diegocoll/top_level_pcb/Modulo de alimentador/Imágenes/Diagrama_Circuital.PNG

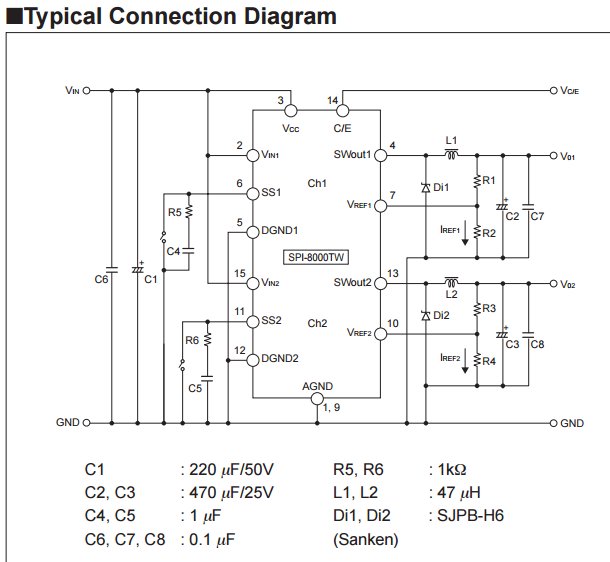
Modulo de alimentador/Imágenes/Diagrama_Circuital.PNG
