diegocoll/top_level_pcb/Modulo de alimentador/Imágenes/Regulador.PNG

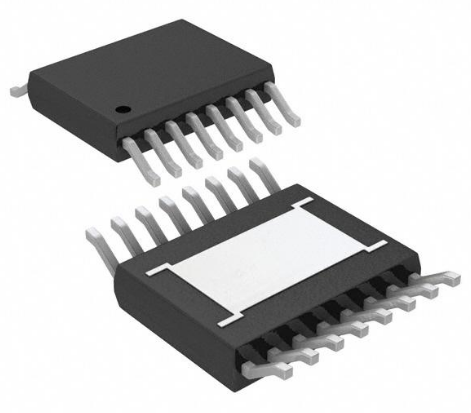
Modulo de alimentador/Imágenes/Regulador.PNG
