diegocoll/top_level_pcb/Modulo de alimentador/Imágenes/render01.png

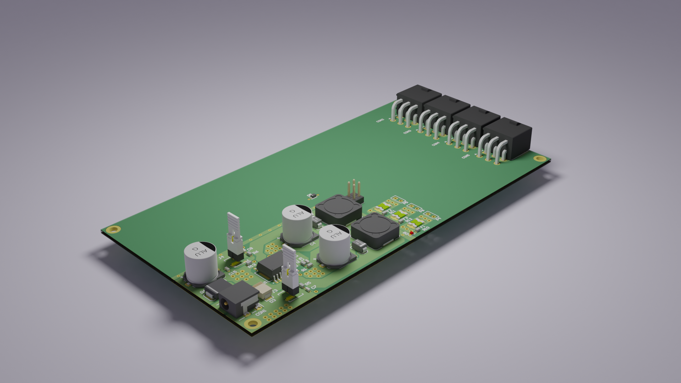
Modulo de alimentador/Imágenes/render01.png
