diegocoll/top_level_pcb/Modulo de alimentador/Imágenes/render02.png

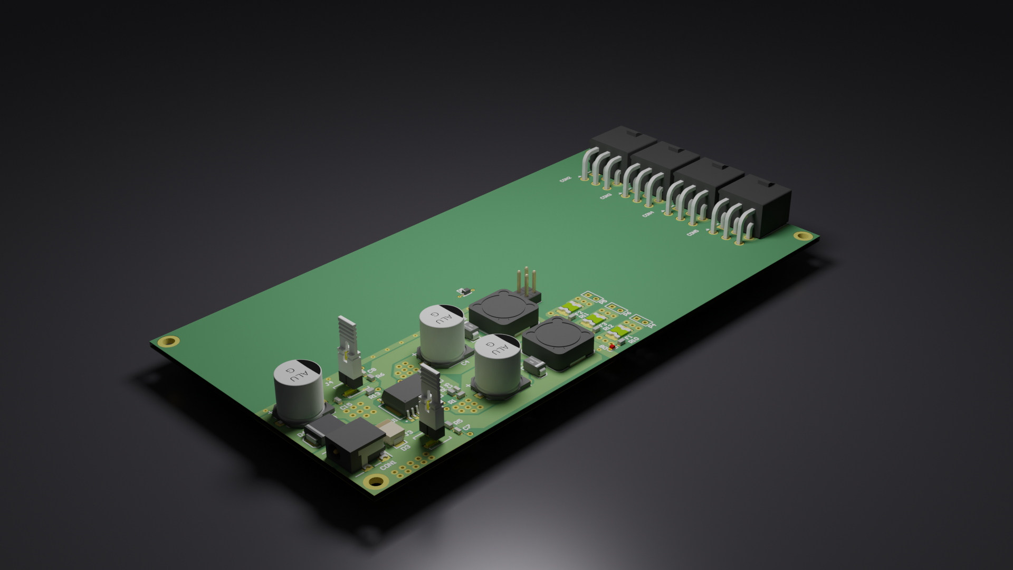
Modulo de alimentador/Imágenes/render02.png
