diegocoll/top_level_pcb/Modulo de comunicación/Imágenes/PDN_modulo_comunicacion.png

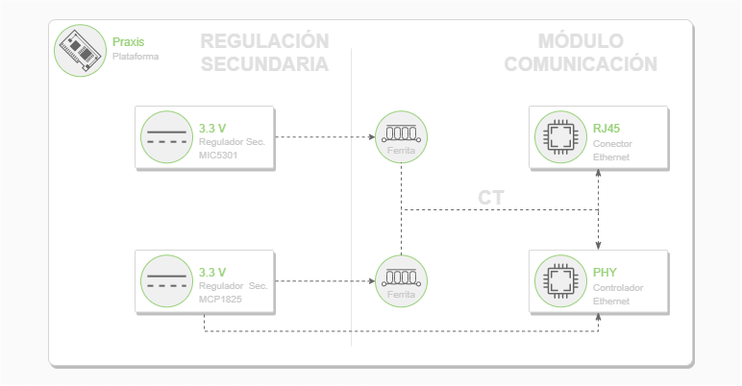
Modulo de comunicación/Imágenes/PDN_modulo_comunicacion.png
