diegocoll/top_level_pcb/Modulo de comunicación/Imágenes/PDN_modulo_comunicacion_01.png

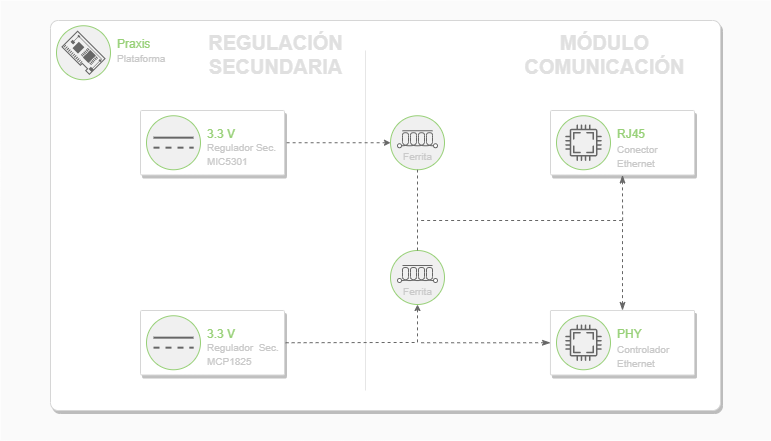
Modulo de comunicación/Imágenes/PDN_modulo_comunicacion_01.png
