diegocoll/top_level_pcb/Modulo de comunicación/Imágenes/perspectiva .png

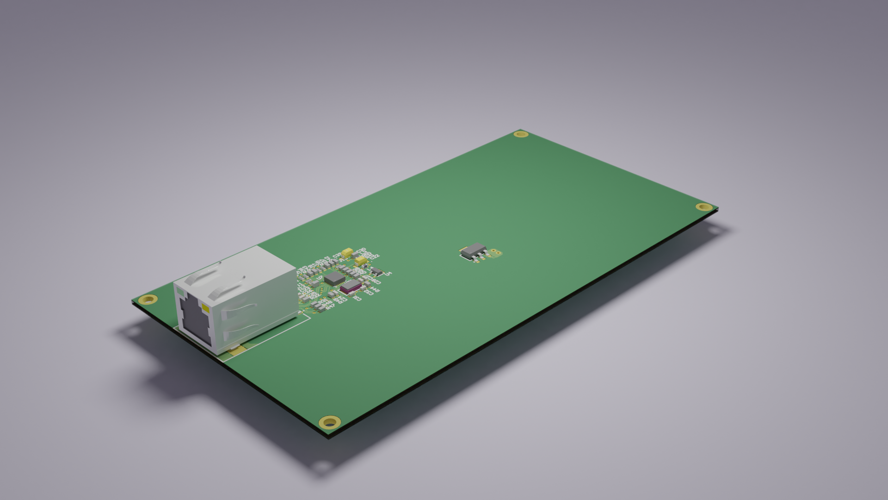
Modulo de comunicación/Imágenes/perspectiva .png
