diegocoll/top_level_pcb/Modulo de programador/Imágenes/Render.png

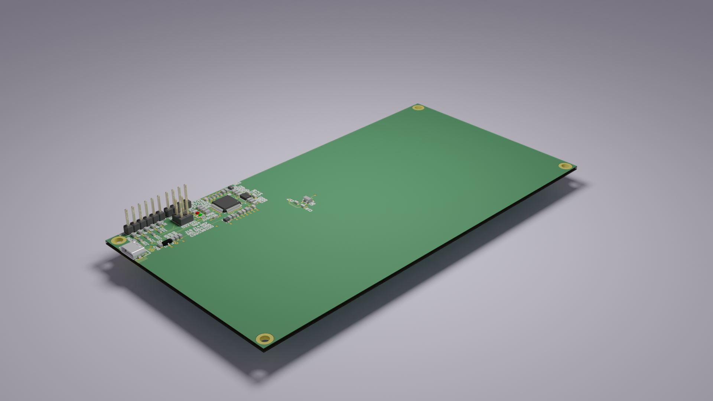
Modulo de programador/Imágenes/Render.png
