diegocoll/top_level_pcb/Modulo de alimentador/Altium/Componentes/CAP_PCE4009CT/EEEFC1E471P.STEP

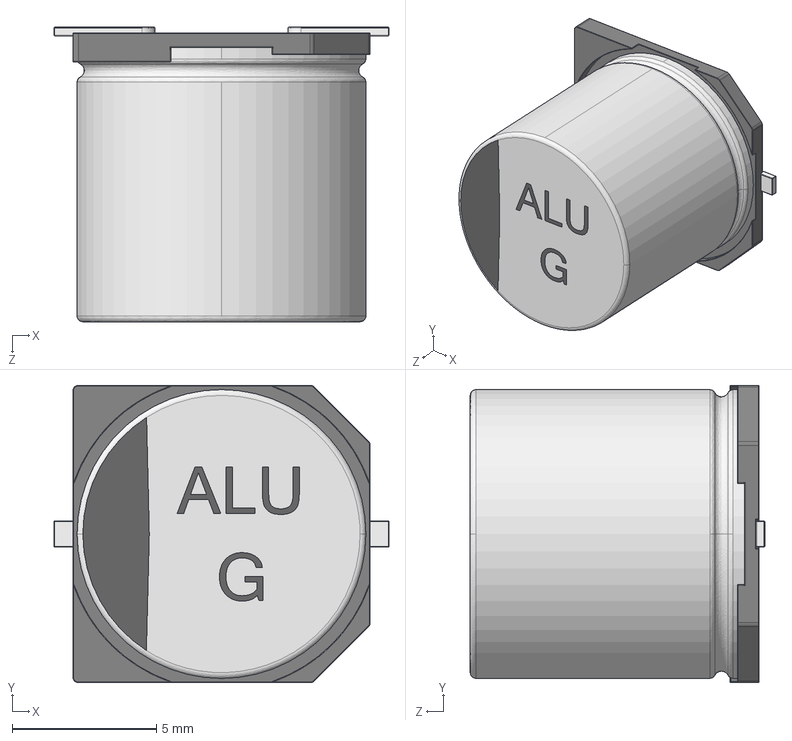
[picture p11: CAD file, 2021-07-18]
Modulo de alimentador/Altium/Componentes/CAP_PCE4009CT/EEEFC1E471P.STEP
11.6 x 10.3 x 10.2 mm
Pins_1
Fuss_1
K_X_F6rper_1
Beschriftung_1
