diegocoll/top_level_pcb/Modulo de alimentador/Altium/Componentes/INDUCTOR_SMD_1240/SRR1240.STEP

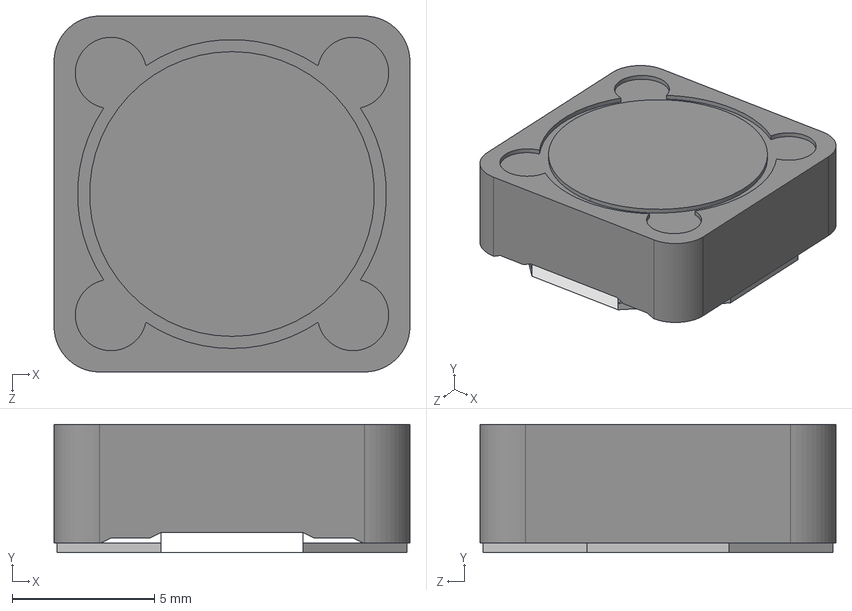
[picture p12: CAD file, 2021-07-18]
Modulo de alimentador/Altium/Componentes/INDUCTOR_SMD_1240/SRR1240.STEP
12.5 x 4.50 x 12.5 mm
