diegocoll/top_level_pcb/Modulo de alimentador/Altium/Componentes/JUMPER/TSM-102-01-L-SV-TR.stp

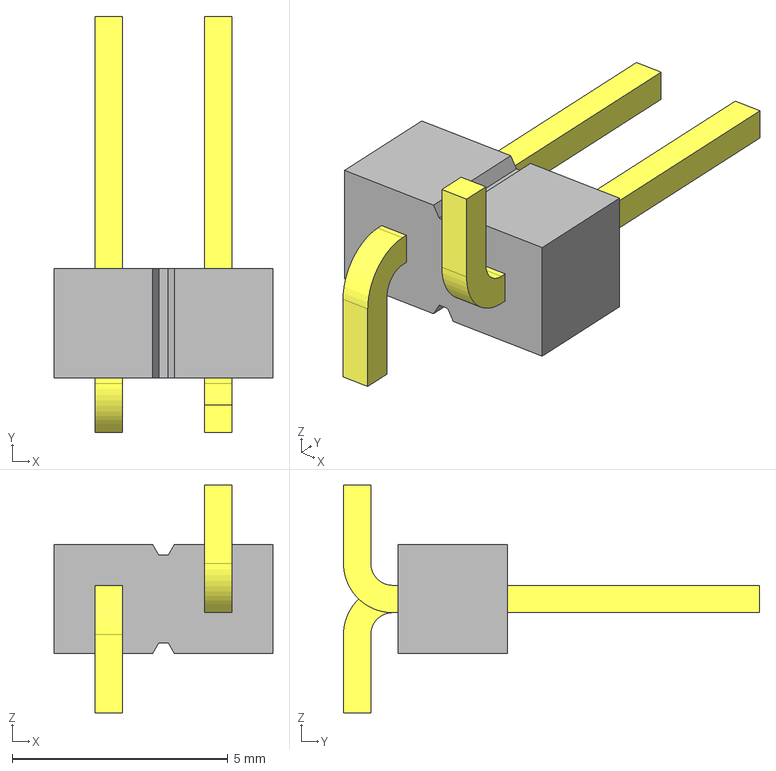
[picture p13: CAD file, 2021-07-18]
Modulo de alimentador/Altium/Componentes/JUMPER/TSM-102-01-L-SV-TR.stp
5.08 x 9.65 x 5.28 mm
_TSM-102-01-SV_body
_T-1S6-16(-01-2-SV)
