diegocoll/top_level_pcb/Modulo de alimentador/Altium/Componentes/LD3985M33R/2020-03-27_06-20-10/STEP/SOT23-5L-L.step

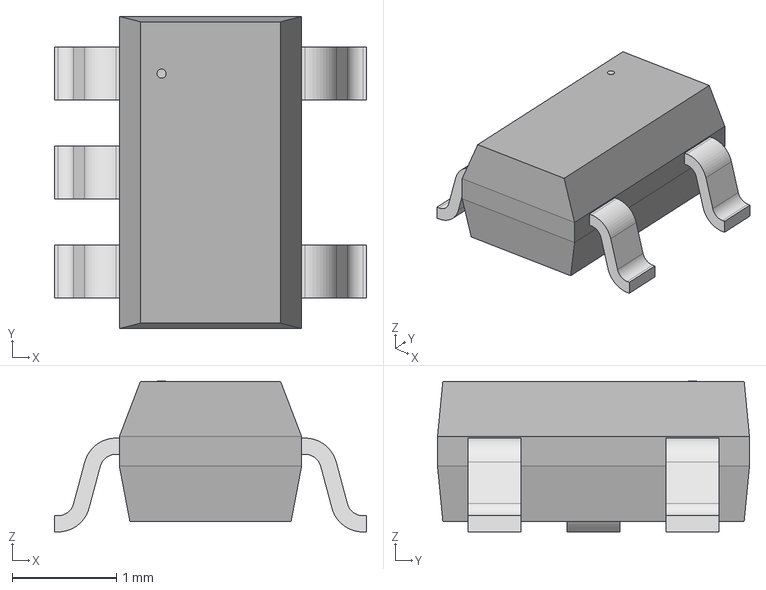
[picture p14: CAD file, 2021-07-18]
Modulo de alimentador/Altium/Componentes/LD3985M33R/2020-03-27_06-20-10/STEP/SOT23-5L-L.step
3.00 x 3.00 x 1.45 mm
