diegocoll/top_level_pcb/Modulo de alimentador/Altium/Componentes/MCP1825S-3302E/2020-03-27_02-06-16/STEP/SOT-223_3MC-M.step

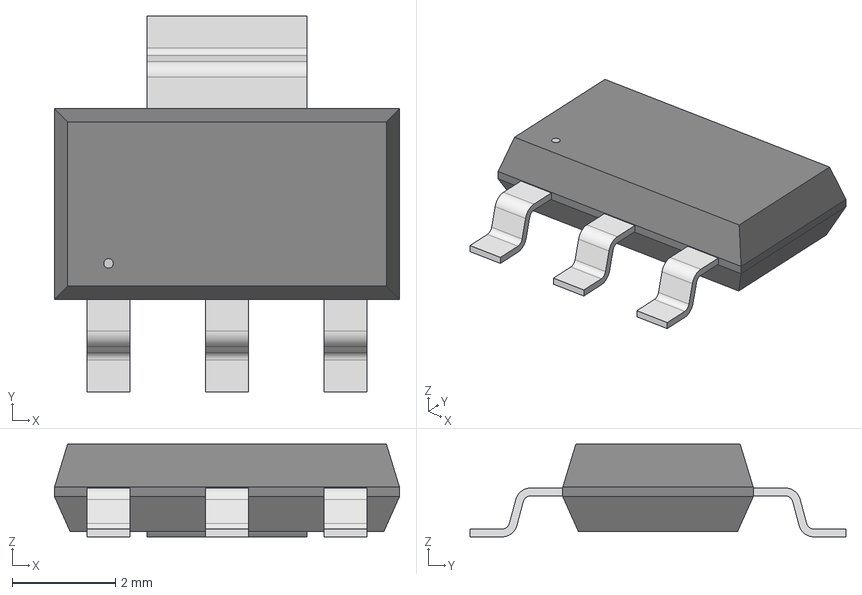
[picture p15: CAD file, 2021-07-18]
Modulo de alimentador/Altium/Componentes/MCP1825S-3302E/2020-03-27_02-06-16/STEP/SOT-223_3MC-M.step
6.70 x 7.30 x 1.80 mm
