diegocoll/top_level_pcb/Modulo de alimentador/Altium/Componentes/MIC5301-3.3YD5-TR/2020-03-27_05-35-59/STEP/TSOT-23-5_D5-L.step

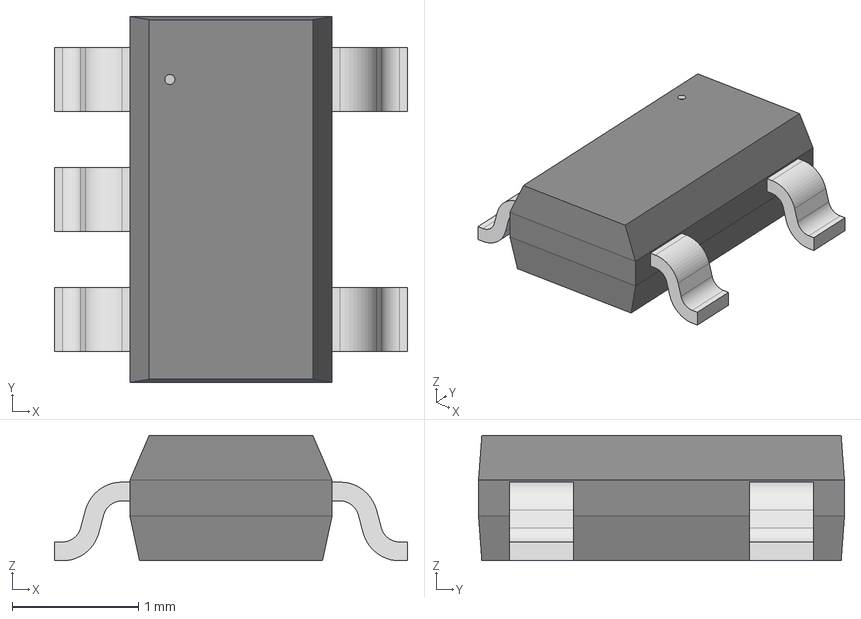
[picture p16: CAD file, 2021-07-18]
Modulo de alimentador/Altium/Componentes/MIC5301-3.3YD5-TR/2020-03-27_05-35-59/STEP/TSOT-23-5_D5-L.step
2.79 x 2.90 x 0.993 mm
