diegocoll/top_level_pcb/Modulo de alimentador/Altium/Componentes/SPI-8001TW/SPI-8001TW.STEP

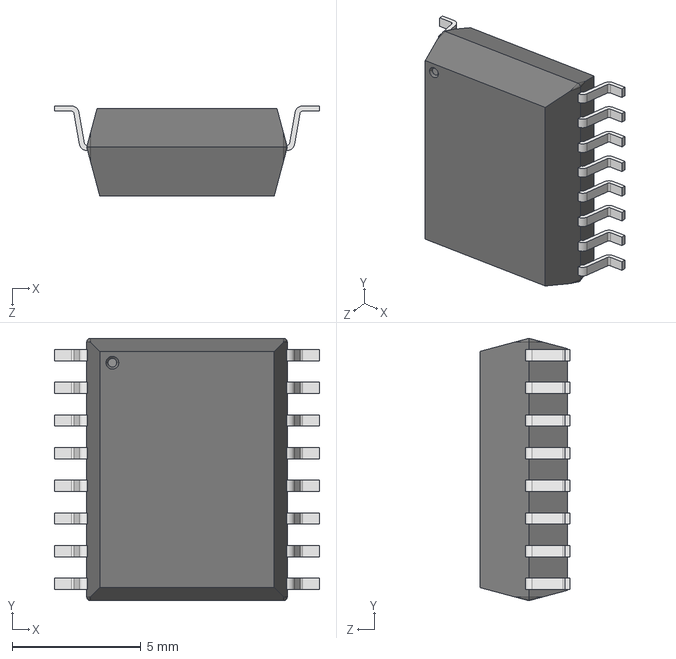
[picture p17: CAD file, 2021-07-18]
Modulo de alimentador/Altium/Componentes/SPI-8001TW/SPI-8001TW.STEP
10.3 x 10.2 x 3.50 mm
