diegocoll/top_level_pcb/Modulo de alimentador/Altium/Componentes/SS26SHE3_AH/ss26s.STEP

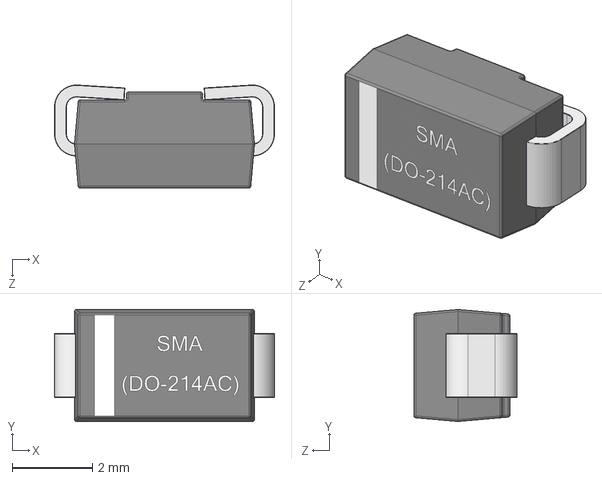
[picture p18: CAD file, 2021-07-18]
Modulo de alimentador/Altium/Componentes/SS26SHE3_AH/ss26s.STEP
5.50 x 2.80 x 2.57 mm
