diegocoll/top_level_pcb/Modulo de comunicación/Altium/Componentes/ARJE-0034/ARJE-0034.STEP

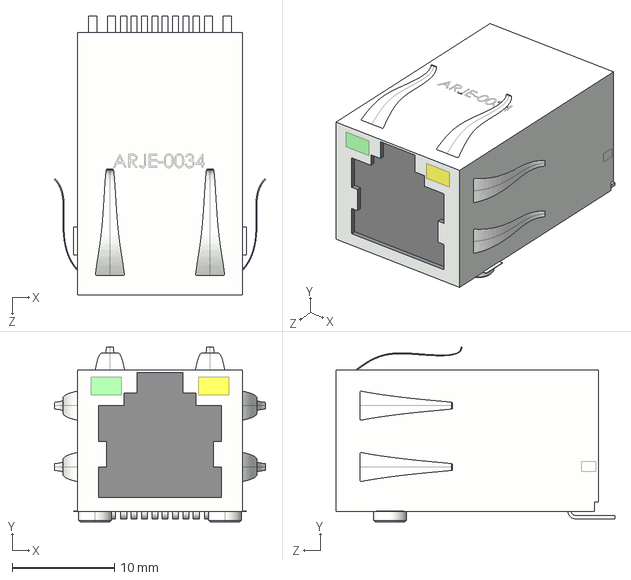
[picture p19: CAD file, 2021-07-18]
Modulo de comunicación/Altium/Componentes/ARJE-0034/ARJE-0034.STEP
20.7 x 17.1 x 27.3 mm
