diegocoll/top_level_pcb/Modulo de comunicación/Altium/Componentes/GLRF1608T101M-LR/FB_1608.STEP

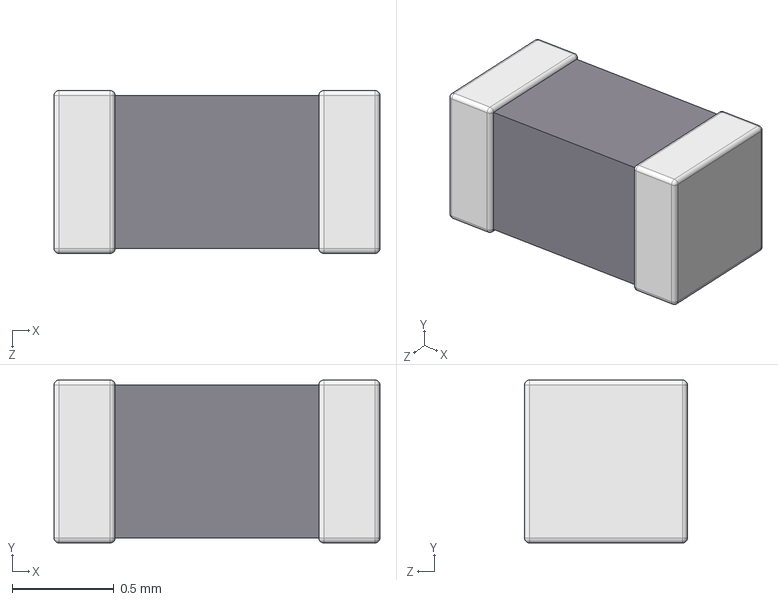
[picture p20: CAD file, 2021-07-18]
Modulo de comunicación/Altium/Componentes/GLRF1608T101M-LR/FB_1608.STEP
1.60 x 0.8 x 0.8 mm
