diegocoll/top_level_pcb/Modulo de comunicación/Altium/Componentes/LAN8742A-CZ/2020-03-28_05-44-17/STEP/SQFN24_4X4MC.step

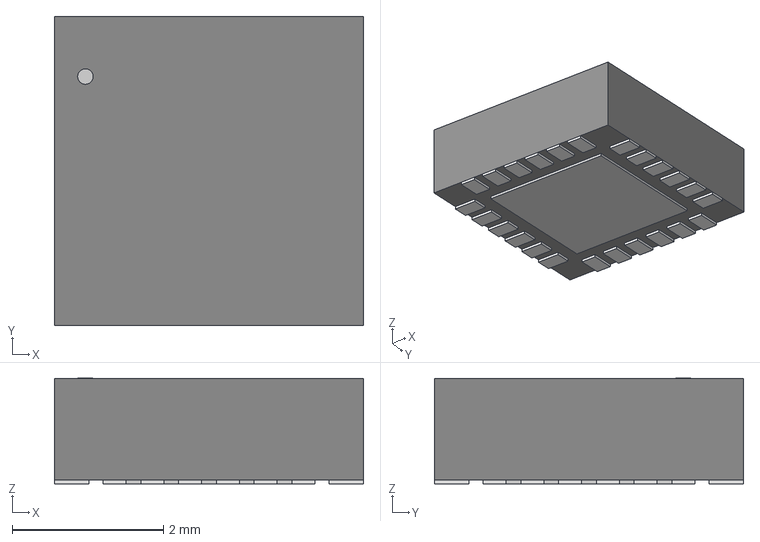
[picture p21: CAD file, 2021-07-18]
Modulo de comunicación/Altium/Componentes/LAN8742A-CZ/2020-03-28_05-44-17/STEP/SQFN24_4X4MC.step
4.09 x 4.09 x 1.40 mm
