diegocoll/top_level_pcb/Modulo de extensiones/Altium/Componentes/MICROSMD110F2/User Library-Polyswitch_micro.STEP

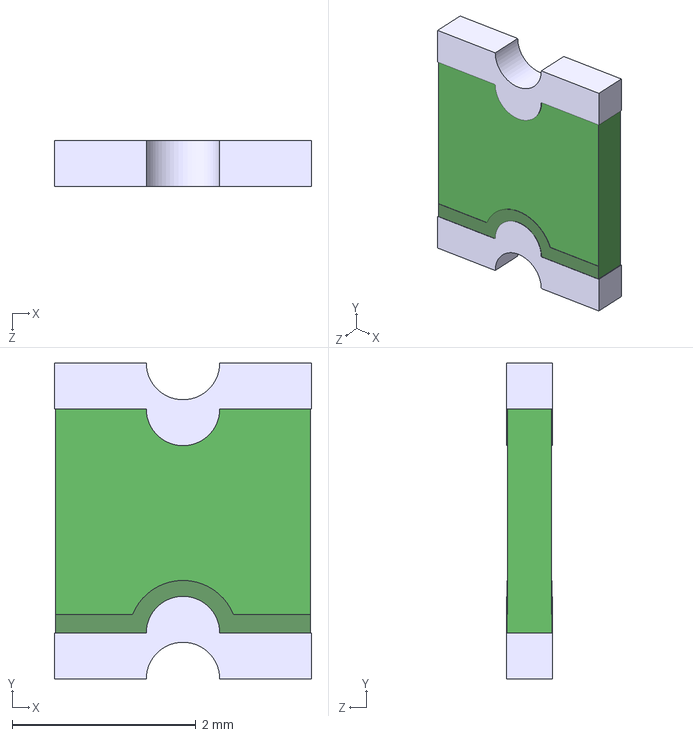
[picture p22: CAD file, 2021-07-18]
Modulo de extensiones/Altium/Componentes/MICROSMD110F2/User Library-Polyswitch_micro.STEP
2.80 x 3.44 x 0.5 mm
