diegocoll/top_level_pcb/Modulo de extensiones/Altium/Componentes/MINISMDC110F16-2/MINISMDC110F2.STEP

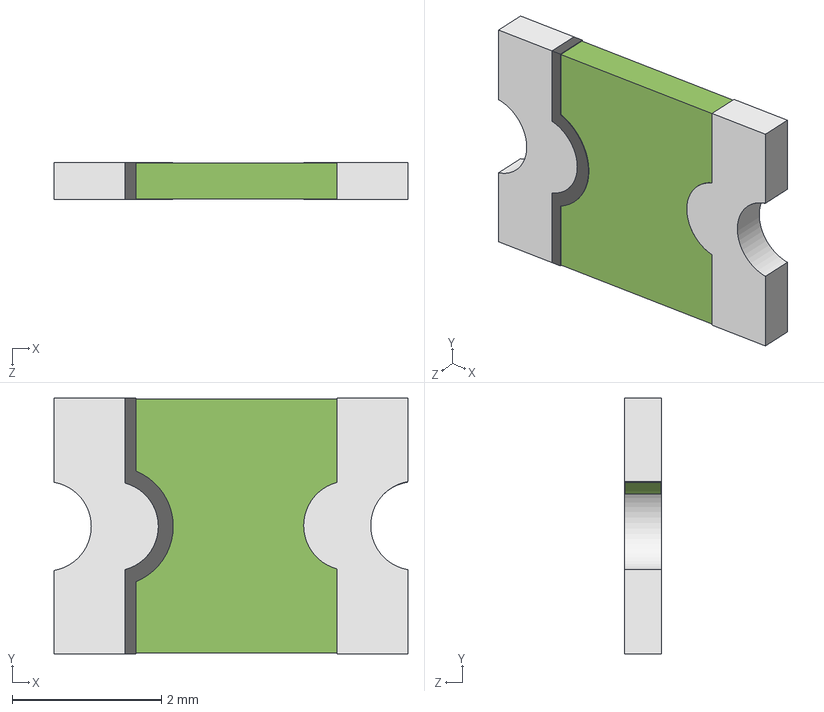
[picture p23: CAD file, 2021-07-18]
Modulo de extensiones/Altium/Componentes/MINISMDC110F16-2/MINISMDC110F2.STEP
4.75 x 3.43 x 0.5 mm
corp
MARQUAGE
