diegocoll/top_level_pcb/Modulo de programador/Altium/Componentes/BSR14/BSR14CT-ND-SOT-23_214.STEP

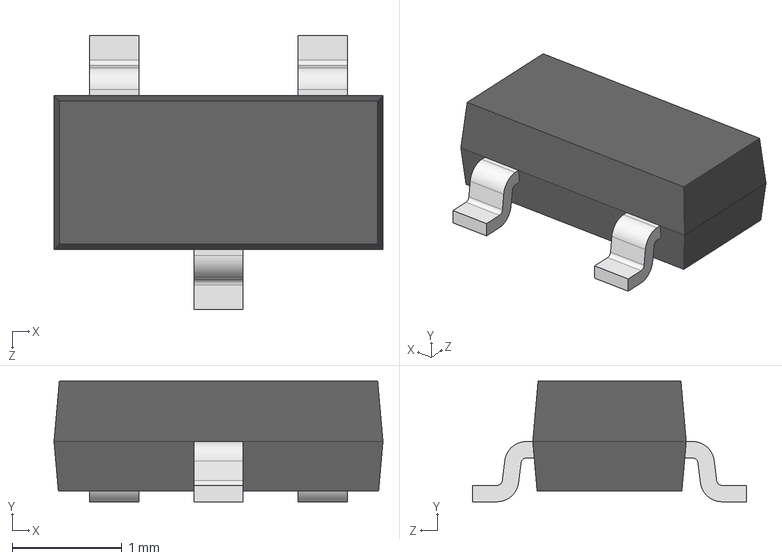
[picture p24: CAD file, 2021-07-18]
Modulo de programador/Altium/Componentes/BSR14/BSR14CT-ND-SOT-23_214.STEP
3.00 x 1.10 x 2.50 mm
