diegocoll/top_level_pcb/Modulo de programador/Altium/Componentes/HEADER_1X6/1x6 TH Pitch 2_54mm.STEP

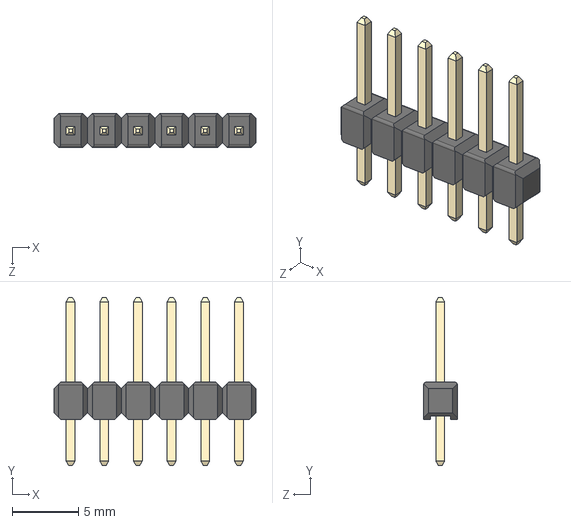
[picture p25: CAD file, 2021-07-18]
Modulo de programador/Altium/Componentes/HEADER_1X6/1x6 TH Pitch 2_54mm.STEP
15.2 x 12.7 x 2.54 mm
holder
pin x 6
