diegocoll/top_level_pcb/Modulo de programador/Altium/Componentes/JUMPER_SMD_0603/yageo_resistor_0603.STEP

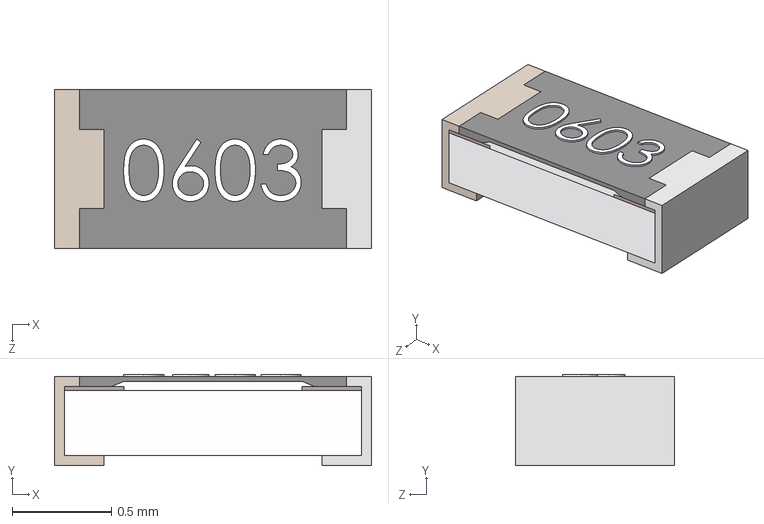
[picture p26: CAD file, 2021-07-18]
Modulo de programador/Altium/Componentes/JUMPER_SMD_0603/yageo_resistor_0603.STEP
1.60 x 0.46 x 0.8 mm
