diegocoll/top_level_pcb/Modulo de programador/Altium/Componentes/LTST-C191KRKT/LTST-C191KRKT.STEP

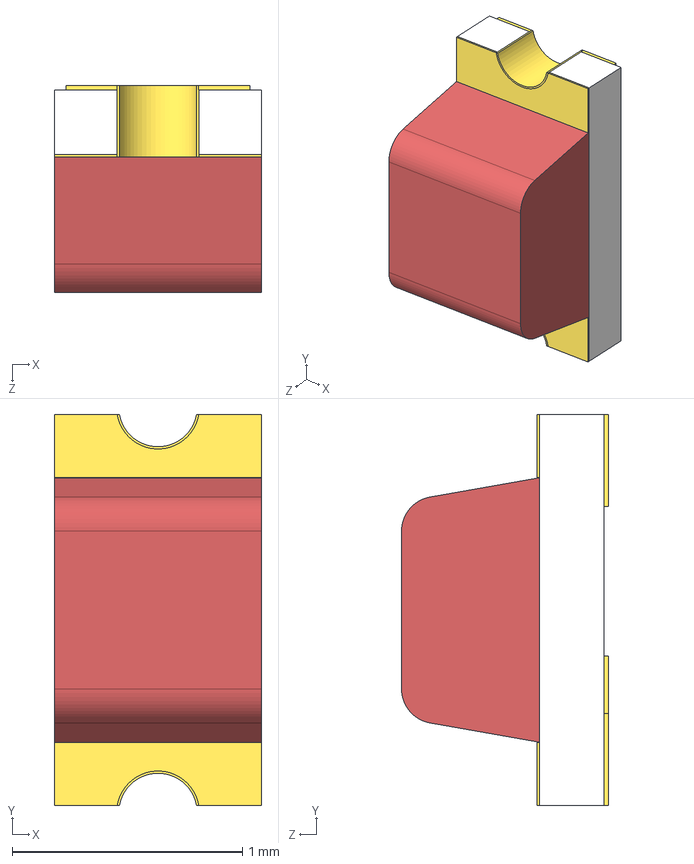
[picture p27: CAD file, 2021-07-18]
Modulo de programador/Altium/Componentes/LTST-C191KRKT/LTST-C191KRKT.STEP
0.9 x 1.70 x 0.9 mm
Lens
