diegocoll/top_level_pcb/Modulo de programador/Altium/Componentes/LTST-C191TGKT/2020-03-28_23-27-57/STEP/LED_LTW-C193TS5-L.step

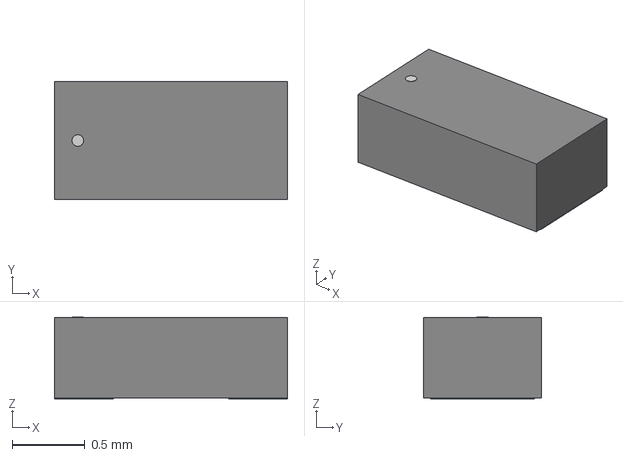
[picture p28: CAD file, 2021-07-18]
Modulo de programador/Altium/Componentes/LTST-C191TGKT/2020-03-28_23-27-57/STEP/LED_LTW-C193TS5-L.step
1.60 x 0.812 x 0.561 mm
