diegocoll/top_level_pcb/Modulo de programador/Altium/Componentes/NX3225GD-8MHZ/2020-03-29_20-06-20/STEP/XTAL_NX3225GD-8MHZ-STD-CRA-3-M.step

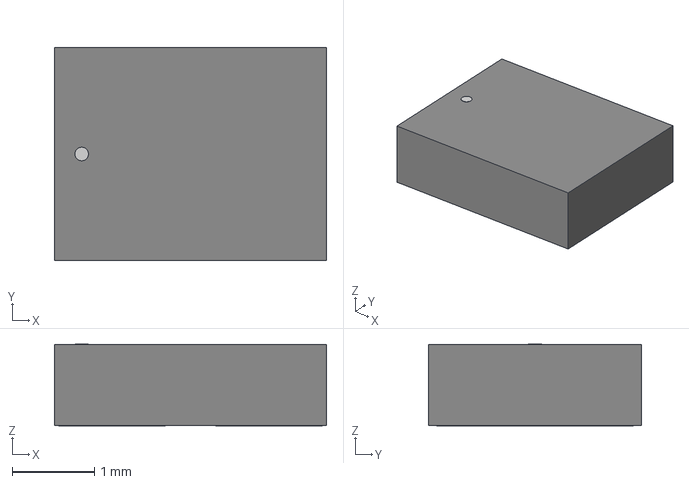
[picture p29: CAD file, 2021-07-18]
Modulo de programador/Altium/Componentes/NX3225GD-8MHZ/2020-03-29_20-06-20/STEP/XTAL_NX3225GD-8MHZ-STD-CRA-3-M.step
3.30 x 2.59 x 0.993 mm
