diegocoll/top_level_pcb/Modulo de programador/Altium/Componentes/PMEG1030EJ/2020-03-29_19-02-12/STEP/SOD323F-M.step

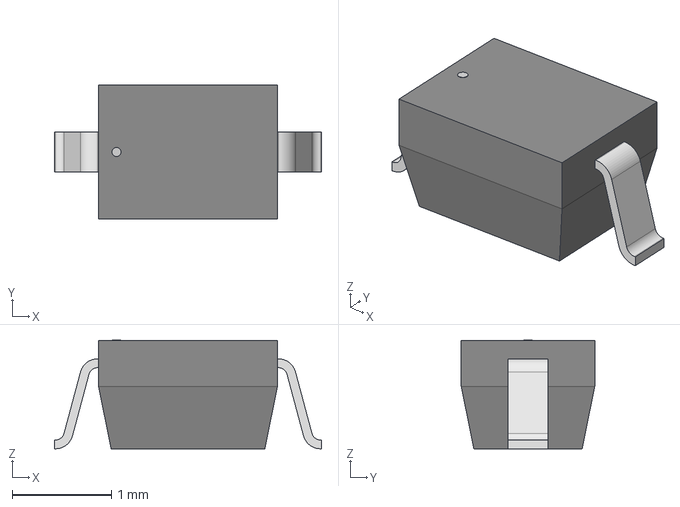
[picture p30: CAD file, 2021-07-18]
Modulo de programador/Altium/Componentes/PMEG1030EJ/2020-03-29_19-02-12/STEP/SOD323F-M.step
2.69 x 1.35 x 1.09 mm
