diegocoll/top_level_pcb/Modulo de programador/Altium/Componentes/PMEG1030EJ/PMEG1030EJ.STEP

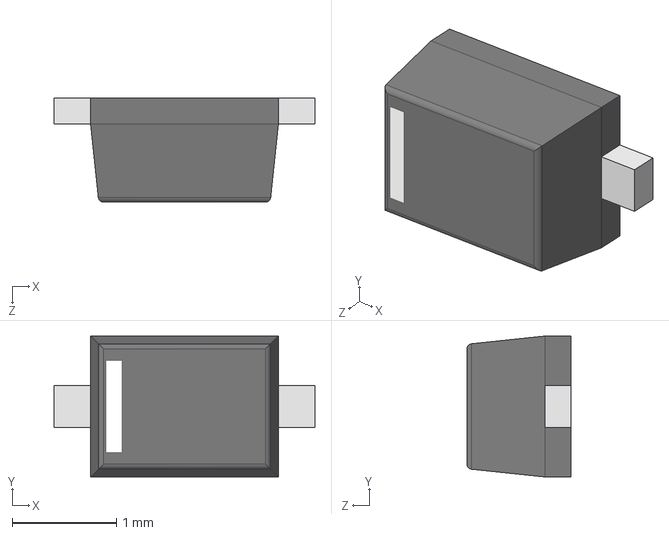
[picture p31: CAD file, 2021-07-18]
Modulo de programador/Altium/Componentes/PMEG1030EJ/PMEG1030EJ.STEP
2.50 x 1.35 x 1.00 mm
