diegocoll/top_level_pcb/Modulo de programador/Altium/Componentes/STM32F103CBT6/2020-03-28_20-59-40/STEP/LQFP-48-M.step

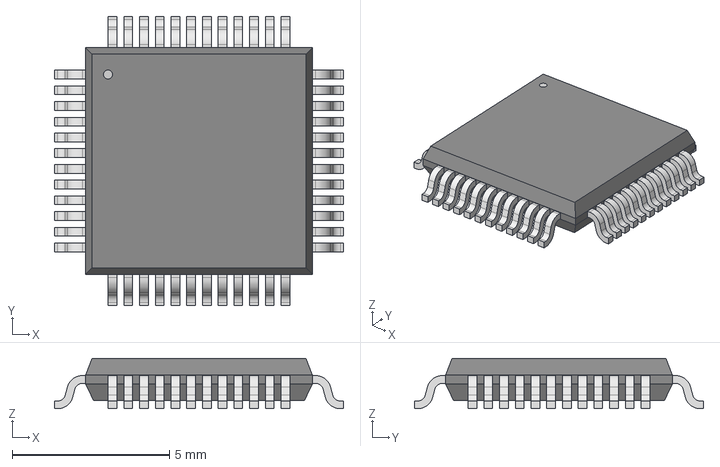
[picture p32: CAD file, 2021-07-18]
Modulo de programador/Altium/Componentes/STM32F103CBT6/2020-03-28_20-59-40/STEP/LQFP-48-M.step
9.19 x 9.19 x 1.60 mm
