diegocoll/top_level_pcb/Modulo de programador/Altium/Componentes/USB_1051640001/USB_1051640001.STEP

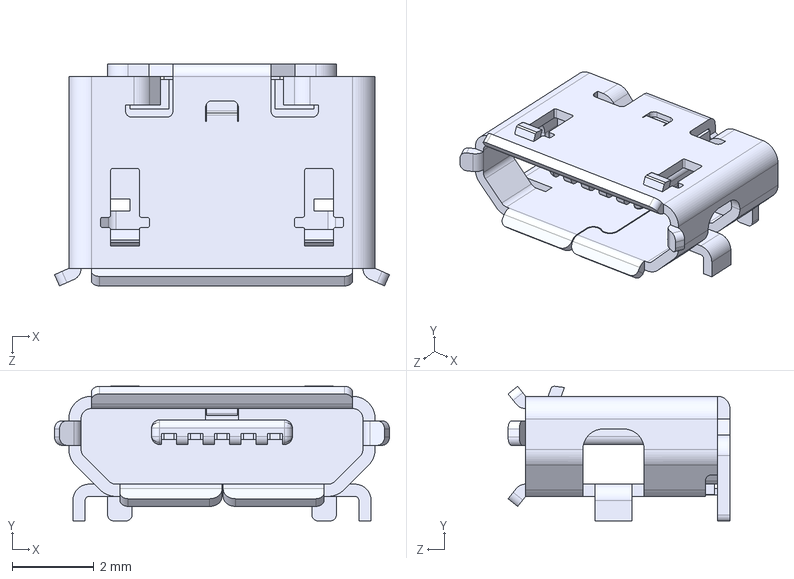
[picture p33: CAD file, 2021-07-18]
Modulo de programador/Altium/Componentes/USB_1051640001/USB_1051640001.STEP
8.20 x 3.30 x 5.43 mm
