diegocoll/top_level_pcb/Modulo de alimentador/Altium/Componentes/INDUCTOR_SMD_1240/SRR1240-470M.stp

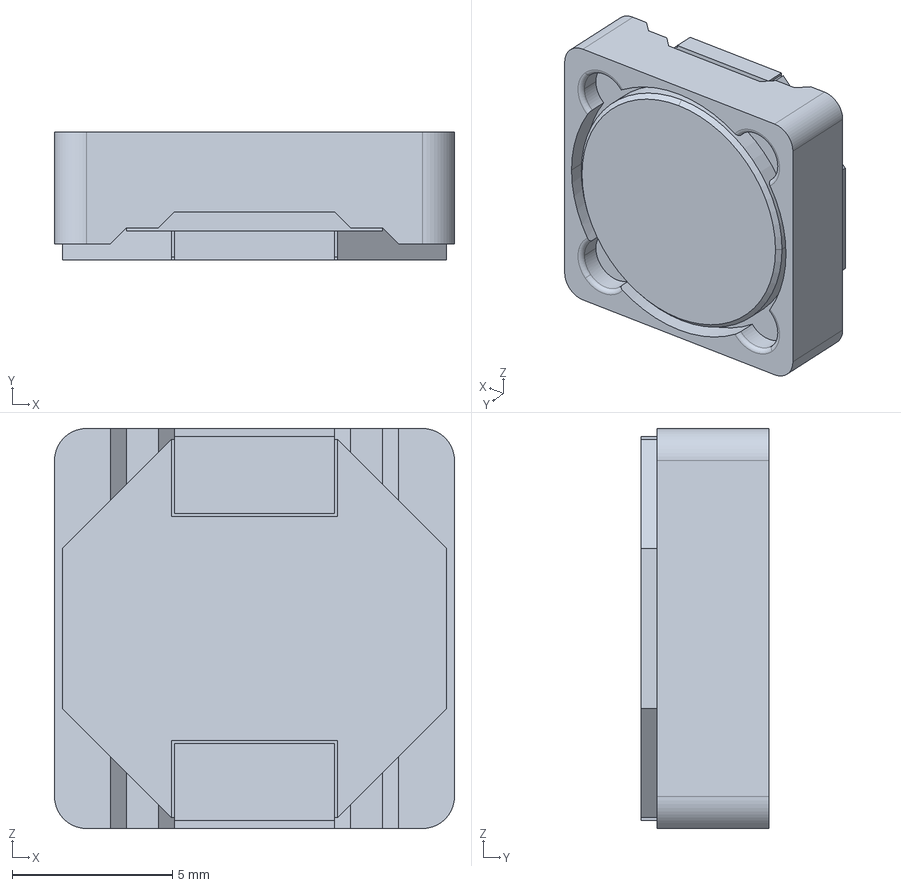
[picture p34: CAD file, 2021-07-18]
Modulo de alimentador/Altium/Componentes/INDUCTOR_SMD_1240/SRR1240-470M.stp
12.5 x 4.00 x 12.5 mm
