diegocoll/top_level_pcb/Modulo de alimentador/Altium/Componentes/JUMPER/jumper_black.stp

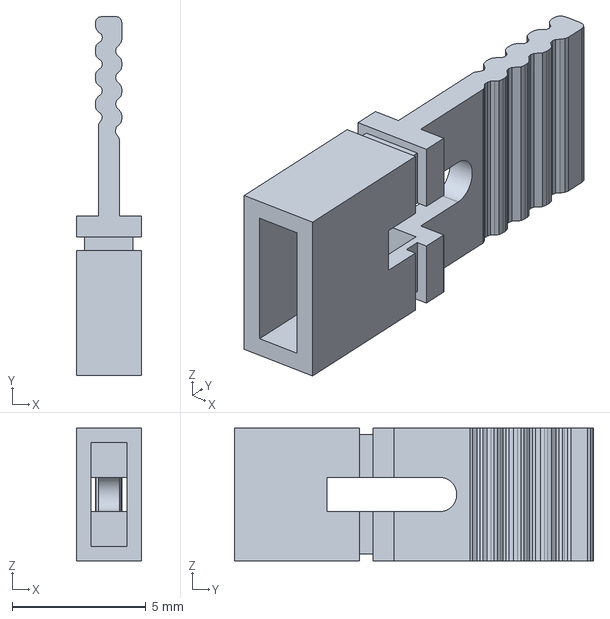
[picture p35: CAD file, 2021-07-18]
Modulo de alimentador/Altium/Componentes/JUMPER/jumper_black.stp
2.42 x 13.4 x 4.97 mm
