diegocoll/top_level_pcb/Modulo de extensiones/Altium/Componentes/CONN_HEADER_RA_6POS/6PIN_PWR.STEP

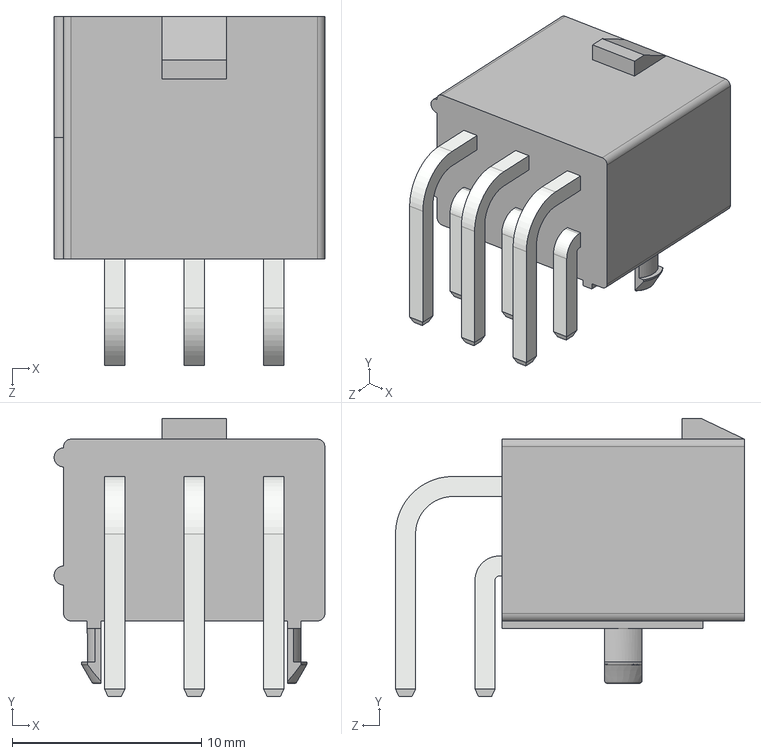
[picture p36: CAD file, 2021-07-18]
Modulo de extensiones/Altium/Componentes/CONN_HEADER_RA_6POS/6PIN_PWR.STEP
14.3 x 14.7 x 18.4 mm
