diegocoll/top_level_pcb/Modulo de extensiones/Altium/Componentes/MINISMDC110F2/Fuse_Littelfuse_MINISMDC110F-2_eec.STEP

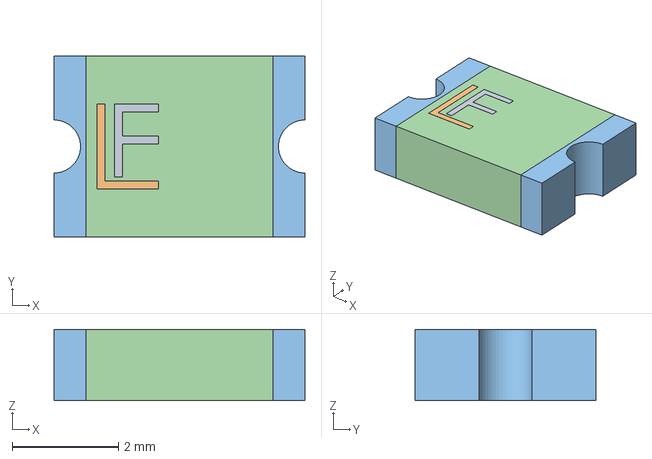
[picture p37: CAD file, 2021-07-18]
Modulo de extensiones/Altium/Componentes/MINISMDC110F2/Fuse_Littelfuse_MINISMDC110F-2_eec.STEP
4.73 x 3.41 x 1.34 mm
