diegocoll/top_level_pcb/Modulo de programador/Altium/Componentes/JUMPER_SMD_0603/GENERIC_0603.stp

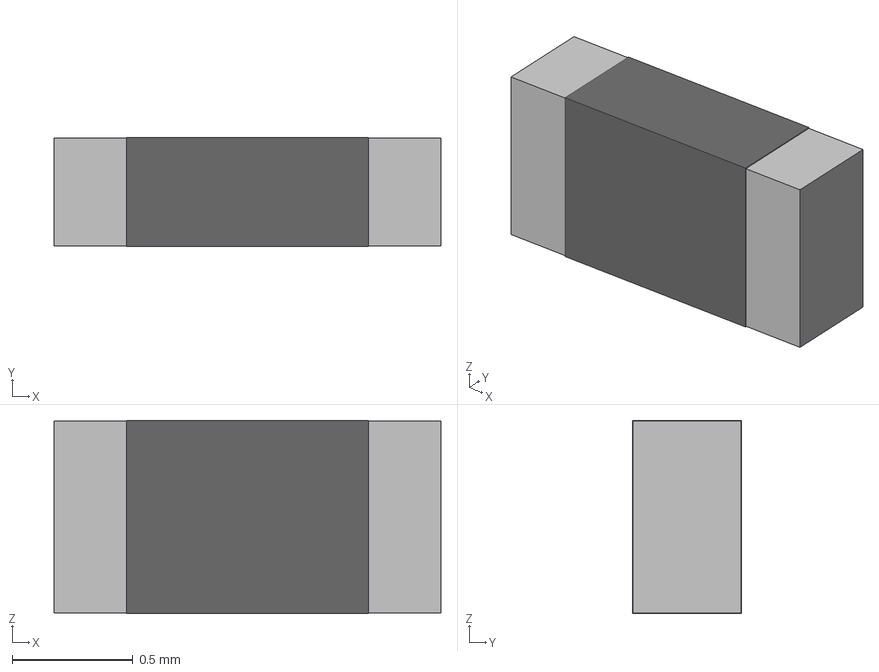
[picture p38: CAD file, 2021-07-18]
Modulo de programador/Altium/Componentes/JUMPER_SMD_0603/GENERIC_0603.stp
1.60 x 0.45 x 0.8 mm
