diegocoll/top_level_pcb/Modulo de alimentador/Altium/Componentes/JUMPER/2pin_Header_SMD.STEP

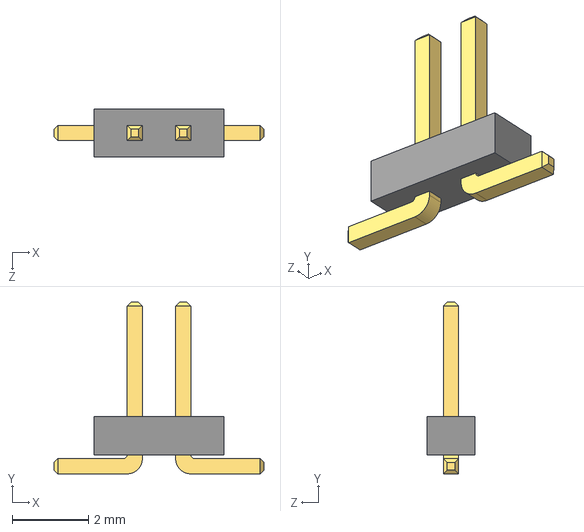
[picture p39: CAD file, 2021-07-18]
Modulo de alimentador/Altium/Componentes/JUMPER/2pin_Header_SMD.STEP
5.50 x 4.50 x 1.27 mm
