diegocoll/top_level_pcb/Modulo de alimentador/Altium/Componentes/JUMPER/Header1x2_thughole.STEP

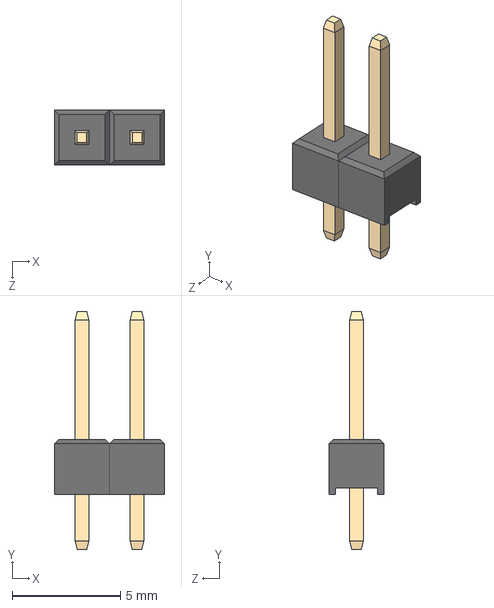
[picture p40: CAD file, 2021-07-18]
Modulo de alimentador/Altium/Componentes/JUMPER/Header1x2_thughole.STEP
5.08 x 11.0 x 2.54 mm
Header1_1 x 2
