diegocoll/top_level_pcb/(list of files, cad)

Other CAD files:
Modulo de programador/Altium/Componentes/LTST-C191KSKT/User Library-LTST-C190TBKT.STL
Modulo de programador/Altium/Componentes/LTST-C191TGKT/LTST-C191TGKT.STEP
Modulo de alimentador/Altium/Componentes/LD3985M33R/2020-03-27_06-20-10/STEP/SOT23-5L.step
Modulo de alimentador/Altium/Componentes/MCP1825S-3302E/2020-03-27_02-06-16/STEP/SOT-223_3MC.step
Modulo de alimentador/Altium/Componentes/MIC5301-3.3YD5-TR/2020-03-27_05-35-59/STEP/TSOT-23-5_D5.step
Modulo de comunicación/Altium/Componentes/LAN8742A-CZ/2020-03-28_05-44-17/STEP/SQFN24_4X4MC-L.step
Modulo de programador/Altium/Componentes/LTST-C191KSKT/LTST-C191KSKT.STEP
Modulo de programador/Altium/Componentes/LTST-C191TGKT/2020-03-28_23-27-57/STEP/LED_LTW-C193TS5-M.step
Modulo de programador/Altium/Componentes/NX3225GD-8MHZ/2020-03-29_20-06-20/STEP/XTAL_NX3225GD-8MHZ-STD-CRA-3.step
Modulo de programador/Altium/Componentes/PMEG1030EJ/2020-03-29_19-02-12/STEP/SOD323F-L.step
Modulo de programador/Altium/Componentes/STM32F103CBT6/2020-03-28_20-59-40/STEP/LQFP-48.step
Modulo de alimentador/Altium/Componentes/LD3985M33R/2020-03-27_06-20-10/STEP/SOT23-5L-M.step
Modulo de alimentador/Altium/Componentes/MCP1825S-3302E/2020-03-27_02-06-16/STEP/SOT-223_3MC-L.step
Modulo de alimentador/Altium/Componentes/MIC5301-3.3YD5-TR/2020-03-27_05-35-59/STEP/TSOT-23-5_D5-M.step
Modulo de comunicación/Altium/Componentes/LAN8742A-CZ/2020-03-28_05-44-17/STEP/SQFN24_4X4MC-M.step
Modulo de programador/Altium/Componentes/LTST-C191TGKT/2020-03-28_23-27-57/STEP/LED_LTW-C193TS5.step
Modulo de programador/Altium/Componentes/NX3225GD-8MHZ/2020-03-29_20-06-20/STEP/XTAL_NX3225GD-8MHZ-STD-CRA-3-L.step
Modulo de programador/Altium/Componentes/PMEG1030EJ/2020-03-29_19-02-12/STEP/SOD323F.step
Modulo de programador/Altium/Componentes/STM32F103CBT6/2020-03-28_20-59-40/STEP/LQFP-48-L.step
Modulo de alimentador/Altium/Componentes/694103107102/694102107102.stp
Modulo de extensiones/Altium/Componentes/CONN_HEADER_RA_6POS/45558-0003.stp
