diegocoll/top_level_pcb/manufacturing_file.pdf

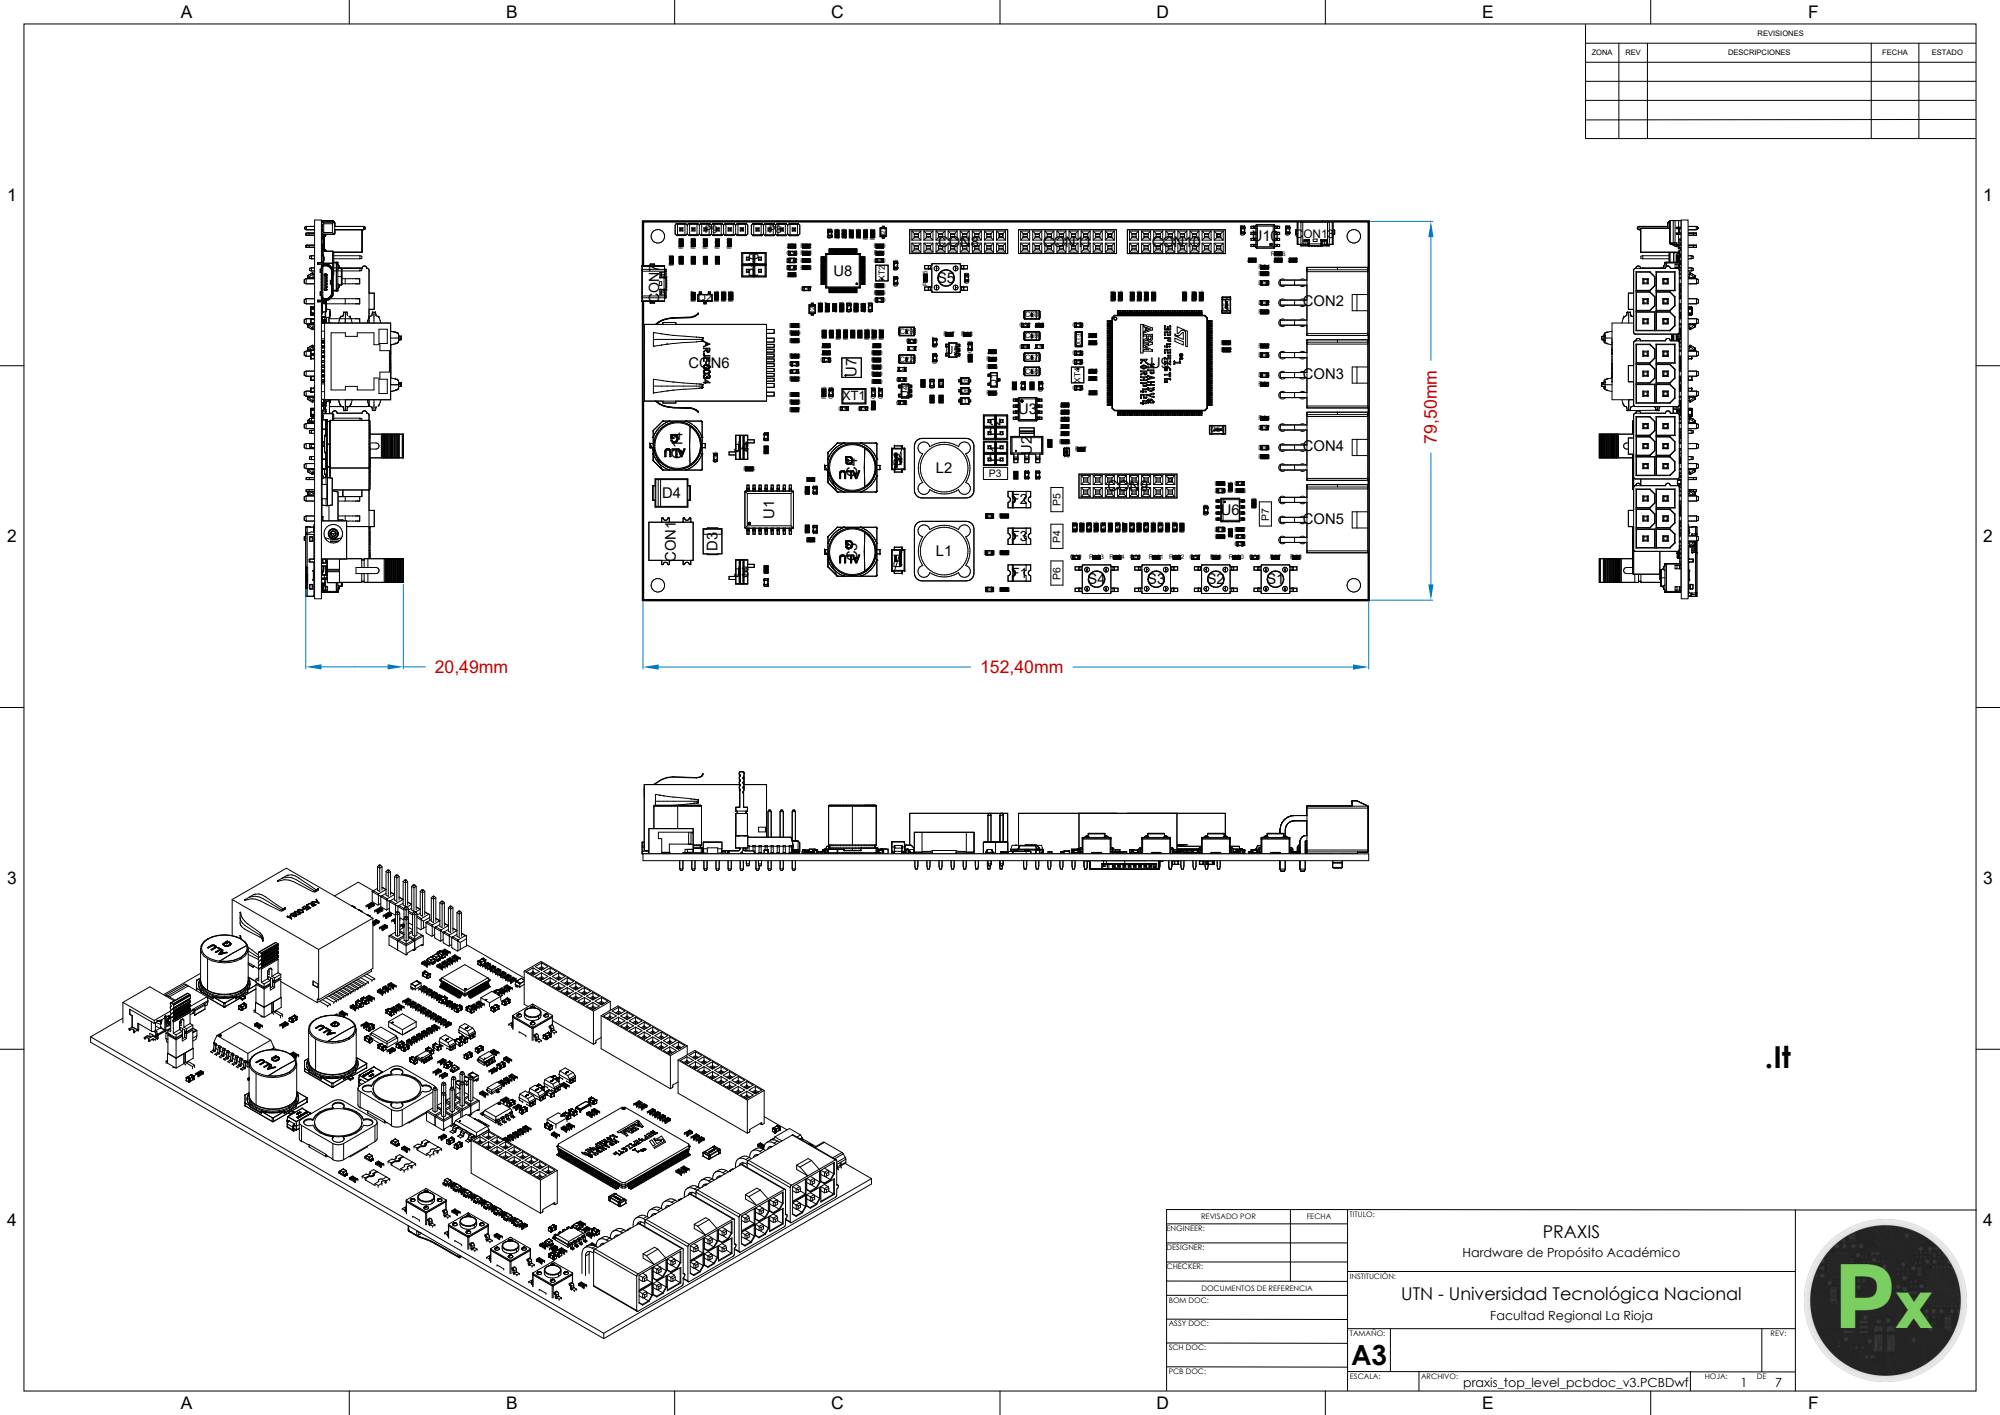
[picture p41: page 1]

Hardware de Propósito Académico
UTN - Universidad Tecnológica Nacional

Facultad Regional La Rioja

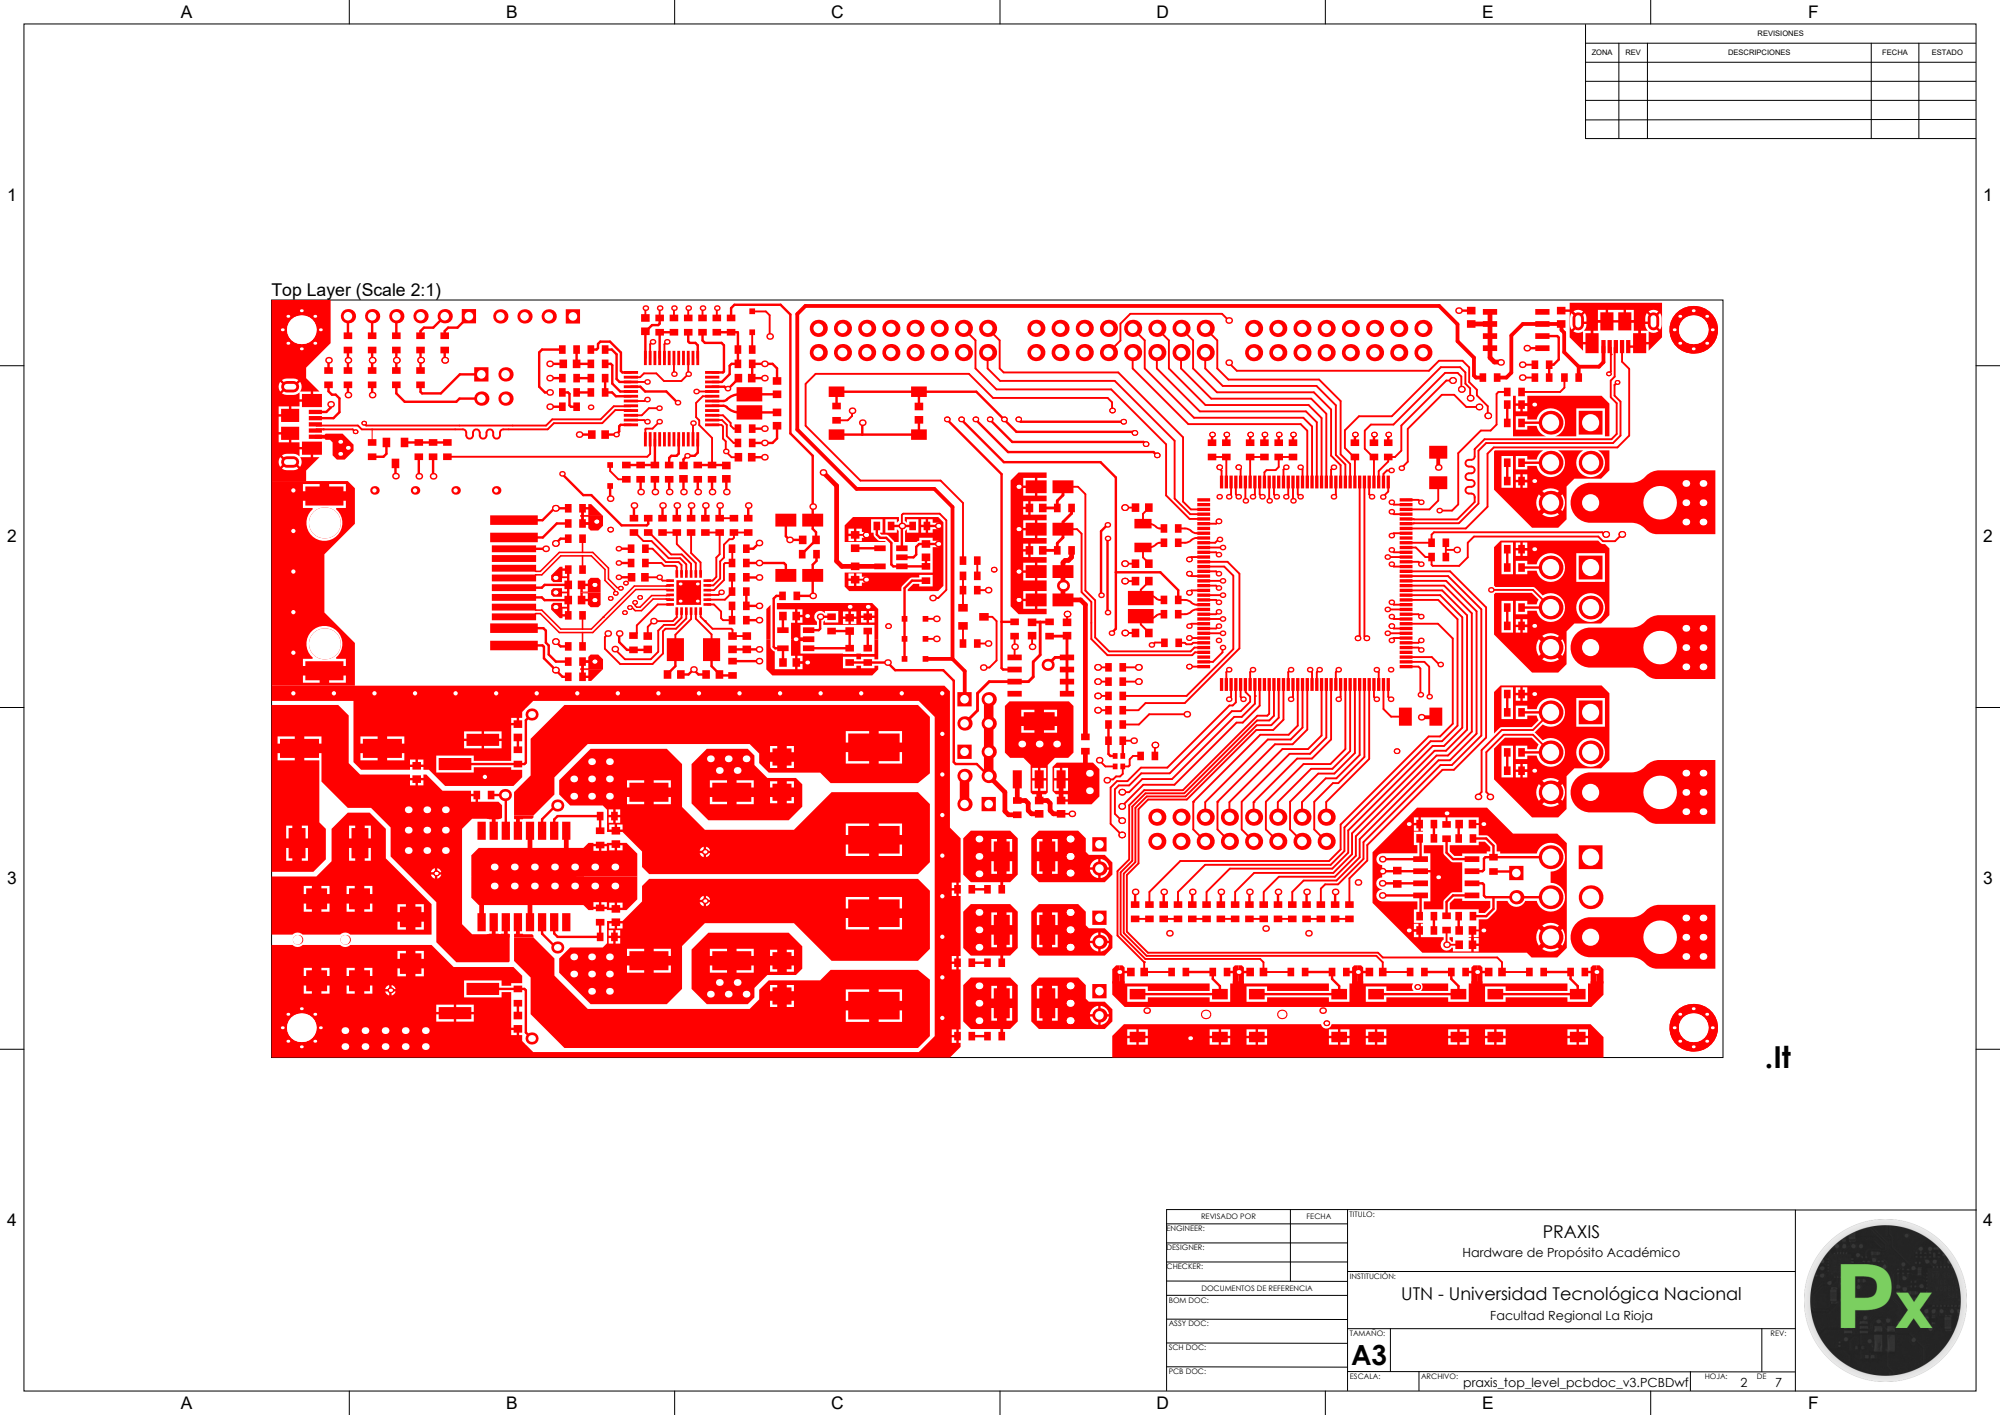
[picture p42: page 2]
TITULO:; PRAXIS; REVISADO POR; FECHA; INSTITUCIÓN:

Top Layer (Scale 2:1)

ENGINEER:

DESIGNER:

Hardware de Propósito Académico
UTN - Universidad Tecnológica Nacional

CHECKER:

DOCUMENTOS DE REFERENCIA

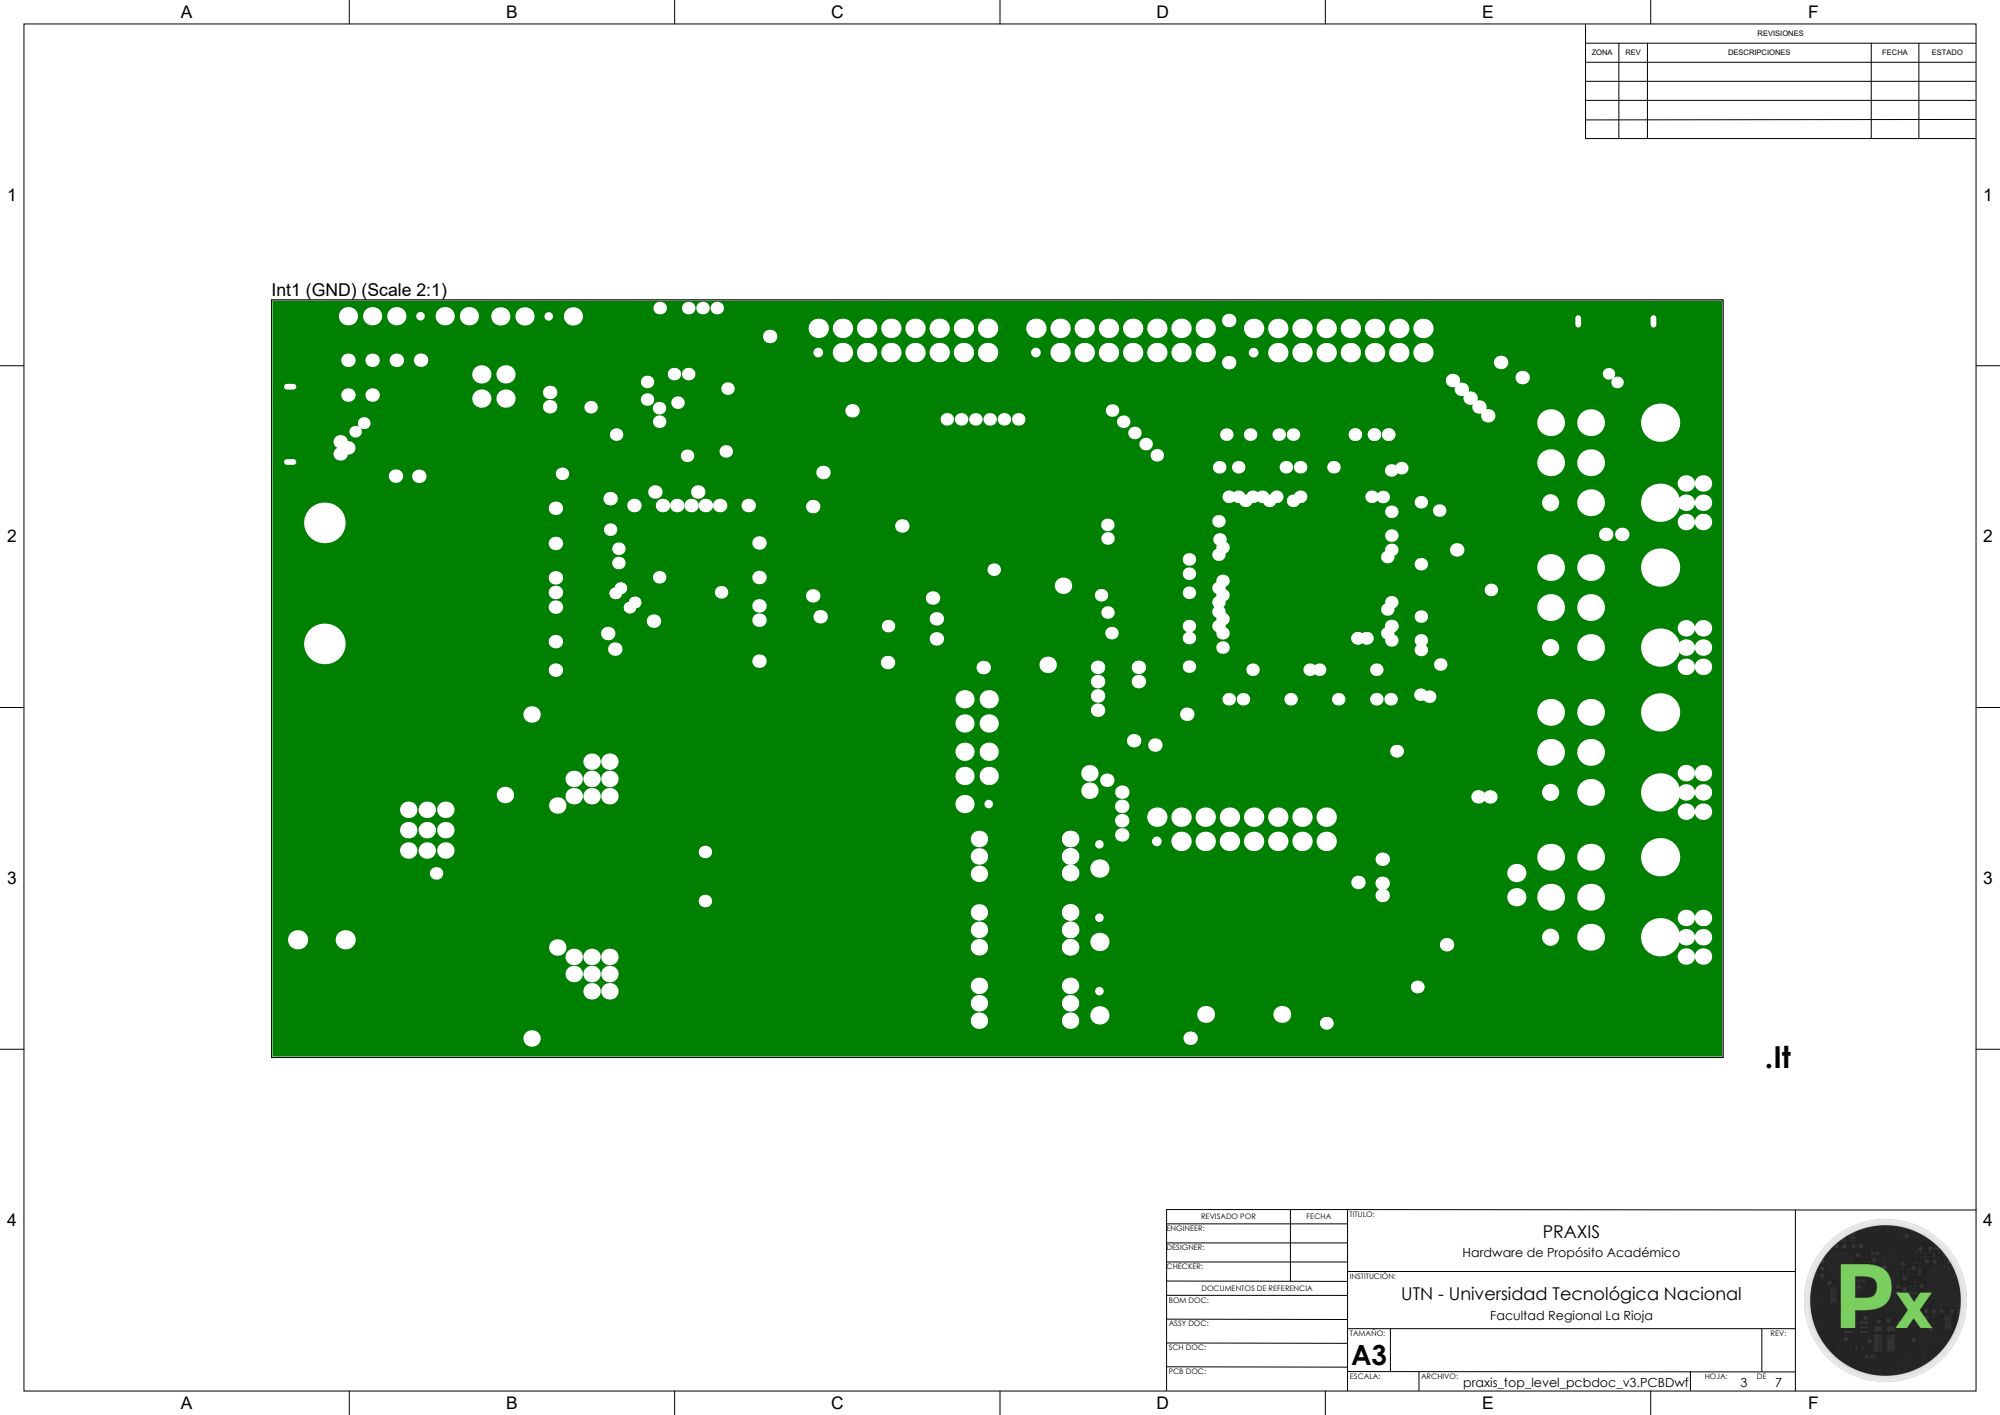
[picture p43: page 3]
TITULO:; PRAXIS; REVISADO POR; FECHA; INSTITUCIÓN:; Int1 (GND) (Scale 2:1)

ENGINEER:

DESIGNER:

Hardware de Propósito Académico
UTN - Universidad Tecnológica Nacional

CHECKER:

DOCUMENTOS DE REFERENCIA

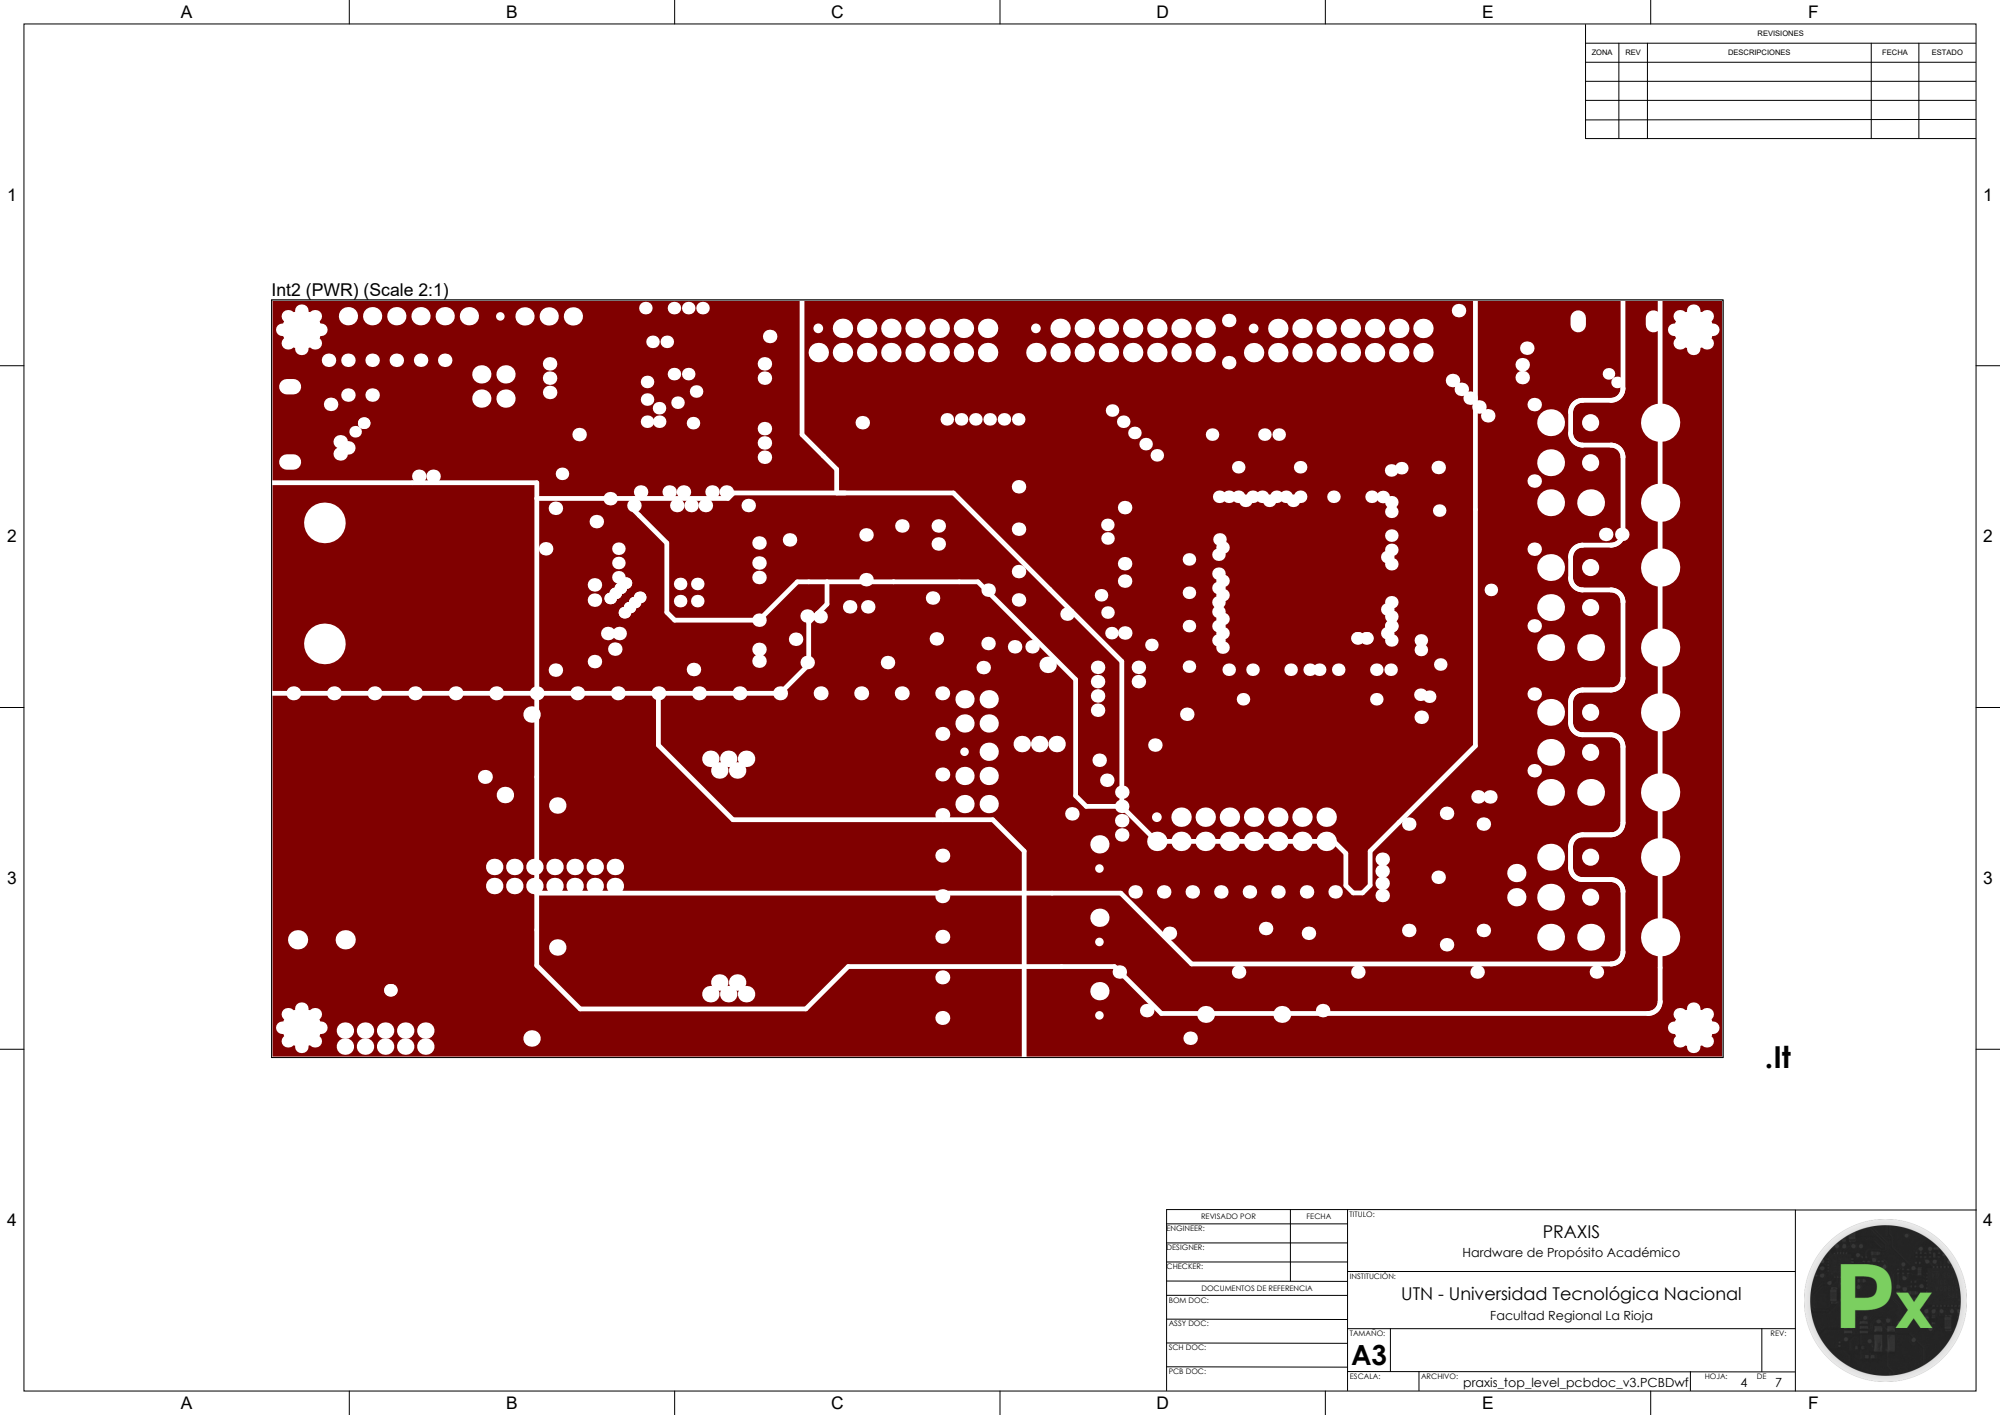
[picture p44: page 4]
TITULO:; PRAXIS; REVISADO POR; FECHA; INSTITUCIÓN:; Int2 (PWR) (Scale 2:1)

ENGINEER:

DESIGNER:

Hardware de Propósito Académico
UTN - Universidad Tecnológica Nacional

CHECKER:

DOCUMENTOS DE REFERENCIA

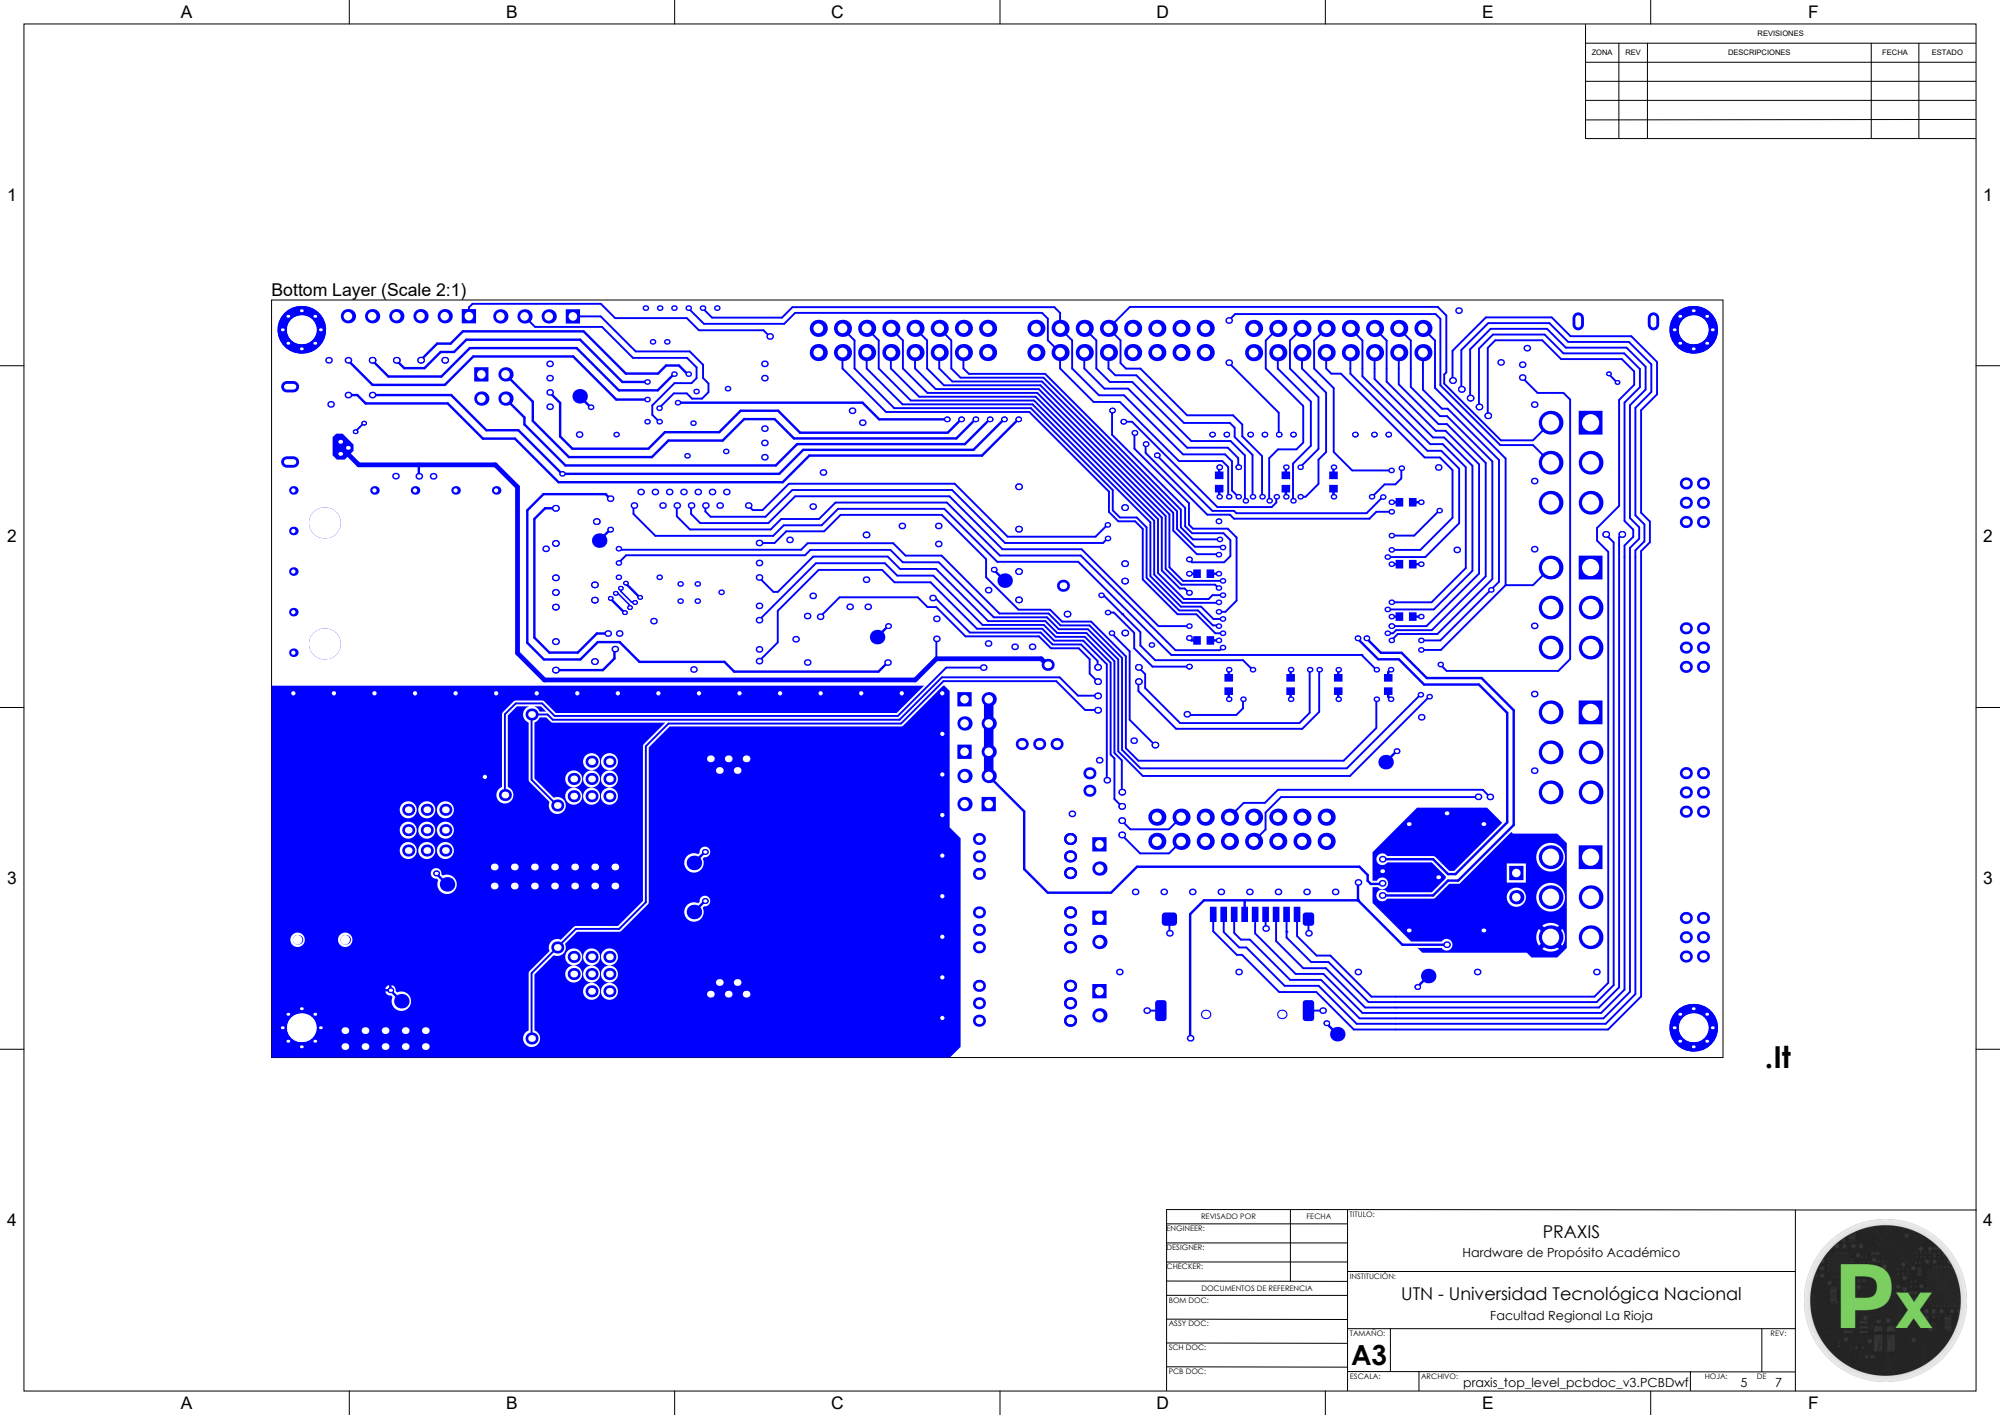
[picture p45: page 5]
TITULO:; PRAXIS; REVISADO POR; FECHA; INSTITUCIÓN:

Bottom Layer (Scale 2:1)

ENGINEER:

DESIGNER:

Hardware de Propósito Académico
UTN - Universidad Tecnológica Nacional

CHECKER:

DOCUMENTOS DE REFERENCIA

1 | 1
2 | 2
3 | 3
4 | 4
Material | Layer | Thickness | Dielectric Material Type | Gerber
| Top Overlay | | Legend | GTO
Surface Material Top Solder | 0,03mm(1mil) SM-001 | Solder Mask | GTS
PbSn | Top Surface Finish | 0,02mm(1mil) | Surface Finish
CF-004 | Top Layer | 0,04mm(1mil) | Signal | GTL
Prepreg | 0,11mm(4mil) PP-014 | Dielectric
CF-003 | Int1 (GND) | 0,02mm(1mil) | Internal Plane | GP1
Core | 1,06mm(42mil) Core-042 | Dielectric
CF-003 | Int2 (PWR) | 0,02mm(1mil) | Internal Plane | GP2
Prepreg | | 0,11mm(4mil) PP-014 | Dielectric
CF-004 | Bottom Layer | 0,04mm(1mil) | Signal | GBL
PbSn | Bottom Surface Finish 0,02mm(1mil) | Surface Finish
Surface Material Bottom Solder | 0,03mm(1mil) SM-001 | Solder Mask | GBS
| Bottom Overlay | | Legend | GBO
Total thickness: 1,48mm(58mil)

Layer Stack Legend

.It

TITULO:
PRAXIS

DOCUMENTOS DE REFERENCIA

REVISADO POR | FECHA
ENGINEER:

DESIGNER:

CHECKER:

Hardware de Propósito Académico

INSTITUCIÓN:
UTN - Universidad Tecnológica Nacional

Impedance Id
1
2
3
4
5
6

Transmission Line
Coated Microstrip
Edge-Coupled Coated Microstrip Edge-Coupled Coated Microstrip Coated Microstrip
Edge-Coupled Coated Microstrip Edge-Coupled Coated Microstrip

Target Impedance
50
100
90
50
100
90

Calculated Impedance
49.69
99.72
90.43
49.69
99.72
90.43

Trace layer
Top Layer
Top Layer
Top Layer
Bottom Layer
Bottom Layer
Bottom Layer

Wide Trace Width
0.20mm
0.17mm
0.20mm
0.20mm
0.17mm
0.20mm

Narrow Trace Width
0.20mm
0.17mm
0.20mm
0.20mm
0.17mm
0.20mm

Gap

0.20mm
0.20mm

0.20mm
0.20mm

Reference layers
Int1 (GND)
Int1 (GND)
Int1 (GND)
Int2 (PWR)
Int2 (PWR)
Int2 (PWR)

Substack
Board Layer Stack
Board Layer Stack
Board Layer Stack
Board Layer Stack
Board Layer Stack
Board Layer Stack

Transmission Line Structure Table

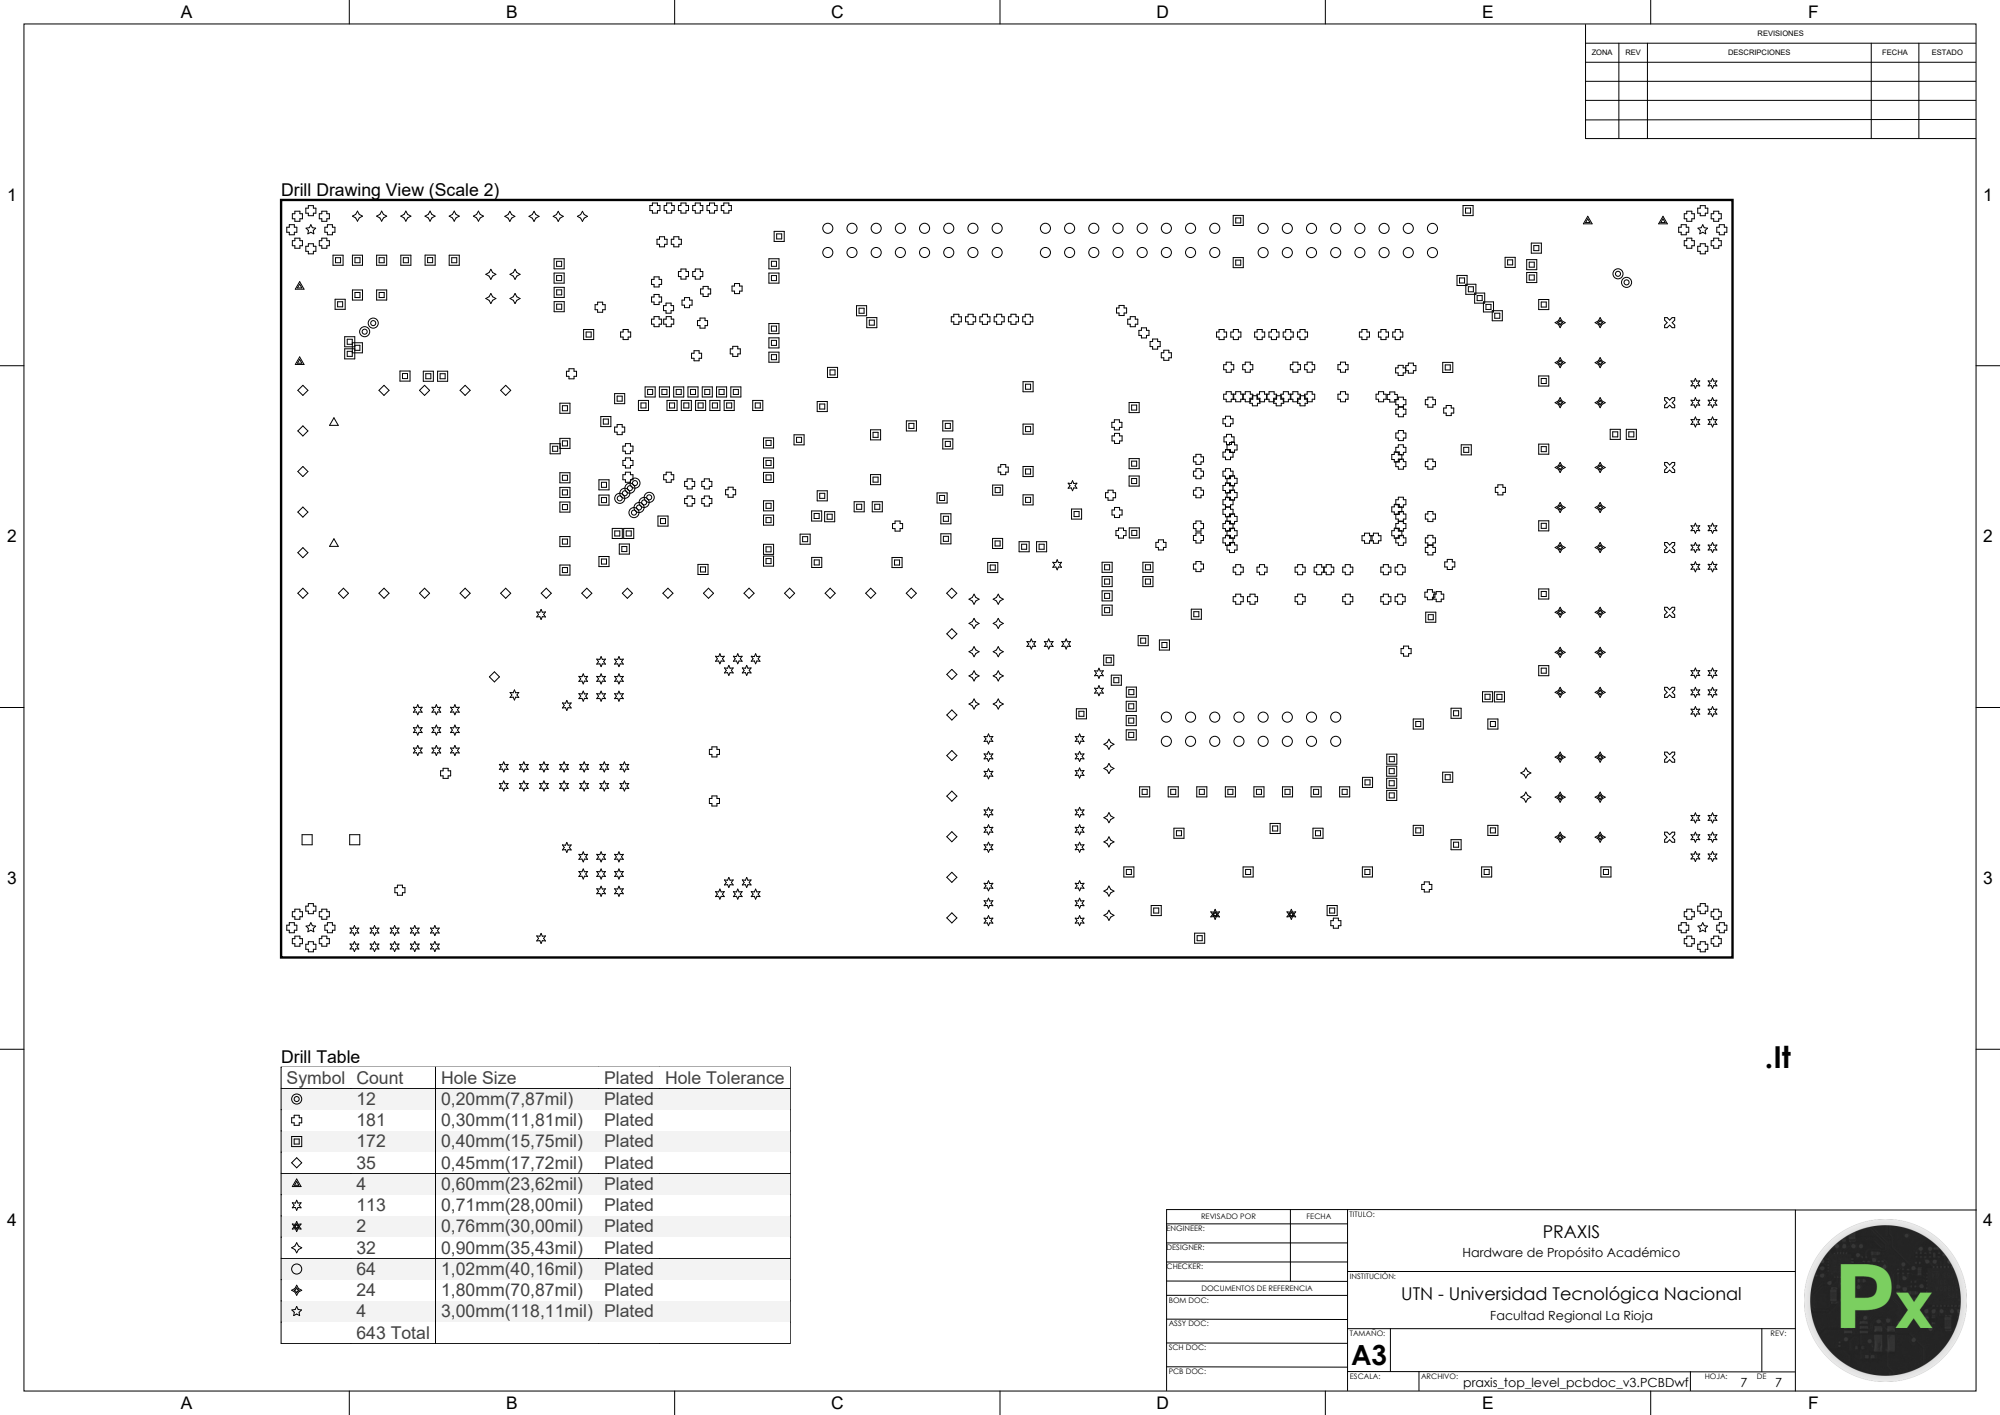
[picture p46: page 7]
Symbol Count 12 181 172 35 4 113 2 32 64 24 4 643 Total; Hole Size 0,20mm(7,87mil) 0,30mm(11,81mil) 0,40mm(15,75mil) 0,45mm(17,72mil) 0,60mm(23,62mil) 0,71mm(28,00mil) 0,76mm(30,00mil) 0,90mm(35,43mil) 1,02mm(40,16mil) 1,80mm(70,87mil) 3,00mm(118,11mil); Plated Plated Plated Plated Plated Plated Plated Plated Plated Plated Plated Plated; Hole Tolerance; Drill Table; TITULO:; PRAXIS; REVISADO POR; FECHA; ENGINEER:; DESIGNER:; CHECKER:; INSTITUCIÓN:

Drill Drawing View (Scale 2)

Hardware de Propósito Académico
UTN - Universidad Tecnológica Nacional

DOCUMENTOS DE REFERENCIA
