diegocoll/top_level_pcb/Modulo de alimentador/Test/version_0/IMG_20161230_184904.jpg

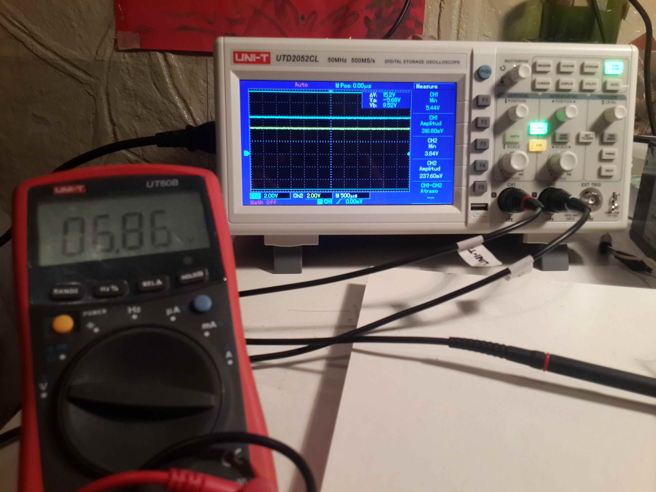
Modulo de alimentador/Test/version_0/IMG_20161230_184904.jpg
