diegocoll/top_level_pcb/Modulo de extensiones/Altium/Componentes/CONN_HEADER_RA_6POS/CONN_HEADER_RA_6POS_3D_MODEL.pdf

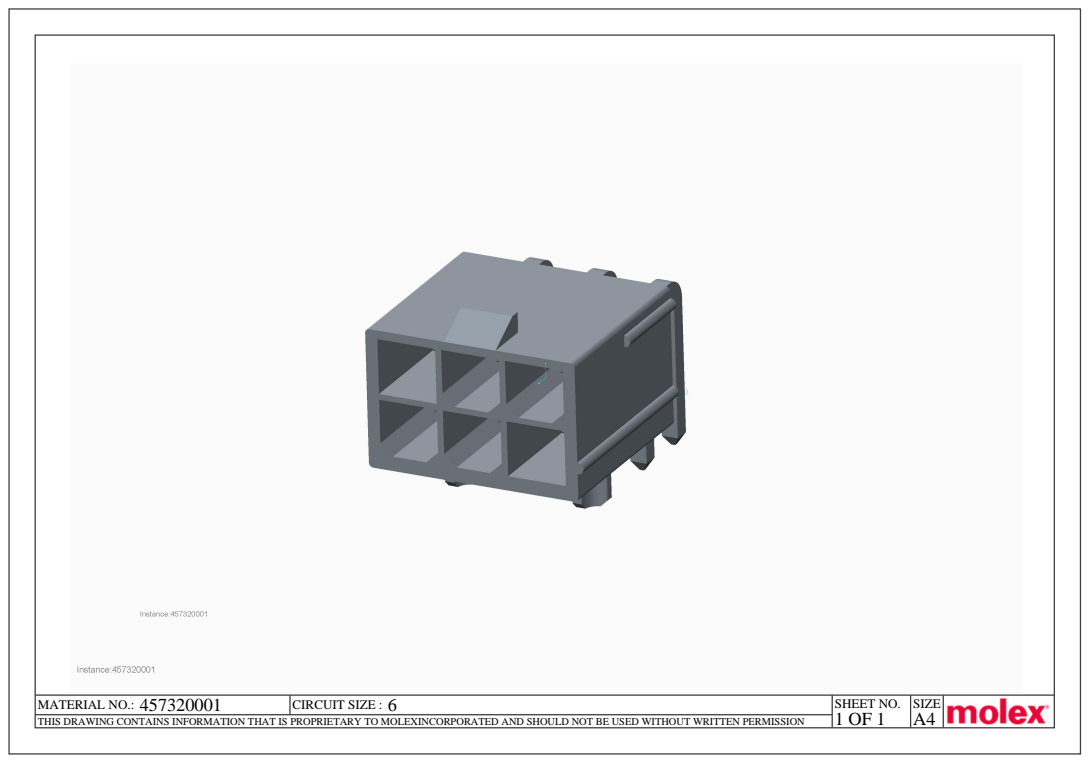
[picture p57: page 1]
MATERIAL NO.: 457320001; CIRCUIT SIZE : 6; SHEET NO.; SIZE

THIS DRAWING CONTAINS INFORMATION THAT IS PROPRIETARY TO MOLEXINCORPORATED AND SHOULD NOT BE USED WITHOUT WRITTEN PERMISSION
