diegocoll/top_level_pcb/Draftman.pdf

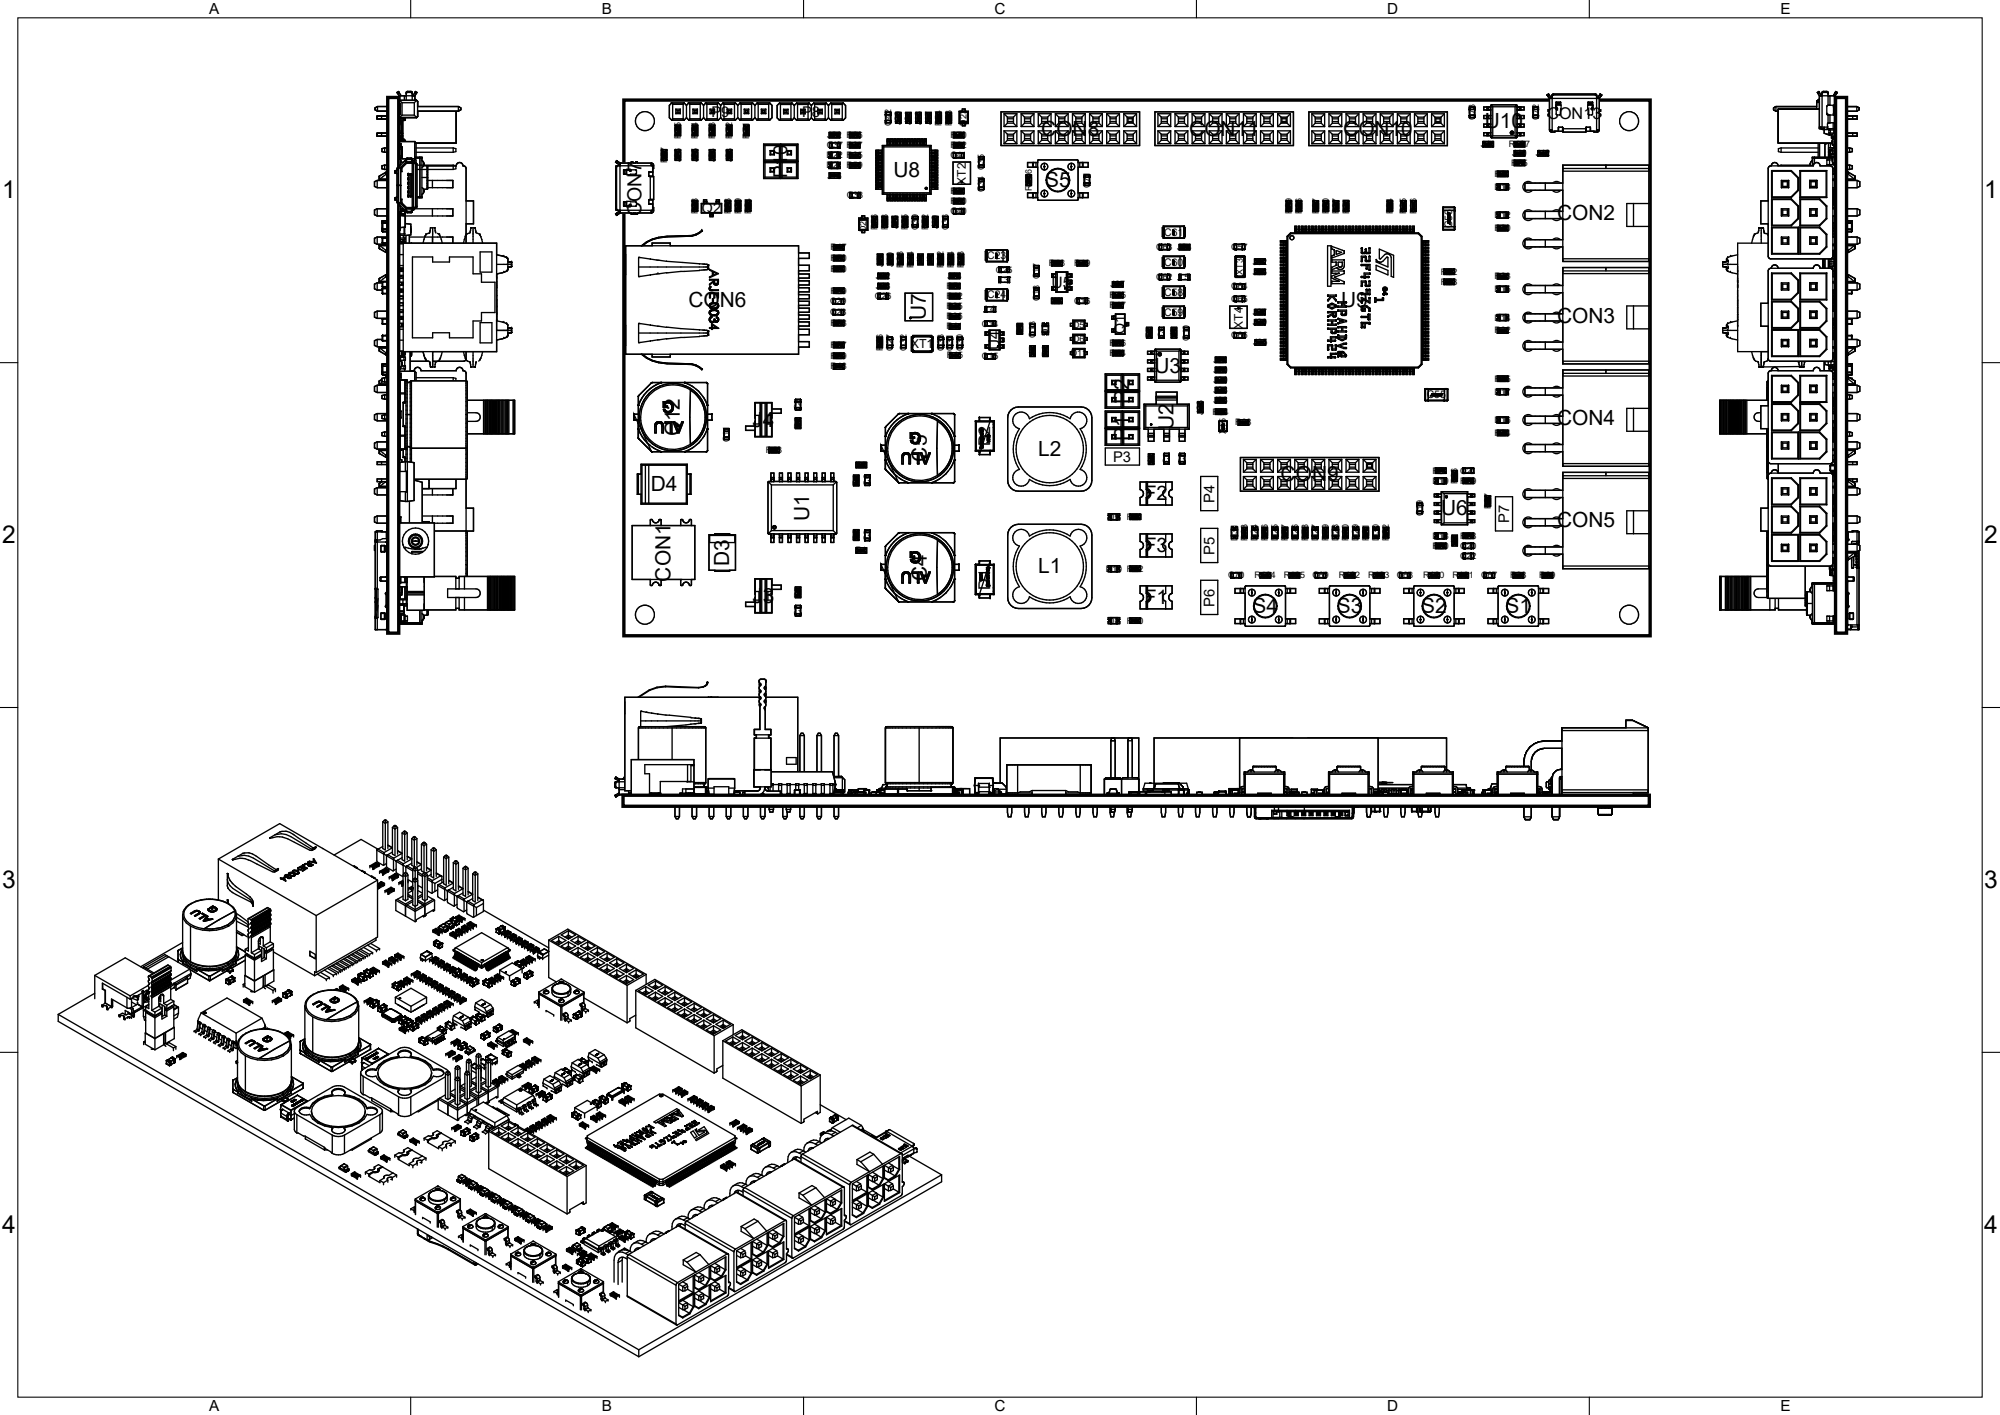
[picture p58: page 1]

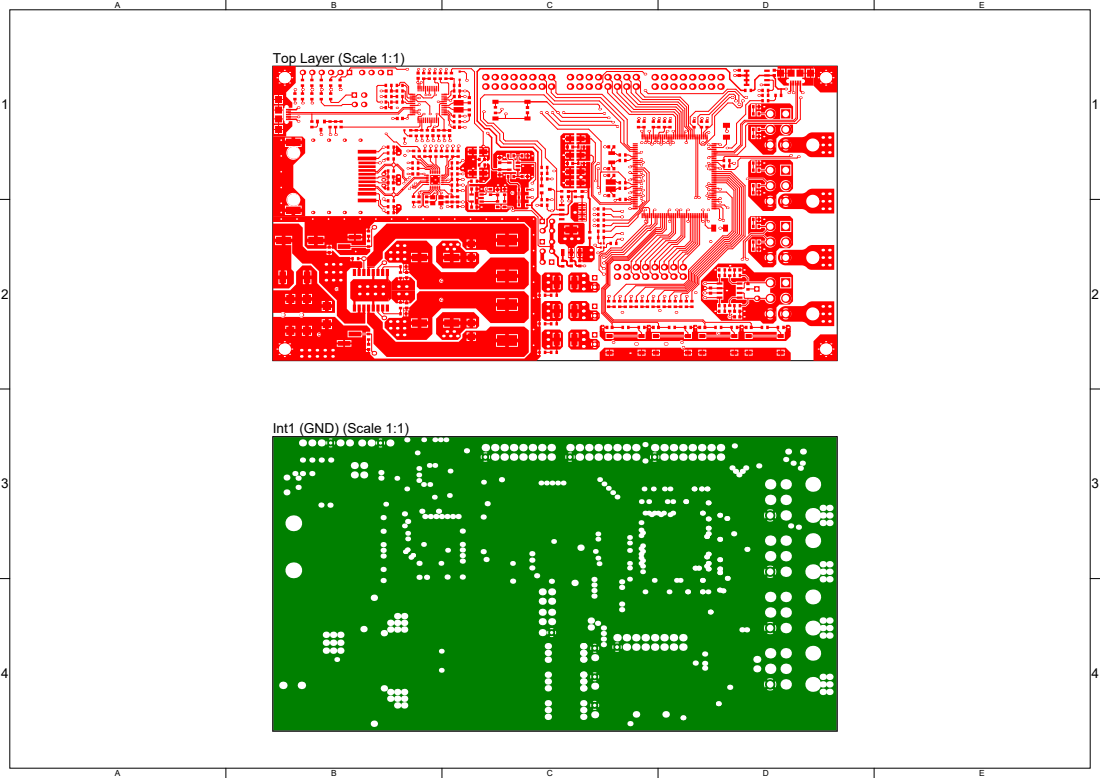
[picture p59: page 2]
Int1 (GND) (Scale 1:1)

Top Layer (Scale 1:1)

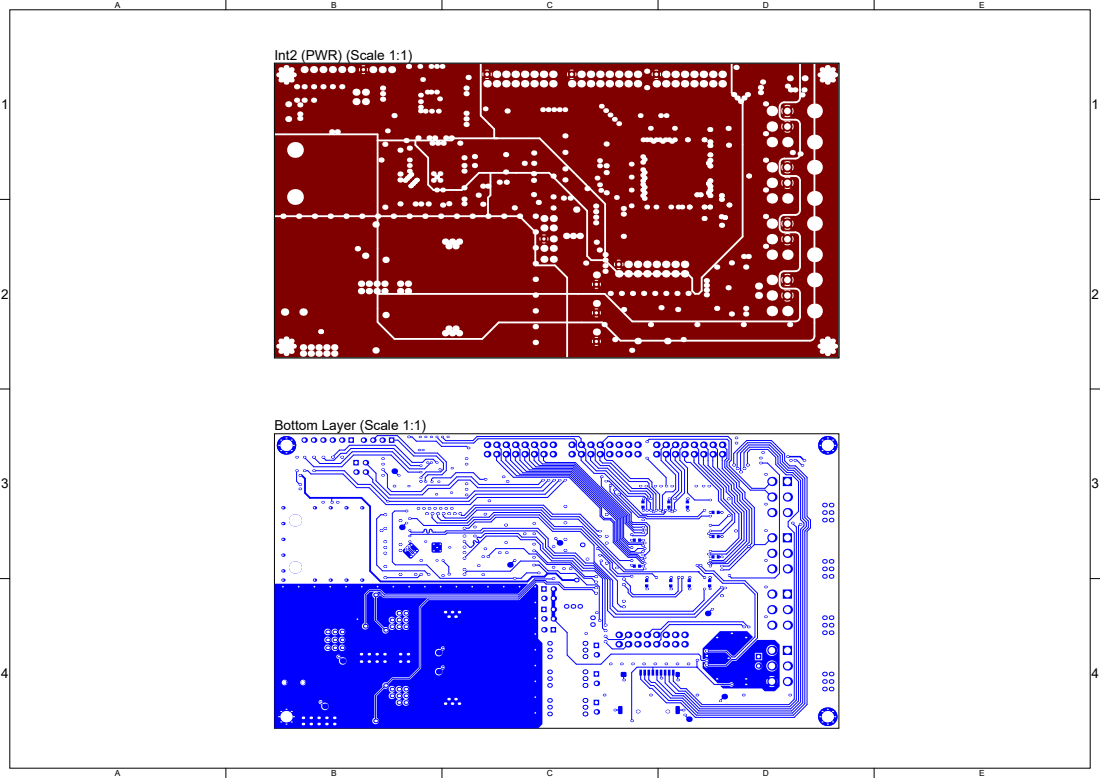
[picture p60: page 3]
Int2 (PWR) (Scale 1:1)

Bottom Layer (Scale 1:1)

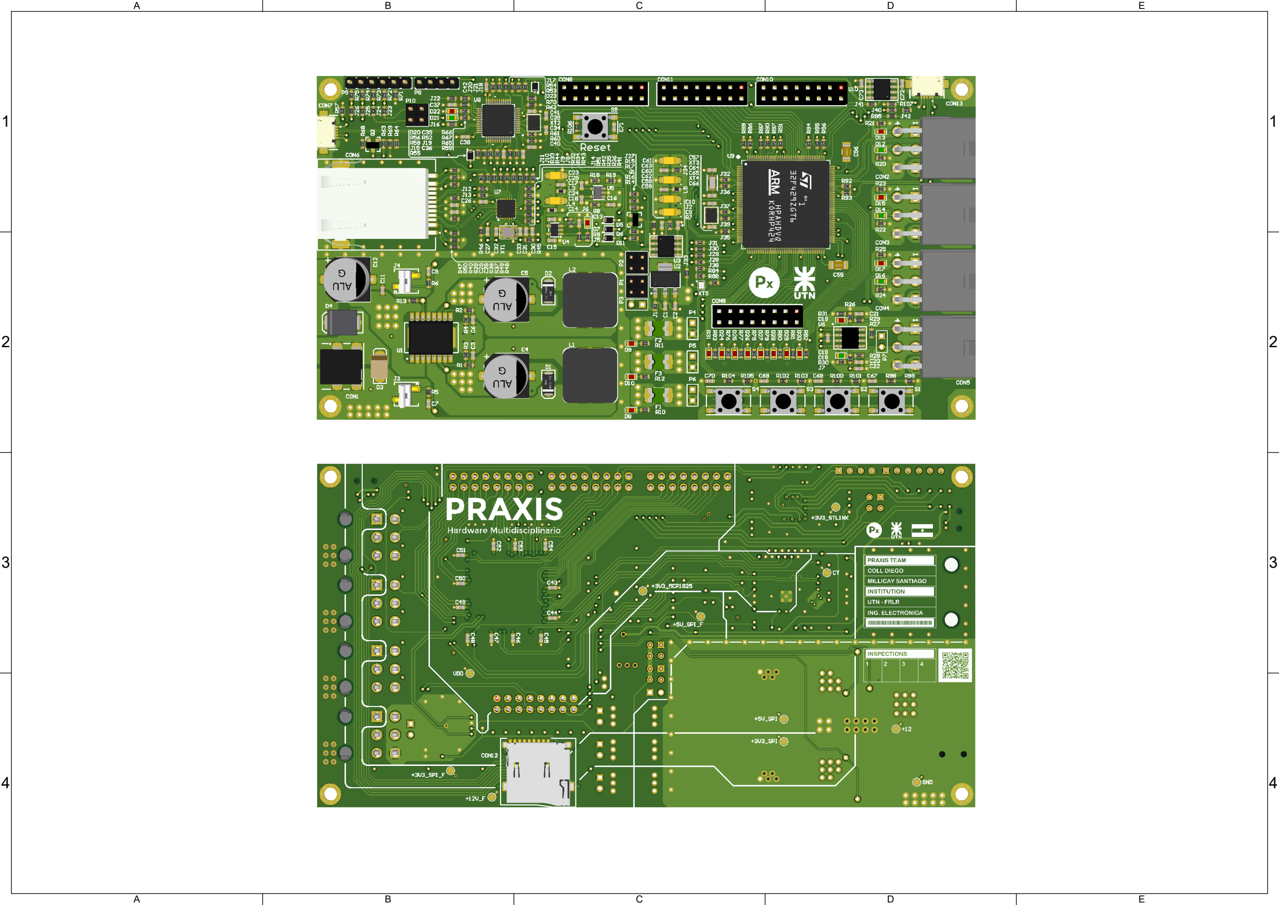
[picture p61: page 4]

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
1 | 1
2 | 2
3 | 3
4 | 4
Material | Layer | Thickness | Dielectric Material Type | Gerber
| Top Overlay | | Legend | GTO
Surface Material Top Solder | 0.025mm(1.000mil) SM-001 | Solder Mask | GTS
PbSn | Top Surface Finish | 0.020mm(0.787mil) | Surface Finish
CF-004 | Top Layer | 0.035mm(1.378mil) | Signal | GTL
Prepreg | 0.107mm(4.200mil) PP-014 | Dielectric
CF-003 | Int1 (GND) | 0.018mm(0.709mil) | Internal Plane GP1
Core | 1.265mm(49.803mil) Core-042 | Dielectric
CF-003 | Int2 (PWR) | 0.018mm(0.709mil) | Internal Plane GP2
Prepreg | | 0.107mm(4.200mil) PP-014 | Dielectric
CF-004 | Bottom Layer | 0.035mm(1.378mil) | Signal | GBL
PbSn | Bottom Surface Finish 0.020mm(0.787mil) | Surface Finish
Surface Material Bottom Solder | 0.025mm(1.000mil) SM-001 | Solder Mask | GBS
| Bottom Overlay | | Legend | GBO
Total thickness: 1.675mm(65.951mil)

Layer Stack Legend

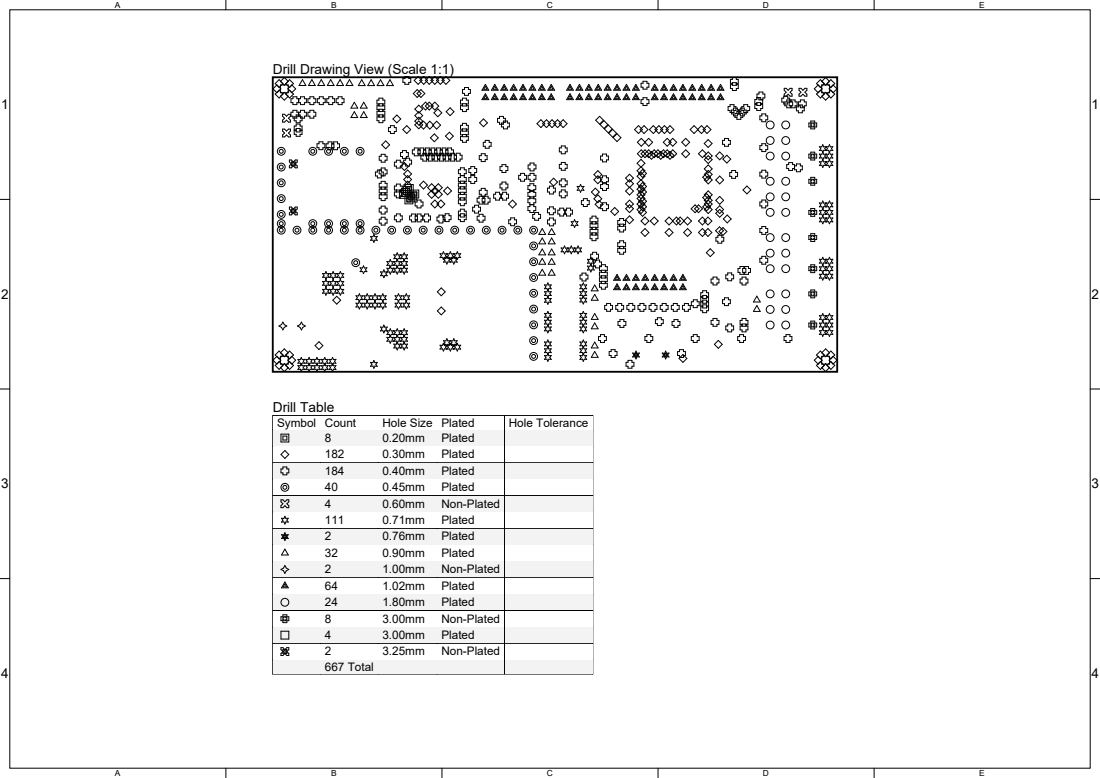
[picture p62: page 6]
Drill Table

Drill Drawing View (Scale 1:1)

Symbol | Count | Hole Size | Plated | Hole Tolerance

8 | 0.20mm | Plated
182 | 0.30mm | Plated
184 | 0.40mm | Plated
40 | 0.45mm | Plated
4 | 0.60mm | Non-Plated
111 | 0.71mm | Plated
2 | 0.76mm | Plated
32 | 0.90mm | Plated
2 | 1.00mm | Non-Plated
64 | 1.02mm | Plated
24 | 1.80mm | Plated
8 | 3.00mm | Non-Plated
4 | 3.00mm | Plated
2 | 3.25mm | Non-Plated
667 Total

1 | 1
2 | 2
3 | 3
4 | 4

Line #
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
Designator
C1
C2, C9, C10, C13, C15, C16, C30
C3, C6, C7, C8, C11, C14,
C19, C22, C25, C26, C27,
C28, C29, C36, C38, C39,
C40, C41, C42, C43, C44,
C45, C46, C47, C48, C49,
C50, C51, C52, C53, C54,
C62, C63, C67, C68, C69,
C70, C71
C4, C5
C12
C17
C18, C72, C73
C20, C21
C23, C24
C31
C32, C33
C34, C35
C37
C55, C56
C57, C64, C65, C66
C58, C59
C60, C61
CON1
CON2, CON3, CON4, CON5
CON6
CON7
CON8, CON9, CON10,
CON11
CON12
CON13
D1, D2
D3
D4
D5, D6, D11
D7, D8, D9, D10
D12, D14, D16, D18
D13, D15, D17, D19
D20, D23
D21
D22
D24, D25, D26, D27, D28,
D29, D30, D31

Comment
Cap Semi
Cap Semi

Cap Semi

EEEFC1E471P
EEEFK1H221P
Cap Semi
Cap Semi
Cap Semi
TANT
Cap Semi
Cap Semi
Cap Semi
Cap Semi
CAP CER 2.2UF 10V X7R
1206
Cap Semi
TANT
Tant
PWR JACK
CONN_HEADER_RA_6POS
ARJE-0034
USB_SOHANTECH
Header - 16 pins - 2.54mm
pitch
Micro SD socket
USB_SOHANTECH
SS26SHE3_A/H
P6SMB13CA
Diodo schottky
PMEG1030EJ
LTST-C191KRKT
LTST-C191TGKT
LTST-C191KRKT
PMEG1030EJ
LTST-C191TGKT
LTST-C191KRKT
LTST-C191KRKT

Quantity
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
Bill Of Materials
Line #
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
Designator
C1
C2, C9, C10, C13, C15, C16, C30
C3, C6, C7, C8, C11, C14,
C19, C22, C25, C26, C27,
C28, C29, C36, C38, C39,
C40, C41, C42, C43, C44,
C45, C46, C47, C48, C49,
C50, C51, C52, C53, C54,
C62, C63, C67, C68, C69,
C70, C71
C4, C5
C12
C17
C18, C72, C73
C20, C21
C23, C24
C31
C32, C33
C34, C35
C37
C55, C56
C57, C64, C65, C66
C58, C59
C60, C61
CON1
CON2, CON3, CON4, CON5
CON6
CON7
CON8, CON9, CON10,
CON11
CON12
CON13
D1, D2
D3
D4
D5, D6, D11
D7, D8, D9, D10
D12, D14, D16, D18
D13, D15, D17, D19
D20, D23
D21
D22
D24, D25, D26, D27, D28,
D29, D30, D31

Comment
Cap Semi
Cap Semi

Cap Semi

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

Quantity
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
Bill Of Materials

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
Line # | Designator | Comment
68 | R55 | Res3
69 | R56 | Res3
70 | R69 | Res3
71 | R72, R73, R74, R75 | Res3
72 | R84 | Pull_Up_Res
73 | R88
74 | R91 | Res3
75 | R92, R93, R94, R95, R96 | Res3
76 | R97 | Res3 | Quantity 1114111515111111111111111
77 | S1, S2, S3, S4, S5 | Switch
78 | U1 | SPI-8001TW
79 | U2 | MCP1825S-3302E
80 | U3 | IC PWR SWITCH N-CHAN 1:1 PDSO-8
81 | U4 | MIC5301-3.3YD5-TR
82 | U5 | LD3985M33R
83 | U6 | IC TRANSCEIVER 1/1 8SOIC
84 | U7 | LAN8742A-CZ
85 | U8 | STM32F103CBT6
86 | U9 | STM32F746ZGT6
87 | U10 | IC PWR SWITCH N-CHAN 1:1 PDSO-8
88 | XT1 | Crystal 25MHz
89 | XT2 | NX3225GD-8MHZ
90 | XT3 | NX3215SA-32.768K-STD-MUA-8
91 | XT4 | NX3225GD-8MHZ
92 | XT5 | ASCO-25MHZ-EK-T3

Bill Of Materials
