diegocoll/top_level_pcb/praxis_top_level_prjpcb.pdf

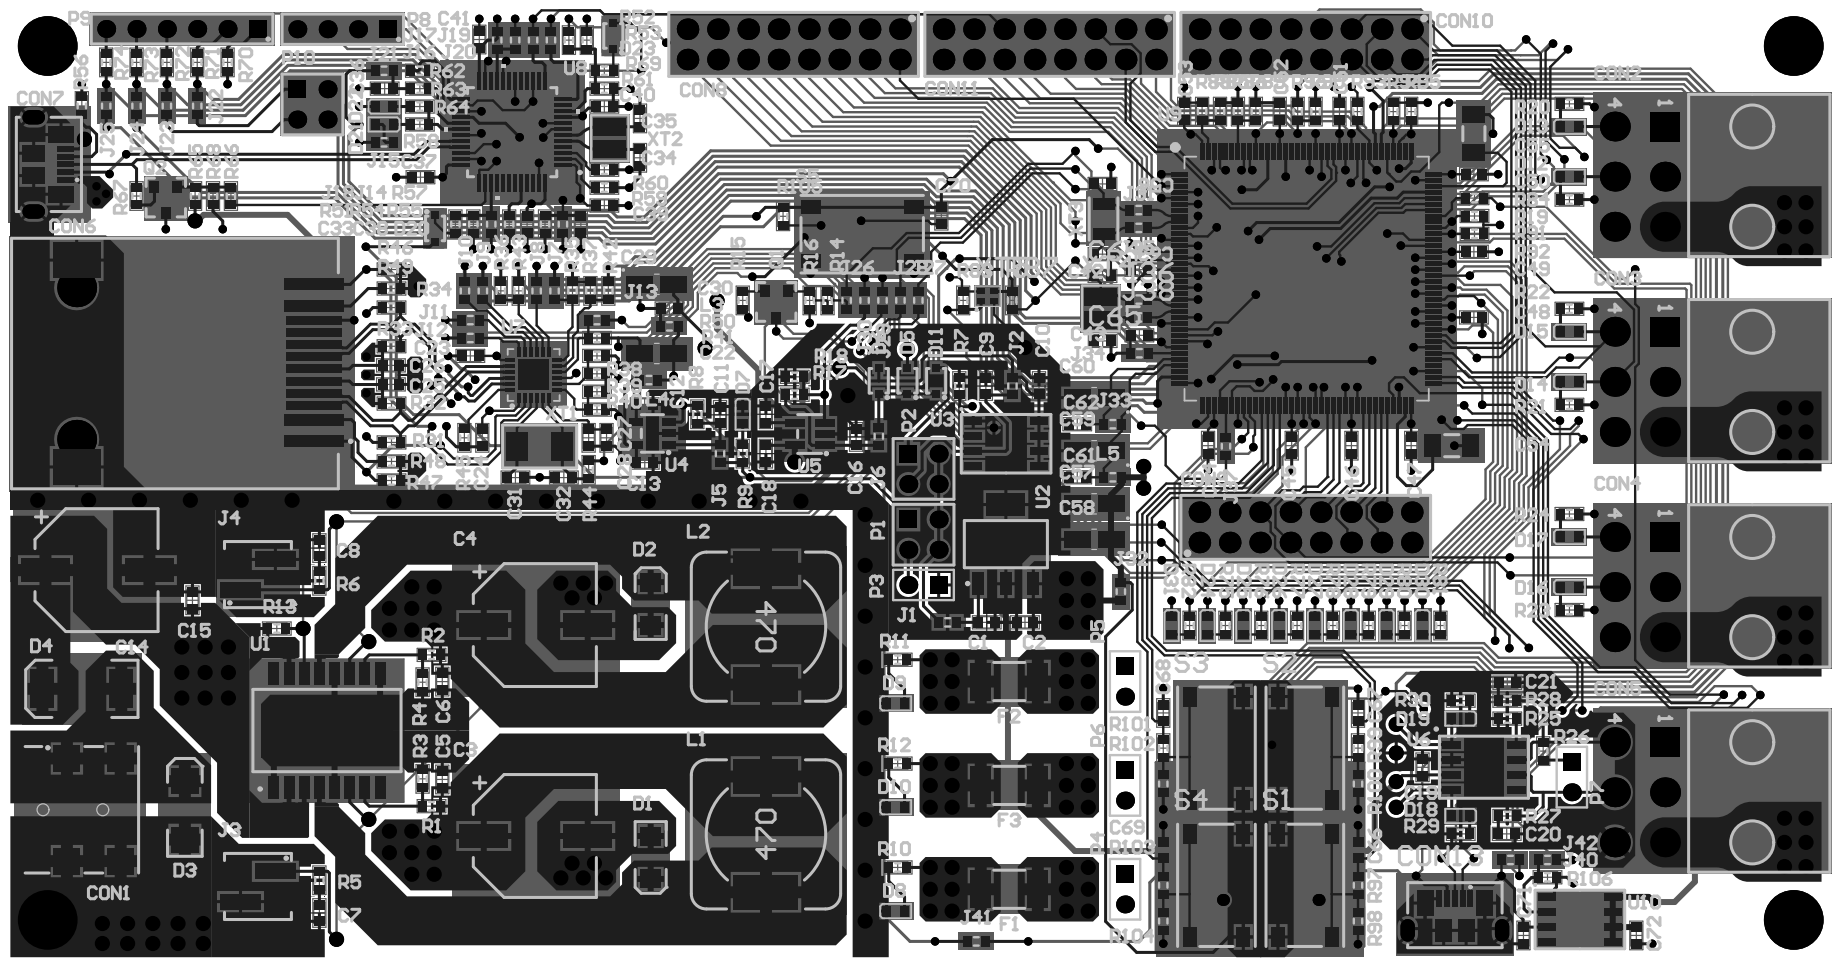
[picture p63: page 1]

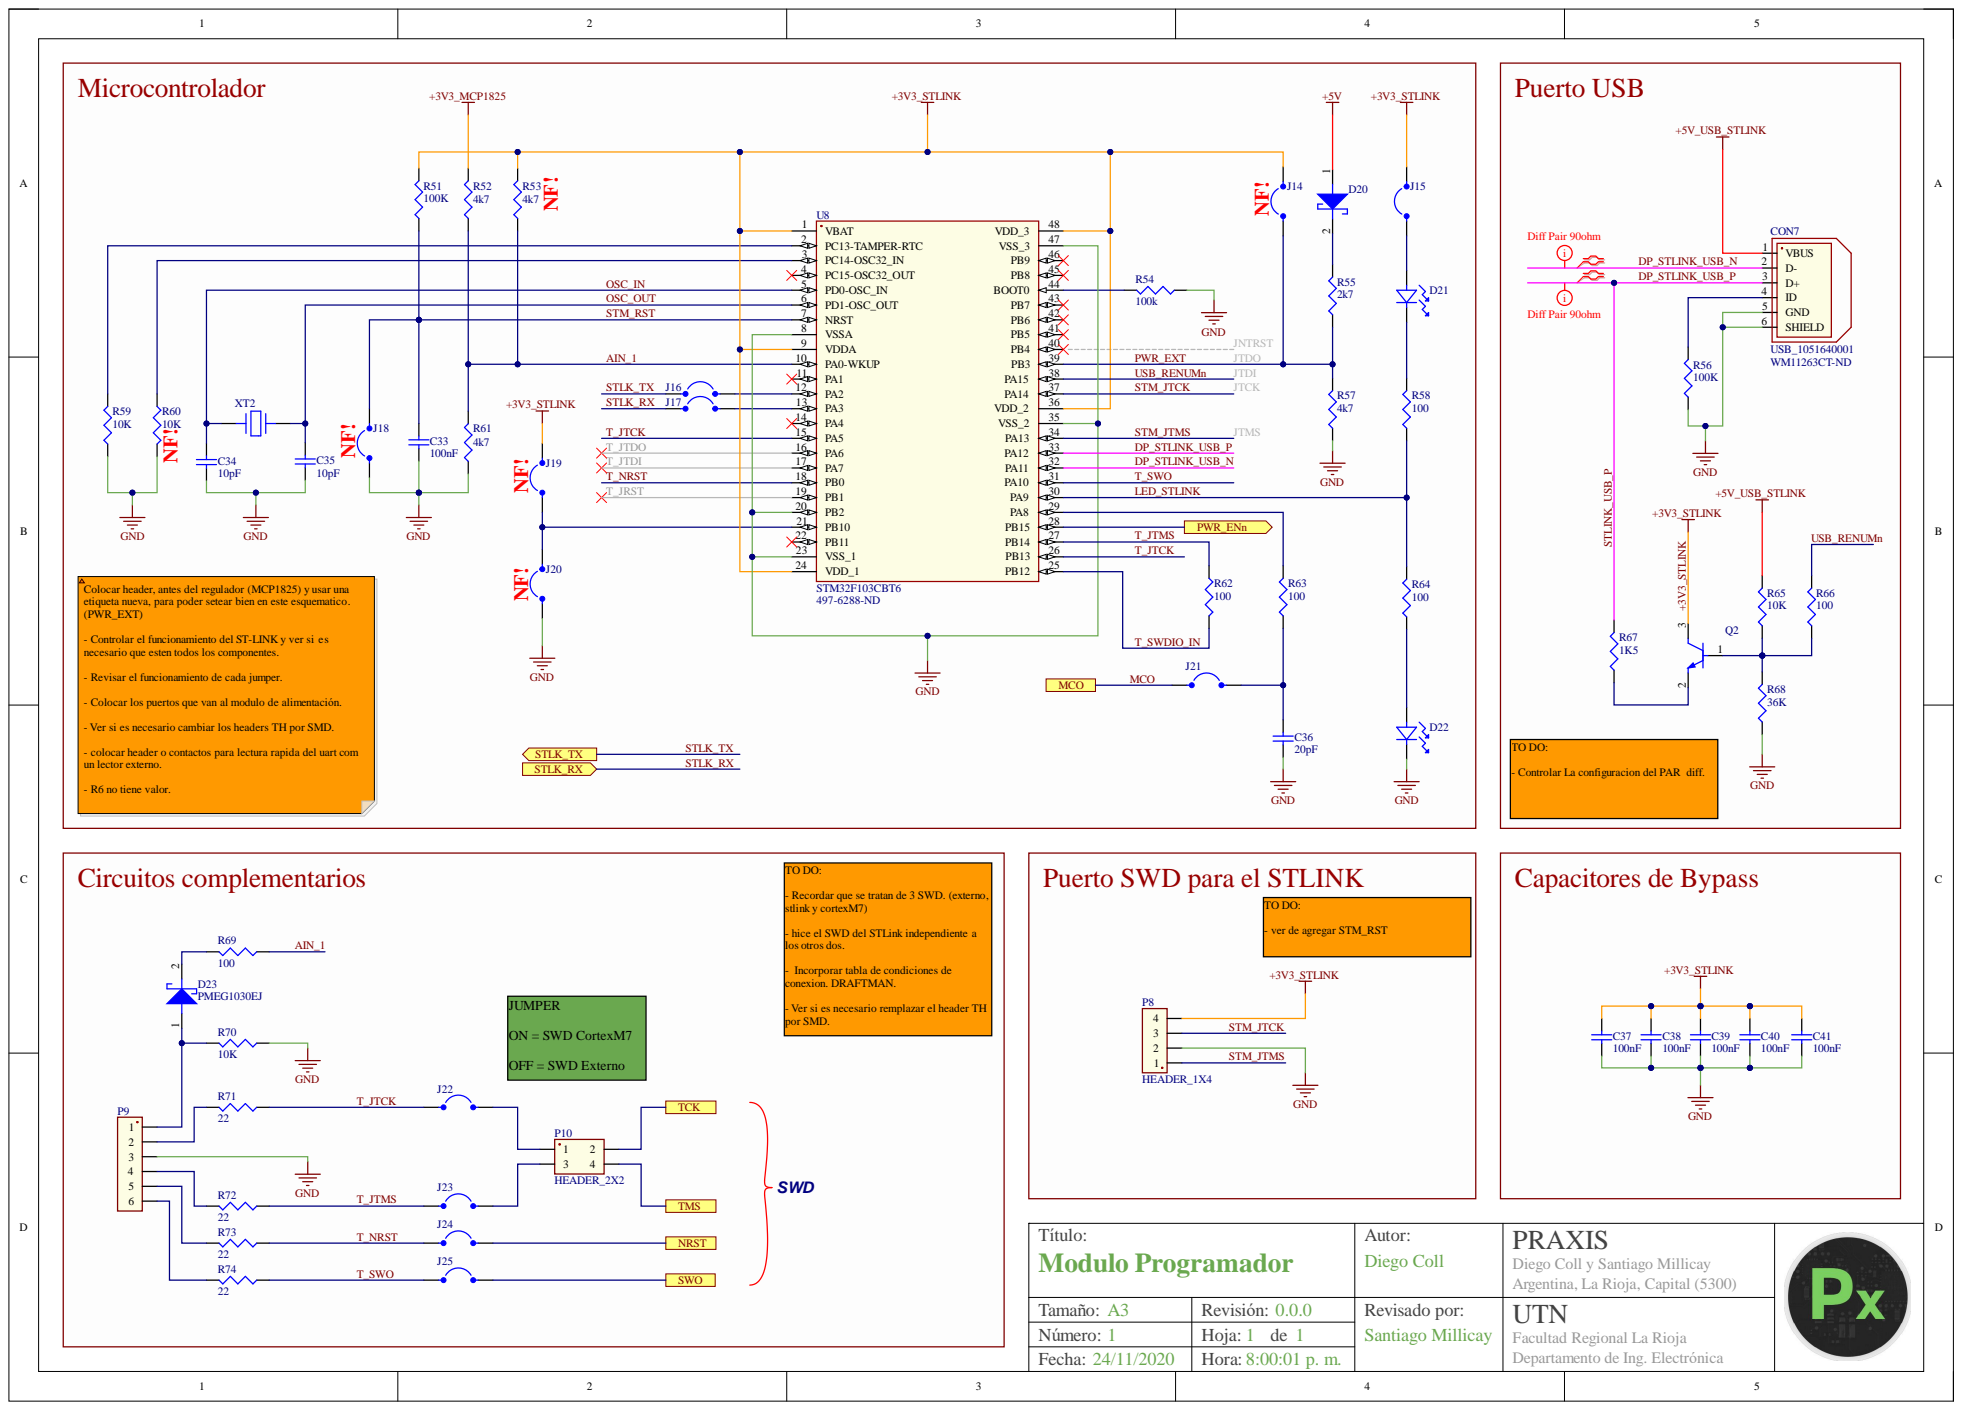
[picture p64: page 2]

ST LK_T X J16 J17 +3V3_ST LIN K ST LK_R X

T_J T M S
T_J T C K

ueva, para poder setear bien en es

ten todos los componen

tos que van al modu

io cambiar los header

ura rapida del uar

io remplazar el header T

Tam a ño: A | Revis i ó n : 0.0.0
N úmero: | Hoja: de

mento de Ing. Ele

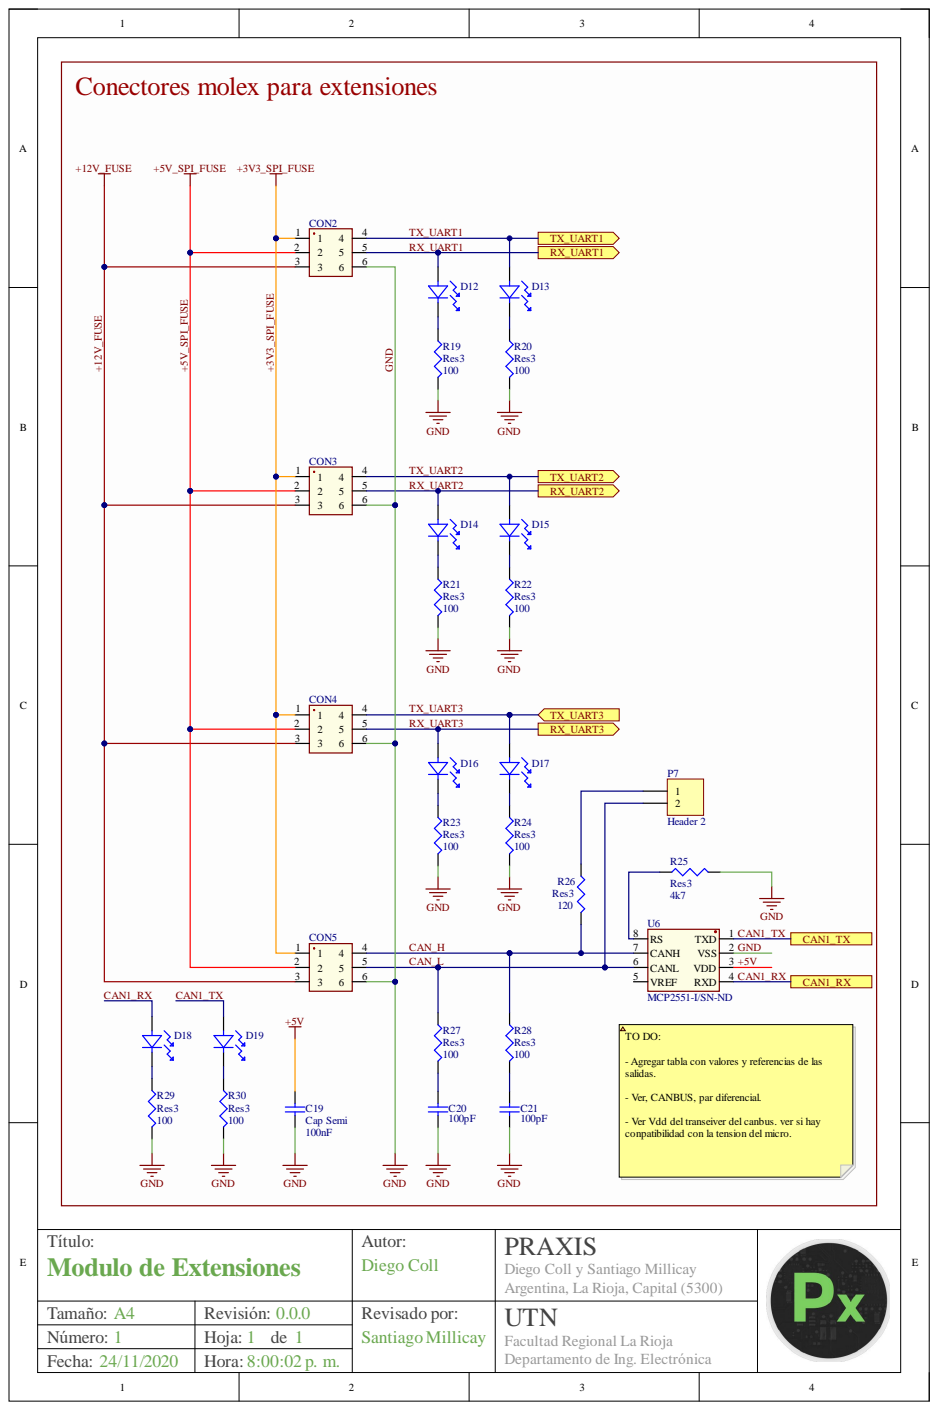
[picture p65: page 3]

Conectores molex para extensiones

- Agregar tabla con valores y referencias de las
salidas.

- Ver, CANBUS, par diferencial.

- Ver Vdd del transeiver del canbus. ver si hay
conpatibilidad con la tension del micro.

Título: Modulo de Extensiones | Autor: Diego Coll | PRAXIS Diego Coll y Santiago Millicay Argentina, La Rioja, Capital (5300)

Tamaño: A4 | Revisión: | Revisado por: SantiagoMillicay | UTN Facultad Regional La Rioja Departamento de Ing. Electrónica
Número:

24/11/2020 | Hora: 8:00:02 p. m.

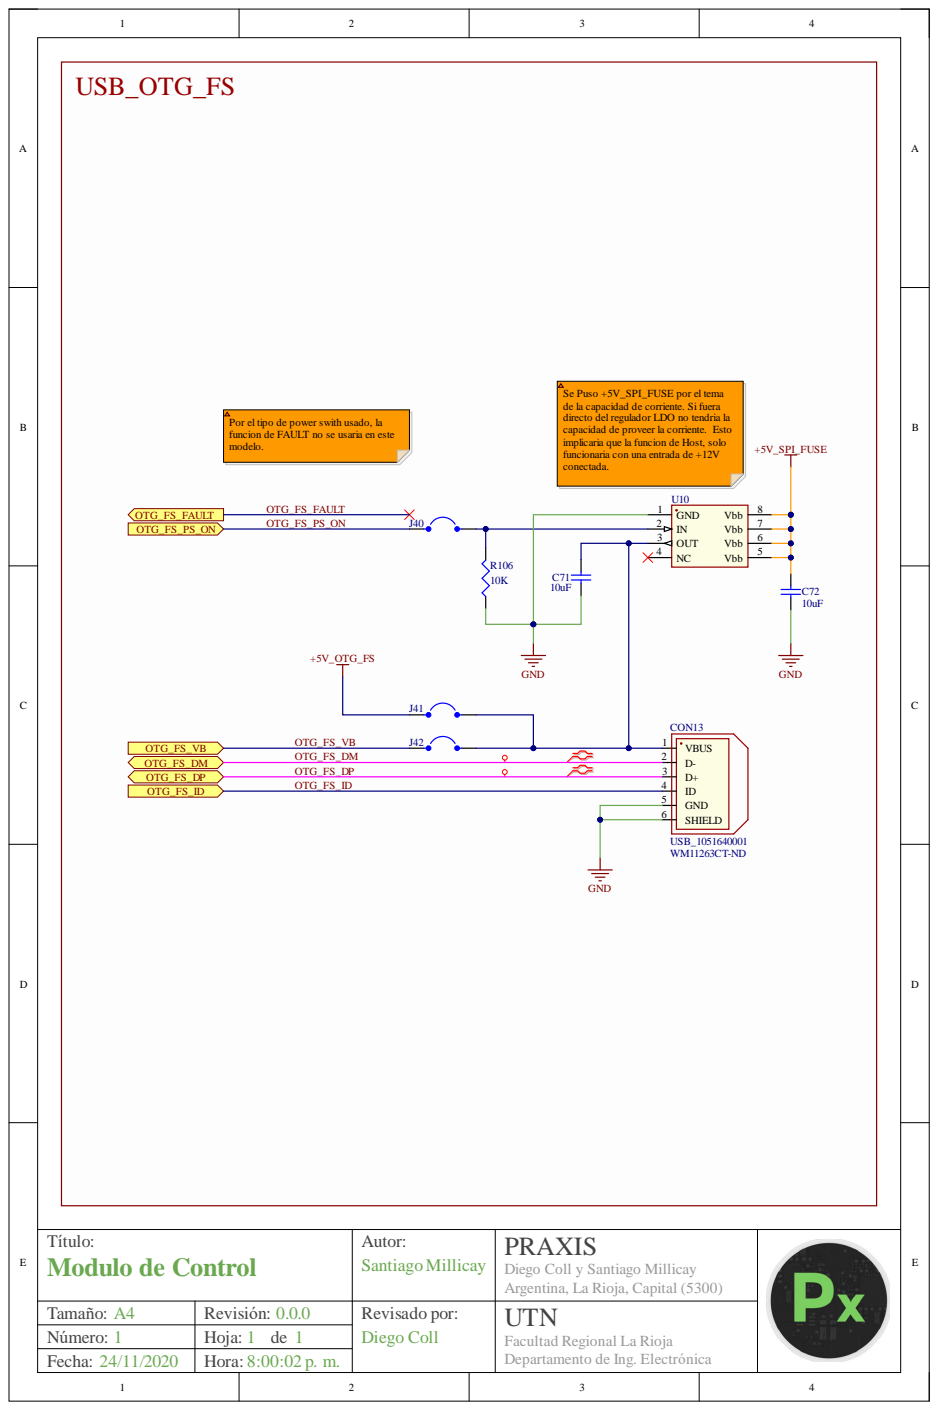
[picture p66: page 4]

Se Puso +5V_SPI_FUSE por el tema
de la capacidad de corriente. Si fuera
directo del regulador LDO no tendria la
capacidad de proveer la corriente. Esto
implicaria que la funcion de Host, solo
funcionaria con una entrada de +12V
conectada.

Por el tipo de power swith usado, la
funcion de FAULT no se usaria en este
modelo.

Título: Modulo de Control | Autor: SantiagoMillicay | PRAXIS Diego Coll y Santiago Millicay Argentina, La Rioja, Capital (5300)

Diego Coll | Facultad Regional La Rioja

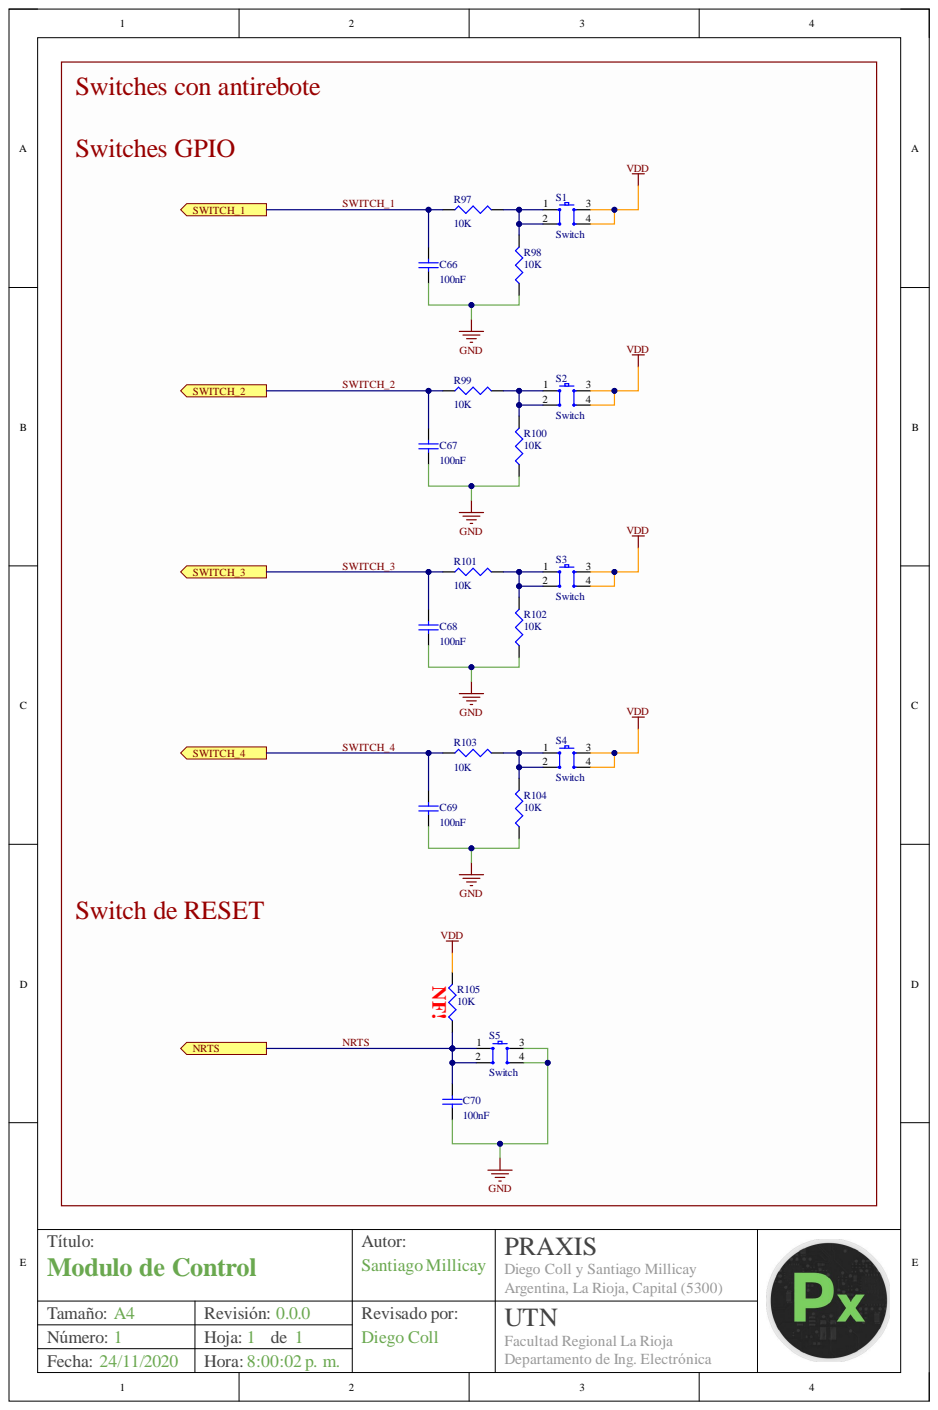
[picture p67: page 5]

PRAXIS
Diego Coll y Santiago Millicay
Argentina, La Rioja, Capital (5300)

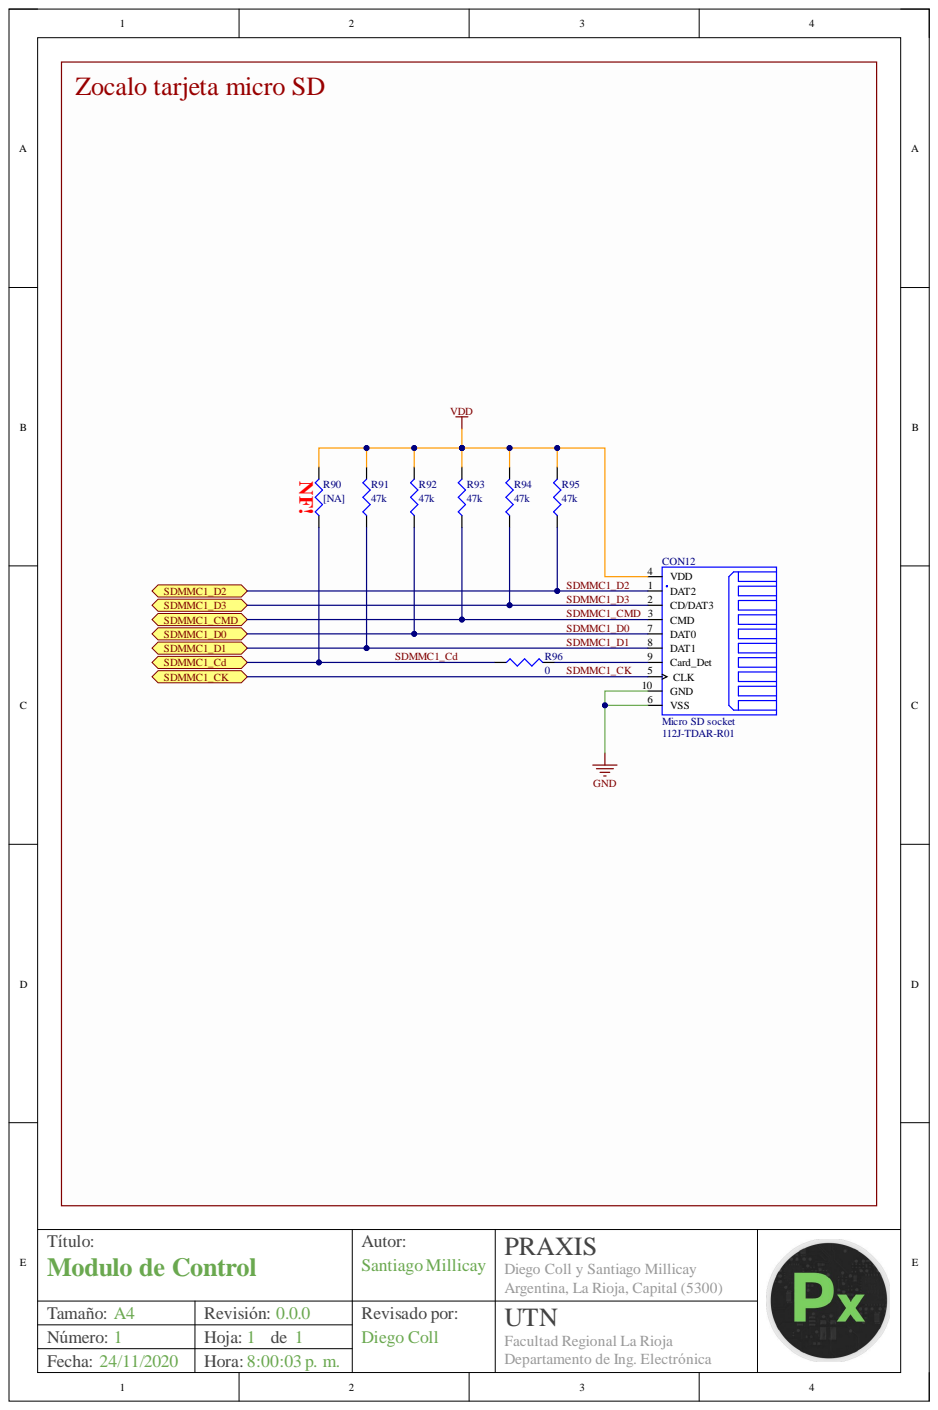
[picture p68: page 6]

Zocalo tarjeta micro SD

PRAXIS
Diego Coll y Santiago Millicay
Argentina, La Rioja, Capital (5300)

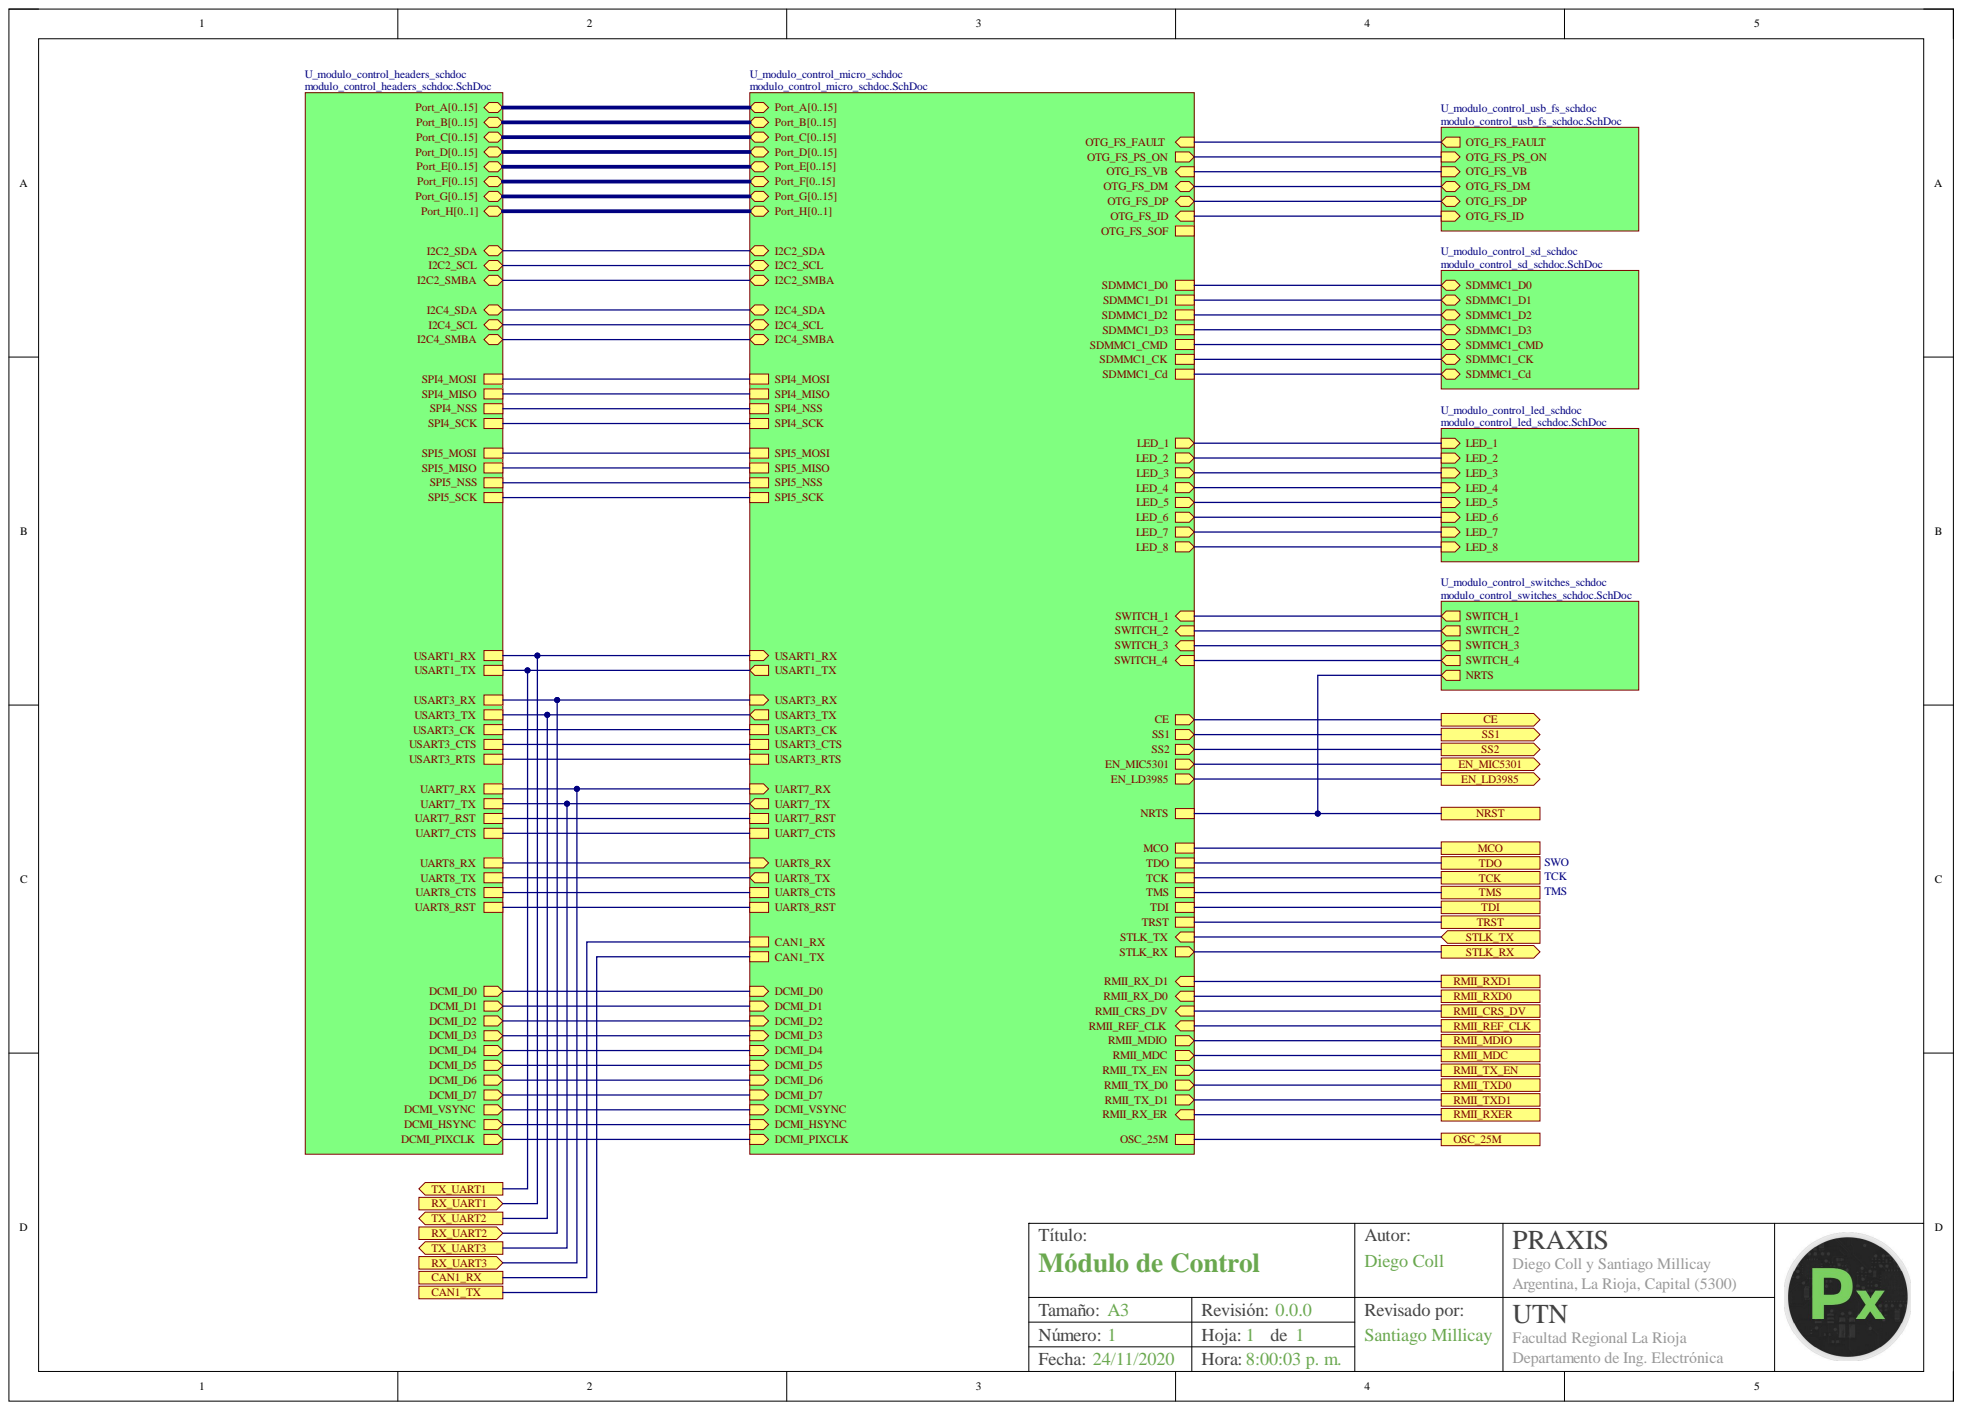
[picture p69: page 7]

Diego Coll y Santiago Millicay
Argentina, La Rioja, Capital (5300)

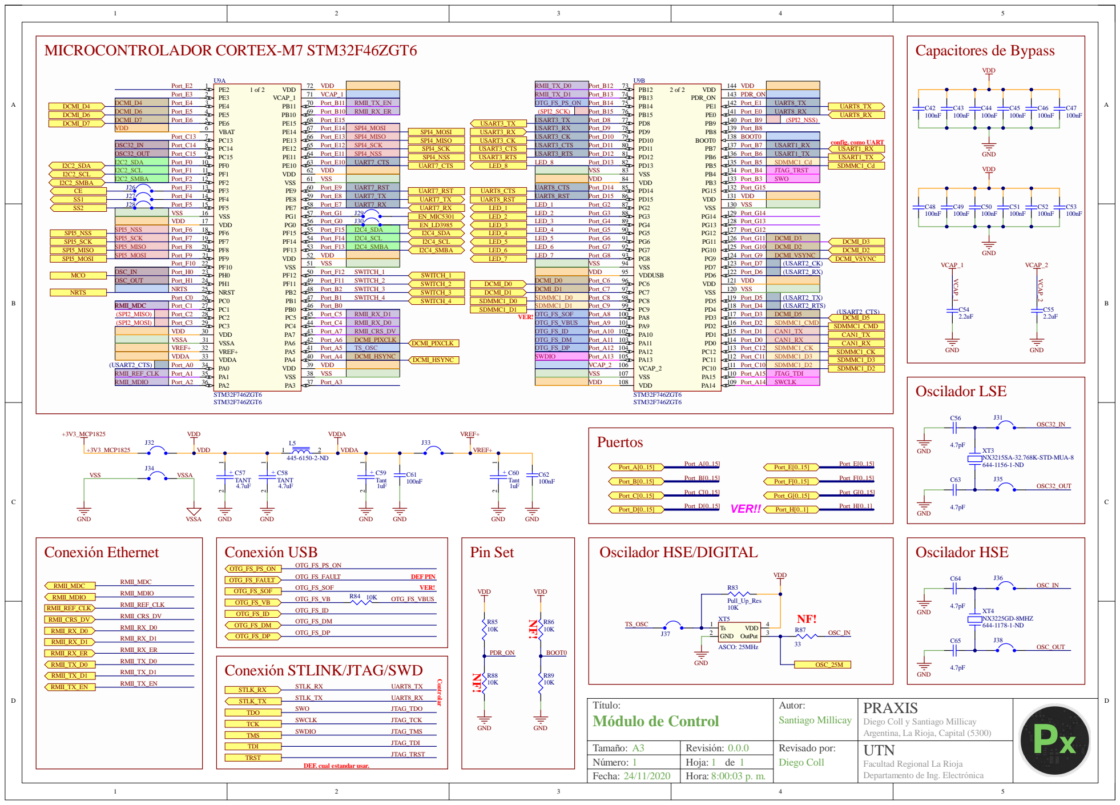
[picture p70: page 8]

OSC32_IN | Port_C14 | PC14 8 | Port_E12 | SPI4_SCK | USART3_CTS | Port_D11 | PD11 80 | Port_B7 | USART1_RX

SPI4_MISO | USART3_CK

I2C2_SDA | Port_F0 | PF0 10 | Port_E10 | UART7_CTS | SPI4_NSS | USART3_RTS | Port_D13 | PD13 82 | Port_B5 | SDMMC1_Cd

RMII_MDC | Port_C1 | PC1 27 | Port_B0 | SDMMC1_D0 | SDMMC1_D1 | Port_C9 | PC9 99 | Port_D4

Conexión STLINK/JTAG/SWD

Diego Coll y Santiago Millicay
Argentina, La Rioja, Capital (5300)

DEF. cual estandar usar.

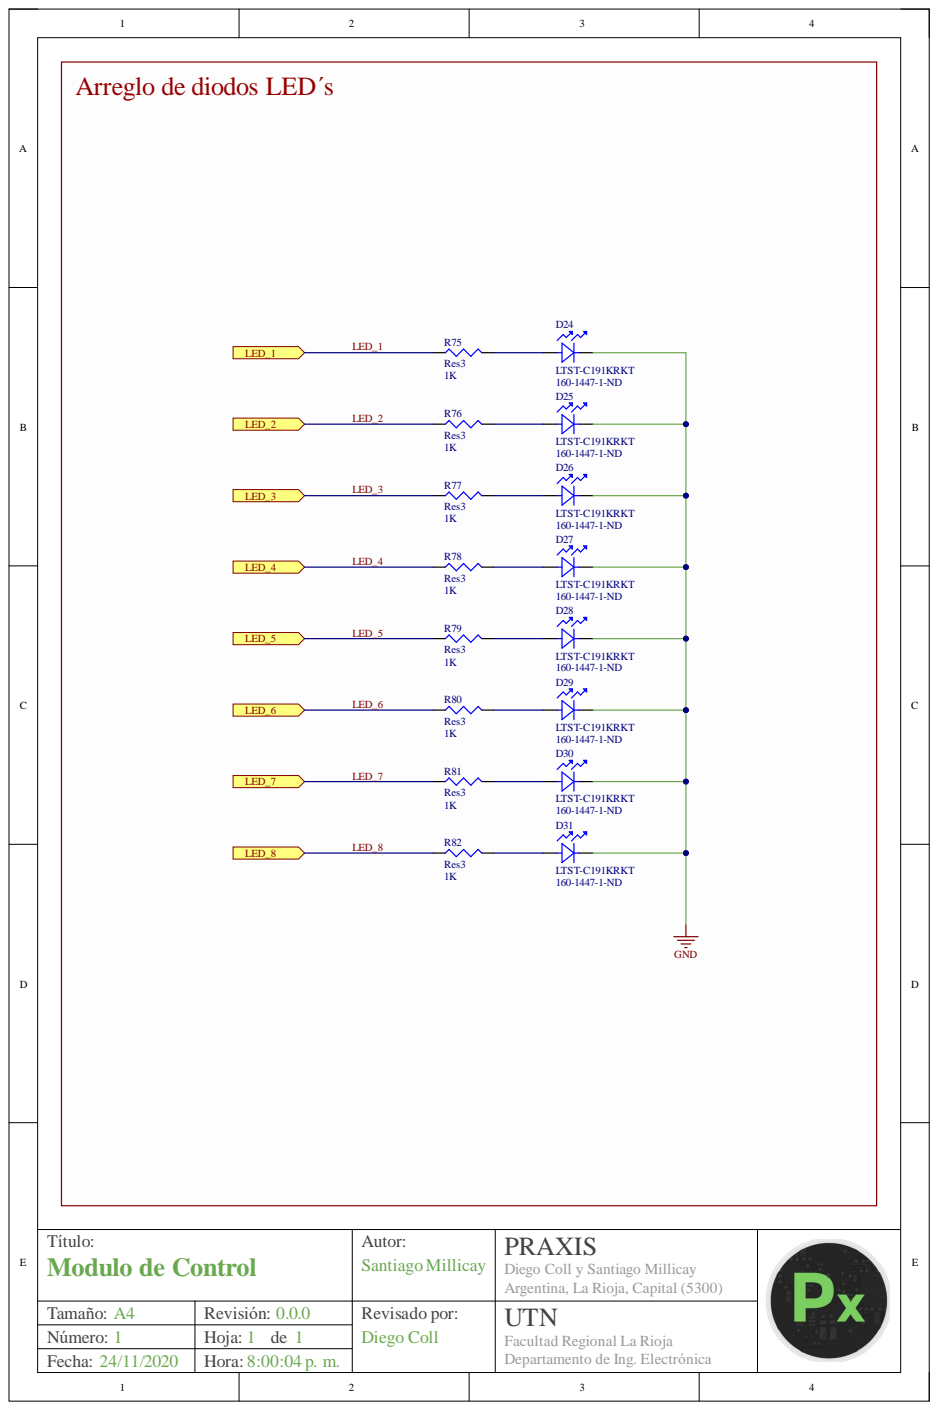
[picture p71: page 9]

Arreglo de diodos LED´s

PRAXIS
Diego Coll y Santiago Millicay
Argentina, La Rioja, Capital (5300)

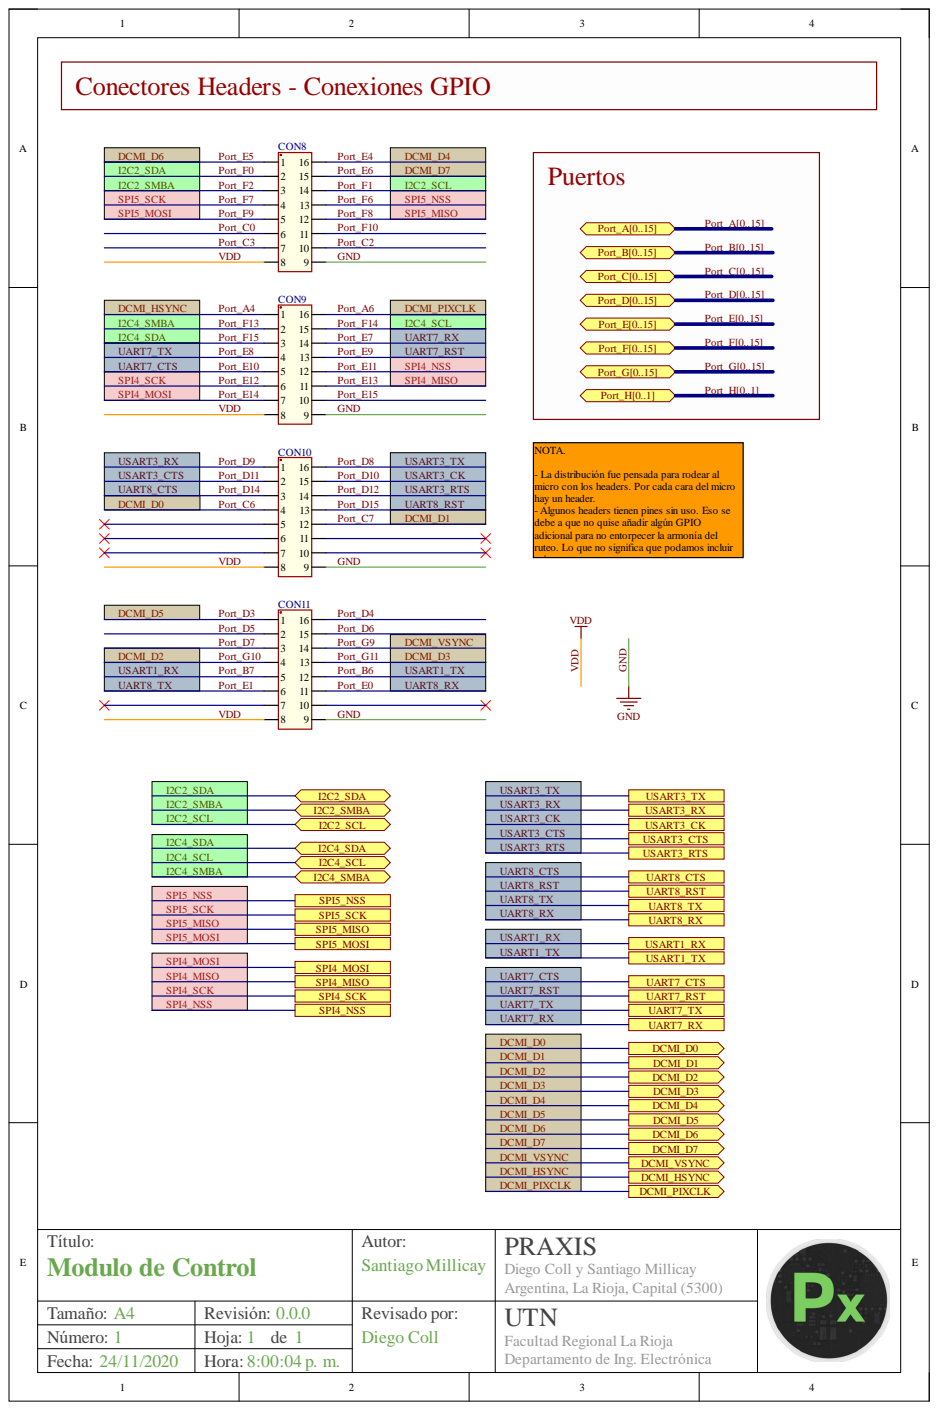
[picture p72: page 10]

Conectores Headers - Conexiones GPIO

I2C2_SDA | Port_F0 | Port_E6 | DCMI_D7
I2C2_SMBA | Port_F2 | Port_F1 | I2C2_SCL
SPI5_SCK | Port_F7 | Port_F6 | SPI5_NSS
SPI5_MOSI | Port_F9 | Port_F8 | SPI5_MISO

I2C4_SMBA | Port_F13 | Port_F14 | I2C4_SCL
I2C4_SDA | Port_F15 | Port_E7 | UART7_RX
UART7_TX | Port_E8 | Port_E9 | UART7_RST
UART7_CTS | Port_E10 | Port_E11 | SPI4_NSS
SPI4_SCK | Port_E12 | Port_E13 | SPI4_MISO
SPI4_MOSI | Port_E14 | Port_E15

USART3_CTS | Port_D11 | Port_D10 | USART3_CK
UART8_CTS | Port_D14 | Port_D12 | USART3_RTS
DCMI_D0 | Port_C6 | Port_D15 | UART8_RST

- La distribución fue pensada para rodear al
micro con los headers. Por cada cara del micro
hay un header.
- Algunos headers tienen pines sin uso. Eso se
debe a que no quise añadir algún GPIO
adicional para no entorpecer la armonía del
ruteo. Lo que no significa que podamos incluir
más puertos.

Port_C7 | DCMI_D1

DCMI_D2 | Port_G10 | Port_G11 | DCMI_D3
USART1_RX | Port_B7 | Port_B6 | USART1_TX
UART8_TX | Port_E1 | Port_E0 | UART8_RX

USART3_CTS | USART3_CK

UART8_RST | UART8_CTS

PRAXIS
Diego Coll y Santiago Millicay
Argentina, La Rioja, Capital (5300)

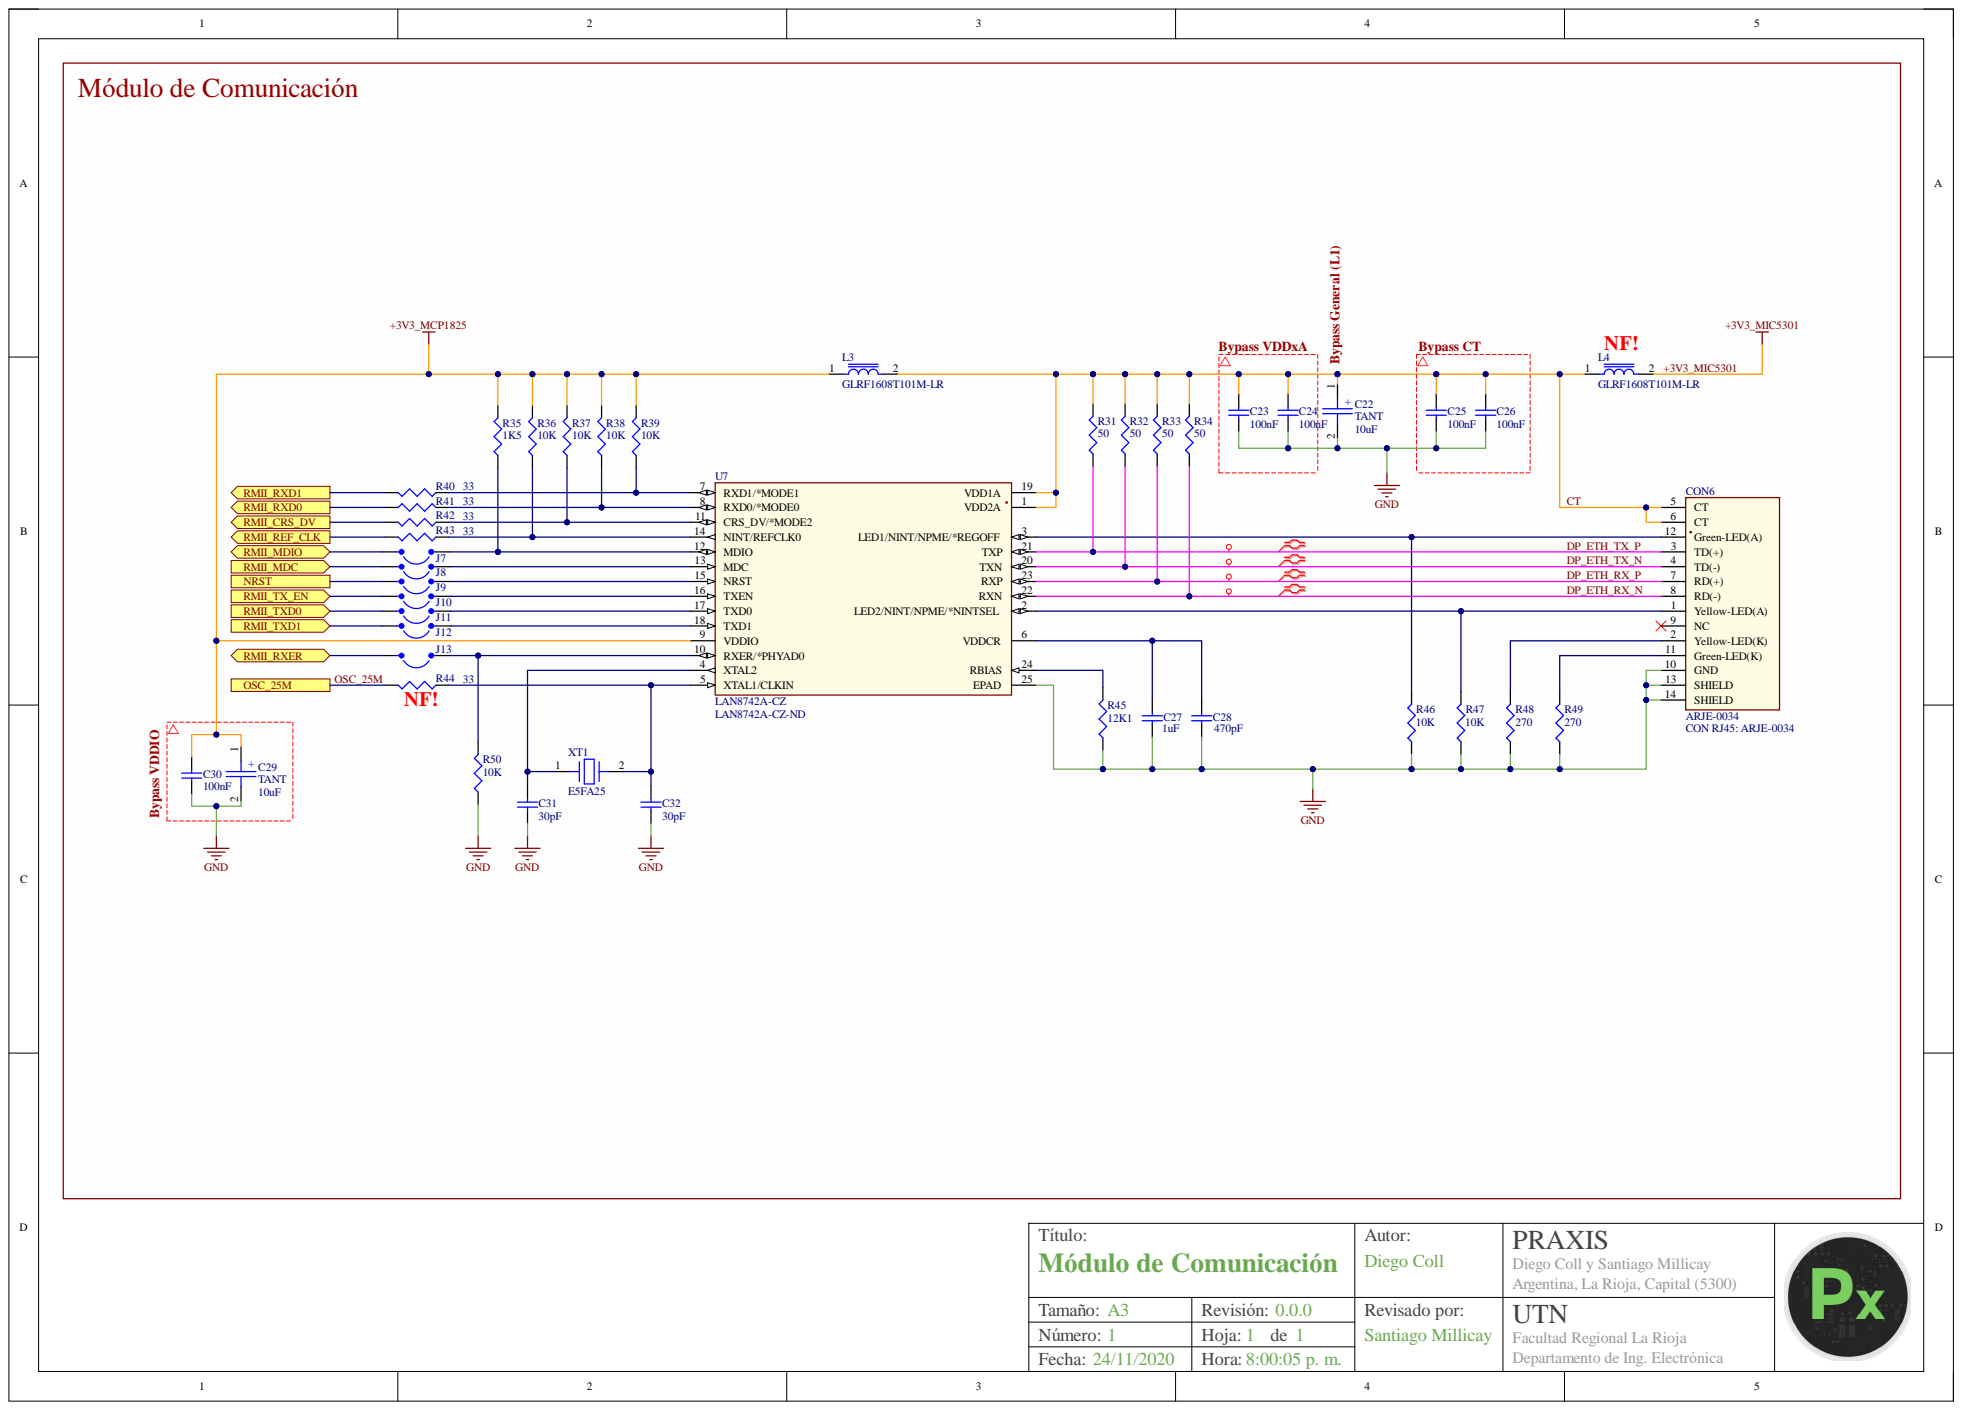
[picture p73: page 11]

Bypass CT Bypass General (L1)

DP_ETH_TX_N | TD(-) 4
DP_ETH_RX_P | RD(+) 7

Diego Coll y Santiago Millicay
Argentina, La Rioja, Capital (5300)

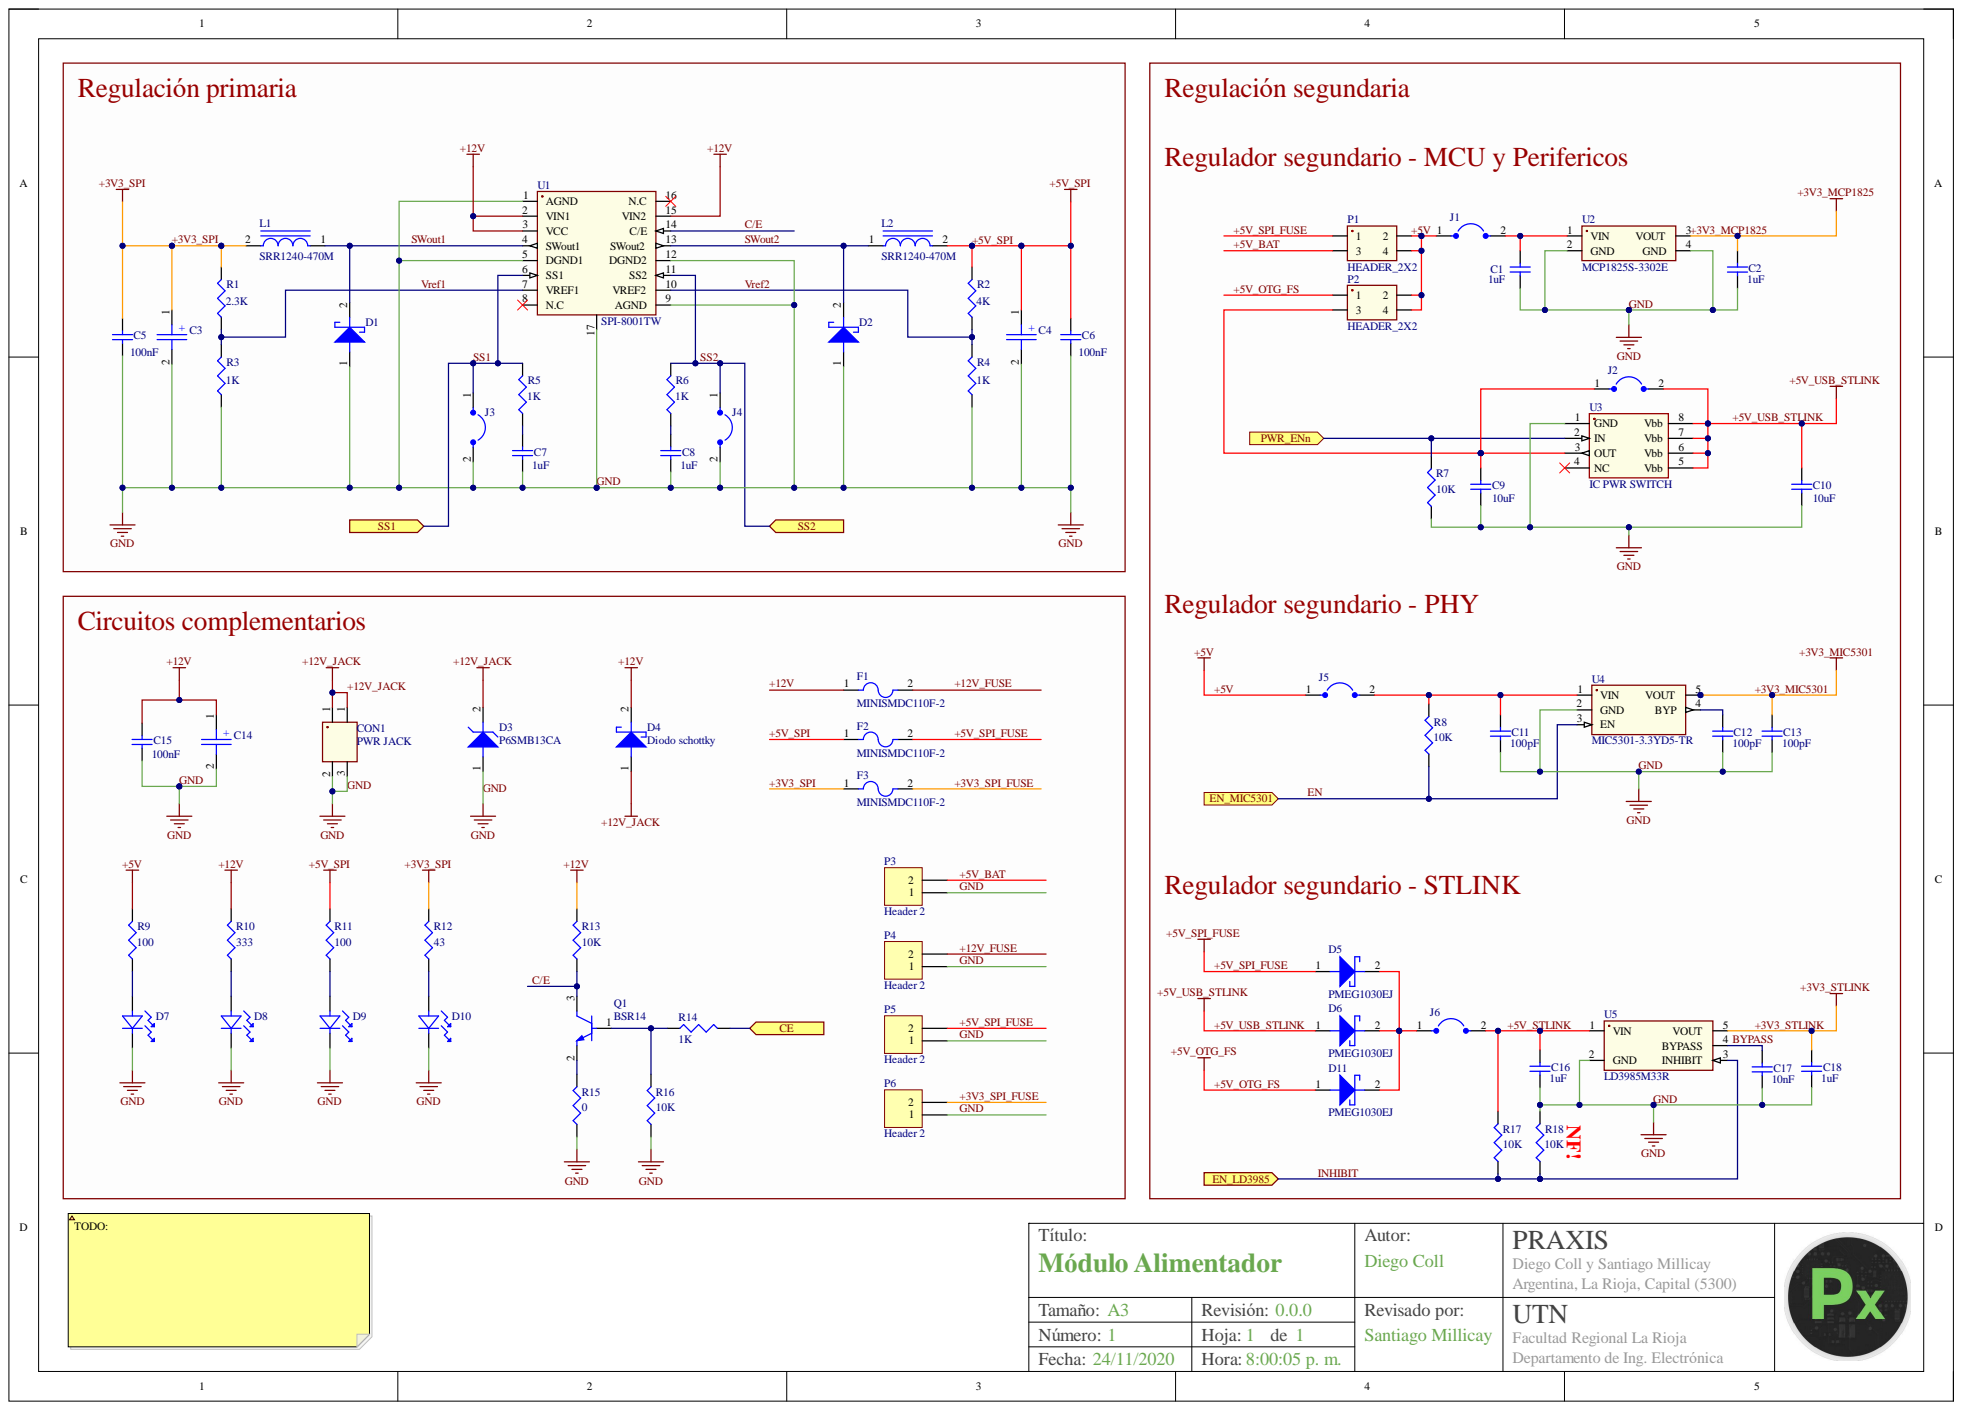
[picture p74: page 12]

Regulador segundario - MCU y Perifericos

SWout1 | VIN1 2

VCC 3

VREF1 7

Diego Coll y Santiago Millicay
Argentina, La Rioja, Capital (5300)

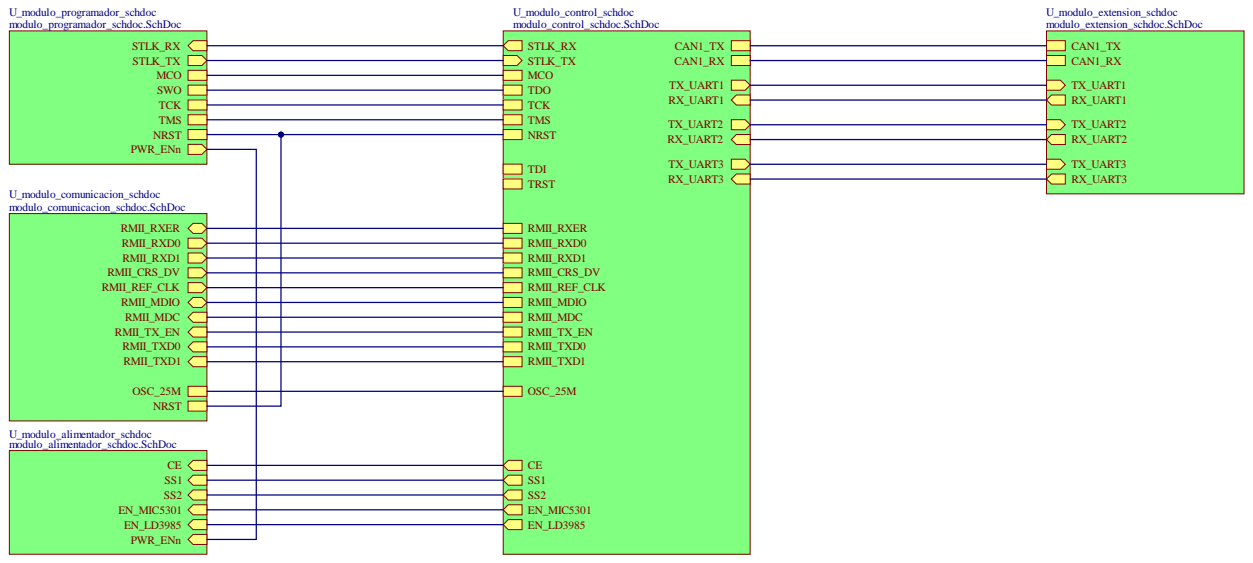
[picture p75: page 13]

Diego Coll y Santiago Millicay
Argentina, La Rioja, Capital (5300)

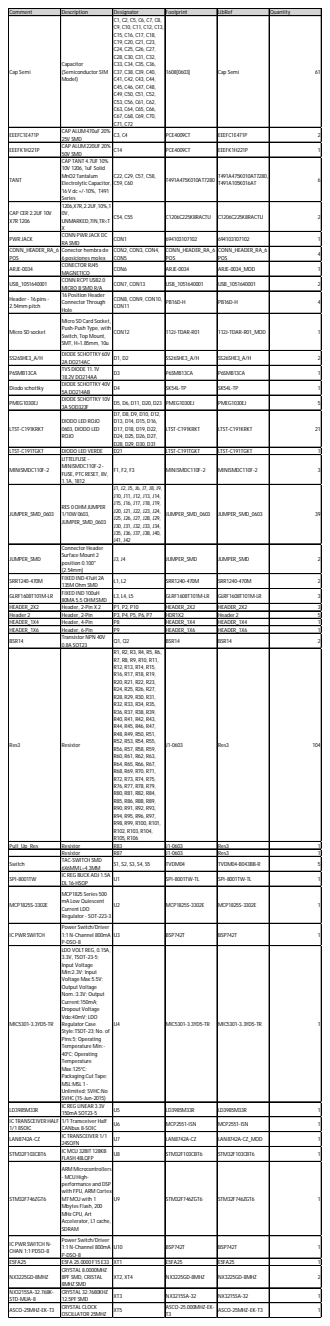
[picture p76: page 14]

EEEFC1E471P | CAP ALUM 470uF 20% 25V SMD | C3, C4 | PCE4009CT | EEEFC1E471P | | 2

EEEFK1H221P | CAP ALUM 220UF 20% 50V SMD | C14 | PCE4009CT | EEEFK1H221P | | 1

TANT | CAP TANT 4.7UF 10% 10V 1206, 1uF Solid MnO2 Tantalum Electrolytic Capacitor, 16 V dc +/-10%, T491 Series | C22, C29, C57, C58, C59, C60 | T491A475K010AT7280 | T491A475K010AT7280, T491A105K016AT | | 6

CAP CER 2.2UF 10V X7R 1206 | 1206,X7R,2.2UF,10%,1 0V, UNMARKED,7IN,TR<T X | C54, C55 | C1206C225K8RACTU | C1206C225K8RACTU | | 2

PWR JACK | CONN PWR JACK DC RA SMD | CON1 | 694103107102 | 694103107102 | | 1

CONN_HEADER_RA_6 POS | Conector hembra de 6 posiciones molex | CON2, CON3, CON4, CON5 | CONN_HEADER_RA_6 POS | CONN_HEADER_RA_6 POS | | 4

ARJE-0034 | CONECTOR RJ45 MAGNETICO | CON6 | ARJE-0034 | ARJE-0034_MOD | | 1

USB_1051640001 | CONN RCPT USB2.0 MICRO B SMD R/A | CON7, CON13 | USB_1051640001 | USB_1051640001 | | 2

Header - 16 pins -2.54mm pitch | 16 Position Header Connector Through Hole | CON8, CON9, CON10, CON11 | PB16D-H | PB16D-H | | 4

Micro SD socket | Micro SD Card Socket, Push-Push Type, with Switch, Top Mount, SMT, H=1.85mm, 10u | CON12 | 112J-TDAR-R01 | 112J-TDAR-R01_MOD | | 1

SS26SHE3_A/H | DIODE SCHOTTKY 60V 2A DO214AC | D1, D2 | SS26SHE3_A/H | SS26SHE3_A/H | | 2

P6SMB13CA | TVS DIODE 11.1V 18.2V DO214AA | D3 | P6SMB13CA | P6SMB13CA | | 1

Diodo schottky | DIODE SCHOTTKY 40V 5A DO214AB | D4 | SK54L-TP | SK54L-TP | | 1

PMEG1030EJ | DIODE SCHOTTKY 10V 3A SOD323F | D5, D6, D11, D20, D23 | PMEG1030EJ | PMEG1030EJ | | 5

LTST-C191KRKT | DIODO LED ROJO 0603, DIODO LED ROJO | D7, D8, D9, D10, D12, D13, D14, D15, D16, D17, D18, D19, D22, D24, D25, D26, D27, D28, D29, D30, D31 | LTST-C191KRKT | LTST-C191KRKT | 21

LTST-C191TGKT | DIODO LED VERDE | D21 | LTST-C191TGKT | LTST-C191TGKT | | 1
MINISMDC110F-2 | LITTELFUSE -MINISMDC110F-2 -FUSE, PTC RESET, 8V, 1.1A, 1812 | F1, F2, F3 | MINISMDC110F-2 | MINISMDC110F-2 | | 3

JUMPER_SMD_0603 | RES 0OHM JUMPER 1/10W 0603, JUMPER_SMD_0603 | J1, J2, J5, J6, J7, J8, J9, J10, J11, J12, J13, J14, J15, J16, J17, J18, J19, J20, J21, J22, J23, J24, J25, J26, J27, J28, J29, J30, J31, J32, J33, J34, J35, J36, J37, J38, J40, J41, J42 | JUMPER_SMD_0603 | JUMPER_SMD_0603 | 39

JUMPER_SMD | Connector Header Surface Mount 2 position 0.100" (2.54mm) | J3, J4 | JUMPER_SMD | JUMPER_SMD | | 2

SRR1240-470M | FIXED IND 47uH 2A 135M Ohm SMD | L1, L2 | SRR1240-470M | SRR1240-470M | | 2

GLRF1608T101M-LR | FIXED IND 100uH 80MA 5.5OHM SMD | L3, L4, L5 | GLRF1608T101M-LR | GLRF1608T101M-LR | | 3

HEADER_2X2 | Header, 2-Pin X 2 | P1, P2, P10 | HEADER_2X2 | HEADER_2X2 | | 3
Header 2 | Header, 2-Pin | P3, P4, P5, P6, P7 | HDR1X2 | Header 2 | | 5
HEADER_1X4 | Header, 4-Pin | P8 | HEADER_1X4 | HEADER_1X4 | | 1
HEADER_1X6 | Header, 6-Pin | P9 | HEADER_1X6 | HEADER_1X6 | | 1
BSR14 | Transistor NPN 40V 0.8A SOT23 | Q1, Q2 | BSR14 | BSR14 | | 2

Res3 | Resistor | R1, R2, R3, R4, R5, R6, R7, R8, R9, R10, R11, R12, R13, R14, R15, R16, R17, R18, R19, R20, R21, R22, R23, R24, R25, R26, R27, R28, R29, R30, R31, R32, R33, R34, R35, R36, R37, R38, R39, R40, R41, R42, R43, R44, R45, R46, R47, R48, R49, R50, R51, R52, R53, R54, R55, R56, R57, R58, R59, R60, R61, R62, R63, R64, R65, R66, R67, R68, R69, R70, R71, R72, R73, R74, R75, R76, R77, R78, R79, R80, R81, R82, R84, R85, R86, R88, R89, R90, R91, R92, R93, R94, R95, R96, R97, R98, R99, R100, R101, R102, R103, R104, R105, R106 | J1-0603 | Res3 | 104

Pull_Up_Res | Resistor | R83 | J1-0603 | Res3 | | 1

Switch | TAC-SWITCH SMD 6X6MM L=4.3MM | S1, S2, S3, S4, S5 | TVDM04 | TVDM04-B043BB-R | | 5

Resistor | R87 | J1-0603 | Res3 | | 1

SPI-8001TW | IC REG BUCK ADJ 1.5A DL 16-HSOP | U1 | SPI-8001TW-TL | SPI-8001TW-TL | | 1

MCP1825S-3302E | MCP1825 Series 500 mA Low Quiescent Current LDO Regulator - SOT-223-3 | U2 | MCP1825S-3302E | MCP1825S-3302E | | 1

IC PWR SWITCH | Power Switch/Driver 1:1 N-Channel 800mA P-DSO-8 | U3 | BSP742T | BSP742T | | 1

MIC5301-3.3YD5-TR | LDO VOLT REG, 0.15A, 3.3V, TSOT-23-5; Input Voltage Min:2.3V; Input Voltage Max:5.5V; Output Voltage Nom.:3.3V; Output Current:150mA; Dropout Voltage Vdo:40mV; LDO Regulator Case Style:TSOT-23; No. of Pins:5; Operating Temperature Min:-40°C; Operating Temperature Max:125°C; Packaging:Cut Tape; MSL:MSL 1 -Unlimited; SVHC:No SVHC (15-Jun-2015) | U4 | MIC5301-3.3YD5-TR | MIC5301-3.3YD5-TR | | 1

LD3985M33R | IC REG LINEAR 3.3V 150mA SOT23-5 | U5 | LD3985M33R | LD3985M33R | | 1

IC TRANSCEIVER HALF 1/1 8SOIC | 1/1 Transceiver Half CANbus 8-SOIC | U6 | MCP2551-ISN | MCP2551-ISN | | 1

LAN8742A-CZ | IC TRANSCEIVER 1/1 24SQFN | U7 | LAN8742A-CZ | LAN8742A-CZ_MOD | | 1

STM32F103CBT6 | IC MCU 32BIT 128KB FLASH 48LQFP | U8 | STM32F103CBT6 | STM32F103CBT6 | | 1

STM32F746ZGT6 | ARM Microcontrollers - MCU High-performance and DSP with FPU, ARM Cortex-M7 MCU with 1 Mbytes Flash, 200 MHz CPU, Art Accelerator, L1 cache, SDRAM | U9 | STM32F746ZGT6 | STM32F746ZGT6 | | 1

IC PWR SWITCH N-CHAN 1:1 PDSO-8 | Power Switch/Driver 1:1 N-Channel 800mA P-DSO-8 | U10 | BSP742T | BSP742T | | 1

E5FA25 | E5FA 25.0000 F15 E33 | XT1 | E5FA25 | E5FA25 | | 1
NX3225GD-8MHZ | CRYSTAL 8.0000MHZ 8PF SMD, CRISTAL 8MHZ SMD | XT2, XT4 | NX3225GD-8MHZ | NX3225GD-8MHZ | | 2

NX3215SA-32.768K-STD-MUA-8 | CRYSTAL 32.7680KHZ 12.5PF SMD | XT3 | NX3215SA-32 | NX3215SA-32 | | 1

ASCO-25MHZ-EK-T3 | CRYSTAL CLOCK OSCILLATOR 25MHZ | XT5 | ASCO-25.000MHZ-EK-T3 | ASCO-25MHZ-EK-T3 | | 1
