diegocoll/top_level_pcb/praxis_top_level_shcdoc.pdf

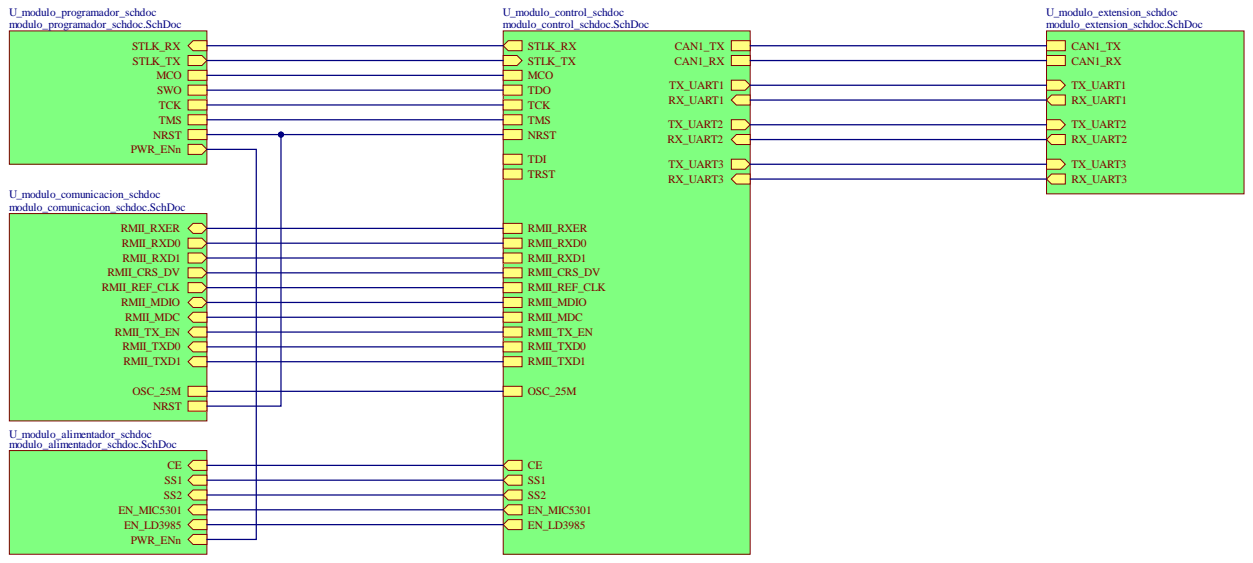
[picture p77: page 1]

Diego Coll y Santiago Millicay
Argentina, La Rioja, Capital (5300)

Tamaño: | Revisión: *
Número: * | Hoja: de *

Departamento de Ing. Electrónica
