diegocoll/top_level_pcb/Modulo de programador/Altium/Componentes/USB_1051640001/USB_1051640001.pdf

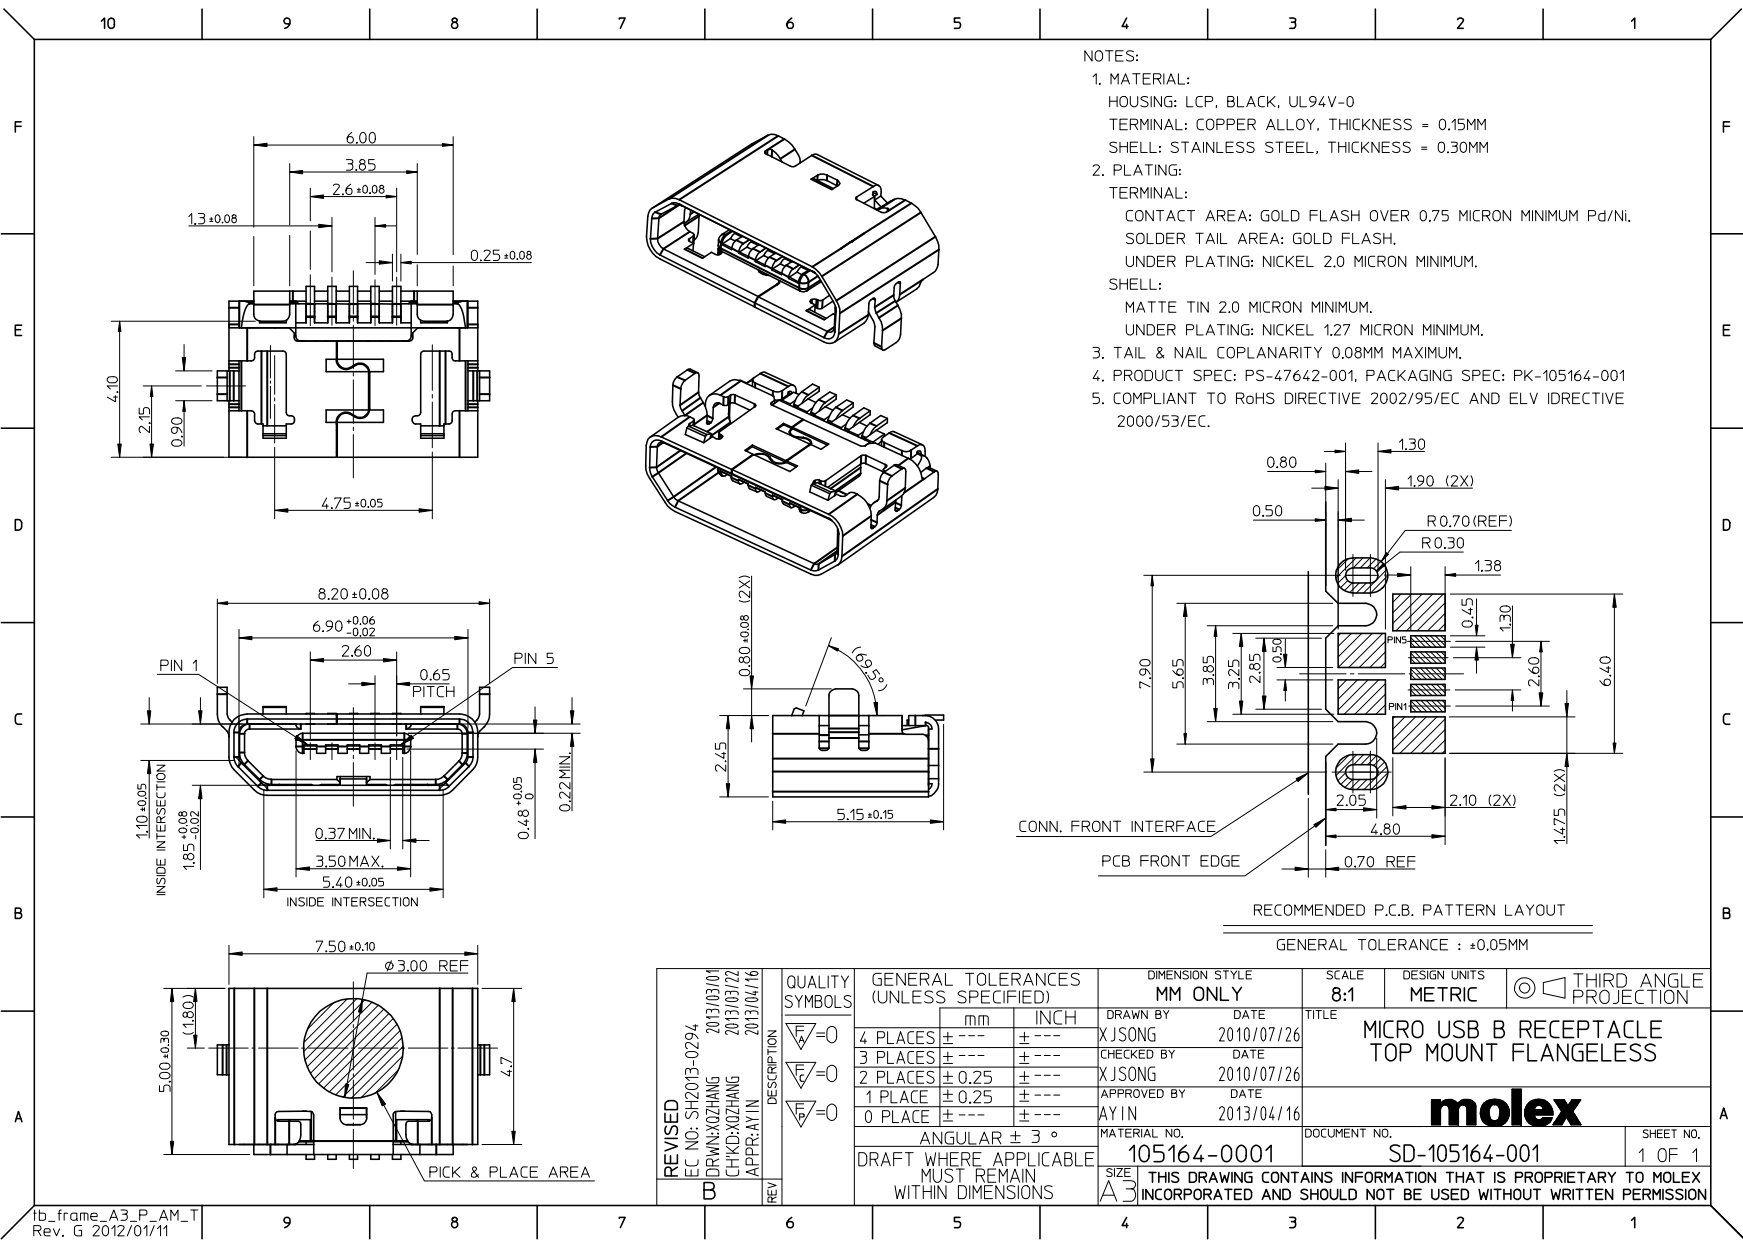
[picture p78: page 1]
