diegocoll/top_level_pcb/praxis_top_level_pcbdoc_v3.pdf

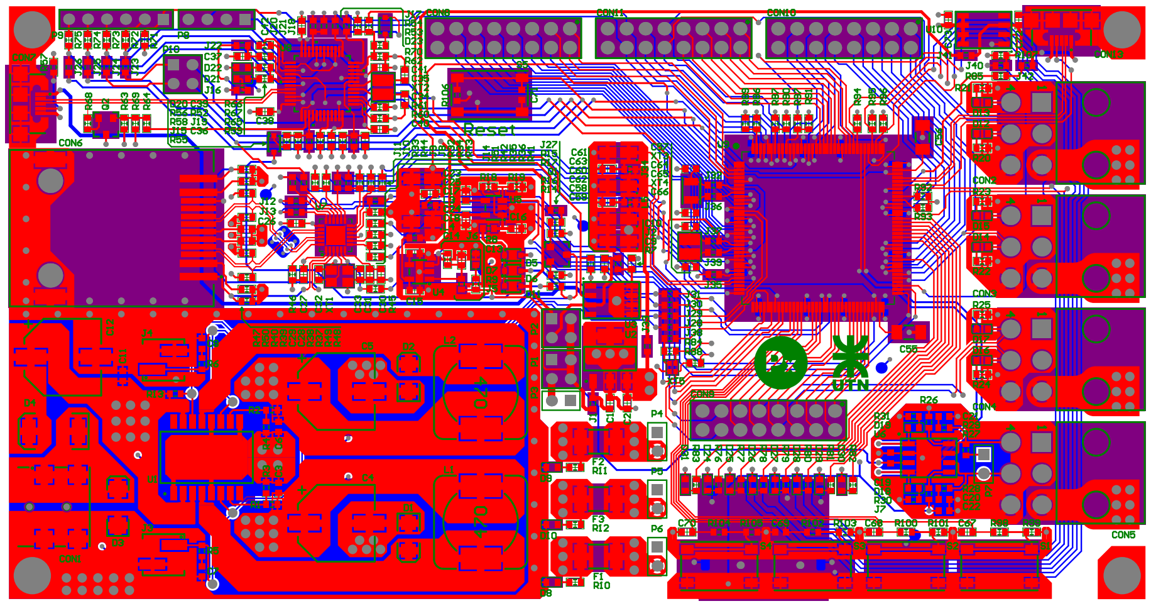
[picture p79: page 1]
