diegocoll/top_level_pcb/praxis_top_level_pcbdoc_v2.pdf

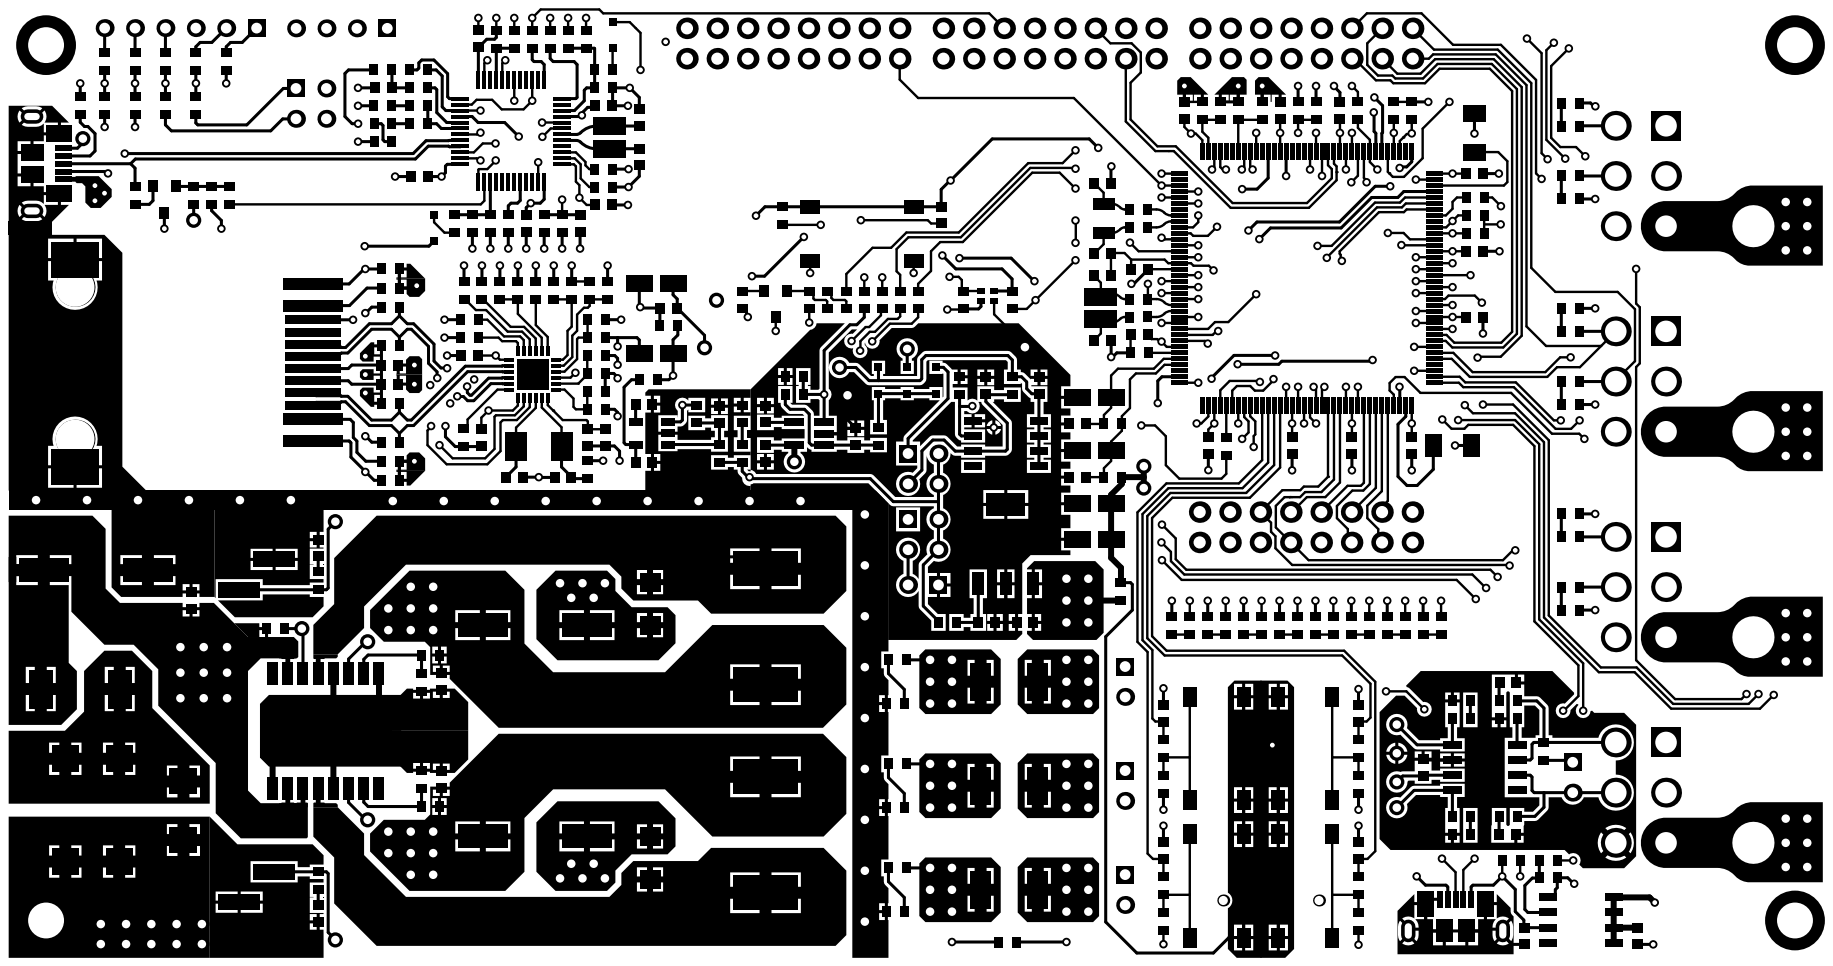
[picture p80: page 1]
