diegocoll/top_level_pcb/(list of files, drawings)

Other design files:
Modulo de alimentador/Altium/Componentes/LD3985M33R/AltiumDesigner/2020-03-27_06-20-10/2020-03-27_06-20-10.PcbLib
Modulo de alimentador/Altium/Componentes/LD3985M33R/AltiumDesigner/2020-03-27_06-20-10/2020-03-27_06-20-10.SchLib
Modulo de alimentador/Altium/Componentes/MCP1825S-3302E/AltiumDesigner/2020-03-27_02-06-16/2020-03-27_02-06-16.PcbLib
Modulo de alimentador/Altium/Componentes/MCP1825S-3302E/AltiumDesigner/2020-03-27_02-06-16/2020-03-27_02-06-16.SchLib
Modulo de alimentador/Altium/Componentes/MIC5301-3.3YD5-TR/AltiumDesigner/2020-03-27_05-35-59/2020-03-27_05-35-59.PcbLib
Modulo de alimentador/Altium/Componentes/MIC5301-3.3YD5-TR/AltiumDesigner/2020-03-27_05-35-59/2020-03-27_05-35-59.SchLib
Modulo de alimentador/Altium/Componentes/modulo_alimentador_pcblib.PcbLib
Modulo de alimentador/Altium/Componentes/modulo_alimentador_schlib.SchLib
Modulo de alimentador/Altium/modulo_alimentador_pcbdoc.PcbDoc
Modulo de alimentador/Altium/modulo_alimentador_prjpcb.PrjPcb
Modulo de alimentador/Altium/modulo_alimentador_schdoc.SchDoc
Modulo de alimentador/Simulación/simulacion_modulo_alimentador/praxis_top_level_pcbdoc_v3_alimentador.PcbDoc
Modulo de alimentador/Simulación/simulacion_modulo_alimentador/simulacion_modulo_alimentador.PrjPcb
Modulo de comunicación/Altium/Componentes/ARJE-0034/AltiumDesigner/2020-04-03_05-14-13/2020-04-03_05-14-13.PcbLib
Modulo de comunicación/Altium/Componentes/ARJE-0034/AltiumDesigner/2020-04-03_05-14-13/2020-04-03_05-14-13.SchLib
Modulo de comunicación/Altium/Componentes/LAN8742A-CZ/AltiumDesigner/2020-03-28_05-44-17/2020-03-28_05-44-17.PcbLib
Modulo de comunicación/Altium/Componentes/LAN8742A-CZ/AltiumDesigner/2020-03-28_05-44-17/2020-03-28_05-44-17.SchLib
Modulo de comunicación/Altium/Componentes/modulo_comunicacion_pcblib.PcbLib
Modulo de comunicación/Altium/Componentes/modulo_comunicacion_schlib.SchLib
Modulo de comunicación/Altium/modulo_comunicacion_pcbdoc.PcbDoc
Modulo de comunicación/Altium/modulo_comunicacion_prjpcb.PrjPcb
Modulo de comunicación/Altium/modulo_comunicacion_schdoc.SchDoc
Modulo de extensiones/Altium/Componentes/MICROSMD110F2/Imported MICROSMD110F-2.lia/MICROSMD110F-2.PcbLib
Modulo de extensiones/Altium/Componentes/MICROSMD110F2/Imported MICROSMD110F-2.lia/MICROSMD110F-2.SchLib
Modulo de extensiones/Altium/Componentes/MINISMDC110F2/Fuse_Littelfuse_MINISMDC110F-2_eec.SchLib
Modulo de extensiones/Altium/Componentes/MINISMDC110F2/Fuse_Littelfuse_MINISMDC110F-2_eec_0.PcbLib
Modulo de extensiones/Altium/Componentes/modulo_extension_pcblib.PcbLib
Modulo de extensiones/Altium/Componentes/modulo_extension_schlib.SchLib
Modulo de extensiones/Altium/modulo_extension_prjpcb.PrjPcb
Modulo de extensiones/Altium/modulo_extension_schdoc.SchDoc
Modulo de programador/Altium/Componentes/LTST-C191TGKT/AltiumDesigner/2020-03-28_23-27-57/2020-03-28_23-27-57.PcbLib
Modulo de programador/Altium/Componentes/LTST-C191TGKT/AltiumDesigner/2020-03-28_23-27-57/2020-03-28_23-27-57.SchLib
Modulo de programador/Altium/Componentes/modulo_programador_pcblib.PcbLib
Modulo de programador/Altium/Componentes/modulo_programador_schlib.SchLib
Modulo de programador/Altium/Componentes/NX3225GD-8MHZ/AltiumDesigner/2020-03-29_20-06-19/2020-03-29_20-06-19.PcbLib
Modulo de programador/Altium/Componentes/NX3225GD-8MHZ/AltiumDesigner/2020-03-29_20-06-19/2020-03-29_20-06-19.SchLib
Modulo de programador/Altium/Componentes/PMEG1030EJ/AltiumDesigner/2020-03-29_19-02-12/2020-03-29_19-02-12.PcbLib
Modulo de programador/Altium/Componentes/PMEG1030EJ/AltiumDesigner/2020-03-29_19-02-12/2020-03-29_19-02-12.SchLib
Modulo de programador/Altium/Componentes/STM32F103CBT6/AltiumDesigner/2020-03-28_20-59-39/2020-03-28_20-59-39.PcbLib
Modulo de programador/Altium/Componentes/STM32F103CBT6/AltiumDesigner/2020-03-28_20-59-39/2020-03-28_20-59-39.SchLib
Modulo de programador/Altium/modulo_programador_prjpcb.PrjPcb
Modulo de programador/Altium/modulo_programador_schdoc.SchDoc
PCB plantilla/pcb_plantilla_praxis.PcbDoc
praxis_top_level_pcbdoc.PcbDoc
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
