diegocoll/top_level_pcb/(commit log)

2021-07-18 cuarto push
    [1x6 TH Pitch 2_54mm.STEP, 2020-03-27_02-06-16.PcbLib, 2020-03-27_02-06-16.SchLib, 2020-03-27_05-35-59.PcbLib, 2020-03-27_05-35-59.SchLib, 2020-03-27_06-20-10.PcbLib, 2020-03-27_06-20-10.SchLib, 2020-03-28_05-44-17.PcbLib]
2021-07-24 habilitacion del plano GND, que estaba oculto.
2021-07-25 inicio del checklist del modulo de extenciones
2021-07-26 correcciones en base al checklist de modulo
2021-07-26 correcciones de estilo segun checklist
    [praxis_top_level_shcdoc.SchDoc]
2021-07-29 eliminacion de angulos de 90°en los pares diferenciales entre el rj45 y el phy, agregado de resistencia pull-up a 5v en el pin de habilitacion del spi8001
    [praxis_top_level_prjpcb.PrjPcb]
2021-07-29 se ejecuto la asignacion de anotationes/desigandores automatico. se tiene que hacer un update de todos los sheets y controlar los silkscreen
2021-07-29 actualizacion del silkscreen segun la asignacion automatica de designadores.
2021-07-30 modificaciones descagadas luego de la sincronizacion de pc santiago
2021-08-01 Correcciones en el layout segun checklist
2021-08-04 ajustes segun checklisk de layout.
2021-08-05 Se realizaron muchas correcciones de detalles que surgieron por el proceso de checklist. Hasta el momento no se encontraron problemas graves
2021-08-06 correcciones de alineacion en el PCB Final
2021-08-11 Modificaciones y correcciones realizadas segun checklist. se cambio el orden de los leds para que tenga un sentido mas adecuado a la posiscion de los componentes. se eleminaron un par vias que eran i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
2021-08-11 eliminacion de draftman y creado de uno nuevo.
    [praxis_top_level_prjpcb.PrjPcb]
2021-08-30 alineacion del ic_can con el conector
    [2020-04-06_03-04-41.PcbLib, 2020-04-06_03-04-41.SchLib, 2020-04-06_13-32-46.PcbLib, 2020-04-06_13-32-46.SchLib, 2020-04-06_13-41-43.PcbLib, 2020-04-06_13-41-43.SchLib, ABMM2.STEP, CRYSTAL_ABMM2_ABR-L.step]
2021-10-14 Ultima modificacion del proyecto previo envio a fabricación.
    [praxis_top_level_prjpcb.PrjPcb]
