diegocoll/top_level_pcb/(notices)

Notices in the files:
Modulo de alimentador/Altium/Componentes/JUMPER/TSM-102-01-L-SV-TR.stp:
FILE_NAME( 'p:/temp/worker_133/temp/exporttempdir_6244_124_z4T8F/format_0/TSM-102-01-L-SV-TR.stp', '2020-03-26T20:50:46', ( 'License CC BY-ND 4.0' ), ( 'CADENAS' ), ' ', 'PARTsolutions', ' ' );
